angryseptagon/tDCSDisposable/photos and videos/IMG_20190513_121614.jpg

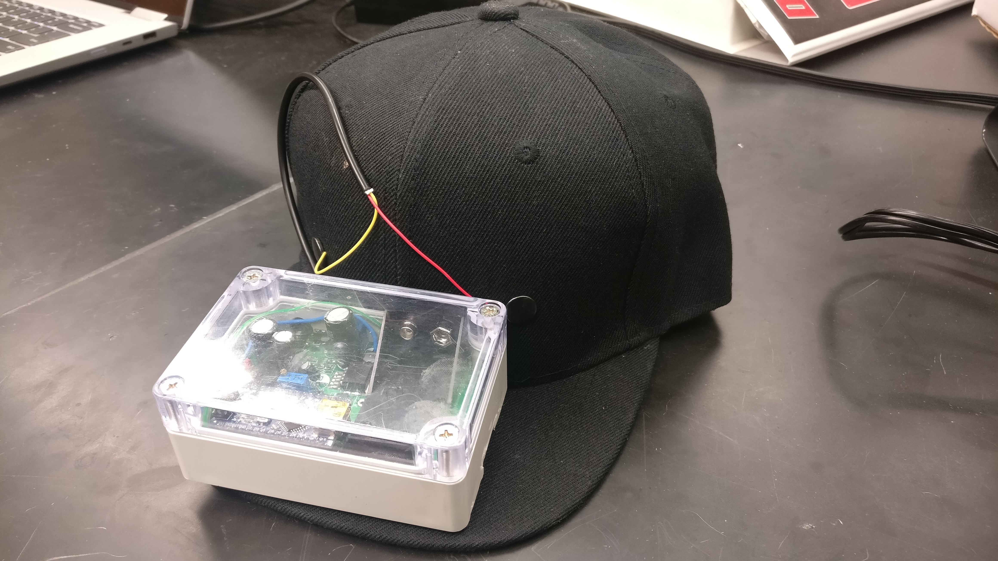
photos and videos/IMG_20190513_121614.jpg
