angryseptagon/tDCSDisposable/photos and videos/IMG_20190513_140911.jpg

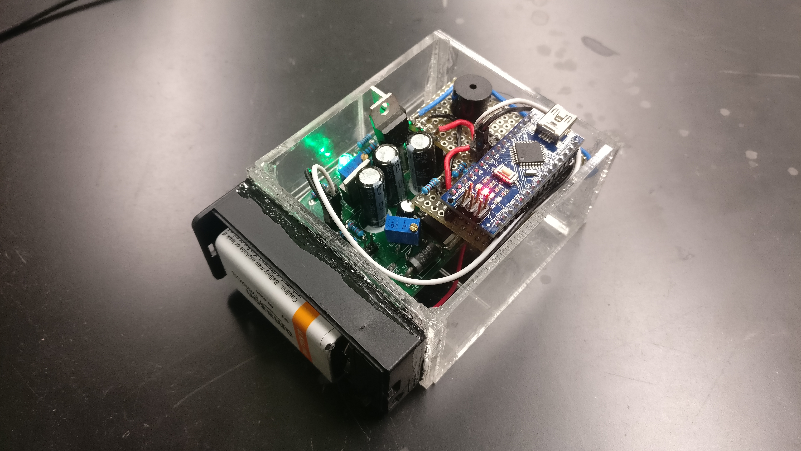
photos and videos/IMG_20190513_140911.jpg
