angryseptagon/tDCSDisposable/BrainStorming and concepts/Brainstorming web.pptx

Direct contact on the scalp

presoaked

sponge

works on the hair

expensive

cheapest but doesn't work for hairy skin

porous prong

adhesive

Electrode

carbon

expensive

disposable

Partially disposable

waveform

circuit box

not disposable

Low cost, Ready to use, Disposable tDCS

Current

~4mA

Most effective general current

Preassembled headgear

Friendly usability

Most effective general duration

Duration

10-40 mins

Least buttons to operate

Easy to use

## Brainstorming web

Low cost, ready to use, “disposable” tDCS

Power supply

disposability

Batteries in series for higher voltage

headgear

Wireless power supply (AC)

Strapped headgear

Cap headgear

10-20 3v coin cell batteries

Pulse current amplifier

2-6 9v battery

Charged capacitor buck converter

20-43v in market

Porous Prong

electrodes

carbon

Circuit design

Sponge

Premade straps

Collapsible headgear

adhesive

presoaked

Goal 14.5-18.5v
1.5 mA to 2.5 mA

too expensive

cheap

cheapest but doesn't work for hairy skin

Constant current amplifier

Use a transistor to regulate

User adjustable strap

Use an op amp to produce constant current

Use a voltage regulator to regulate

## Block diagram

Physical attachment

circuit

Power amplifier

Current redulate (zener diode )

headgear

Physical attachment

wire

Sponge
Ampoule

Electrode

## Selection Matrix

Criteria | weight | Concept 1 | Concept 2 | Concept 3 | Concept 4 | Brain stimulator v3.0
Ease of use | 3 | 1 | 1 | 1 | 1 | 0
Low Cost | 4 | 1 | 1 | 1 | 1 | 0
Environmental effect | 1 | 0 | 0 | 0 | 0 | 0
Disposability | 4 | 1 | 1 | 1 | 1 | 0
Ergonomics | 3 | -1 | 1 | -1 | -1 | 0
Waveform | 3 | 1 | 1 | 1 | 1 | 0
Weighted sum | | 11 | 14 | 11 | 11 | :0

## Concept 1: strap headgear + transistor cc + 9v battery power supply

2 mA

This strap headgear design requires some assembly but it is the most straightforward design

Circuit is one button operation

Duration is managed using a 555 timer as with other designs we will design it to turn on on button push

and then turn off in after
40 minutes

The circuit uses a transistor to manage constant current

amperage

Disposable headgear if strap material is cheap

Cost is cheap because circuit is built for just one current setting

Cost/disposability

usability

Should cost about 10$

Performed with additional circuit

30s/1mA

Low cost, Ready to use, Disposable tDCS

electrodes

duration

Ramp up/down

4cm by 4cm

Sponge electrode for comfort

Notes: http://www.scielo.br/scielo.php?script=sci_arttext&pid=S1516-44462009000500006&lng=en&nrm=iso&tlng=en

## Concept 2: Cap headgear + DC current + coin cell batteries

Headgear

Cap headgear

Cost/disposability

Low cost, ready to use, “disposable” tDCS

Sponge electrodes will be already attached to the cap. The electrodes will have small opening where saline can be poured.

disposable if material is cheap

Less than $20

DC current

2 mA

Circuit

Duration

30 minutes

Circuit is one button operation

usability

This cap headgear design requires no assembly

adhesive electrode already attached

## Concept 3: strap headgear + coin cell batteries + sponge electrode

Fixed to position

expensive

sponge

Pre salinated

Works on the hairline

electrode

Low cost, Ready to use, Disposable tDCS

User
friendly

disposable

Snap strap

duration

30 mins

2 mA

Ramp up/down

Depression/anxiety

montages

headgear

circuit

Constant current

Not disposable

3 V coin cell batteries

Power consumption

In series

Colorcode straps for easy preparation

One button stimulation

Limited settings

## Concept 4: Cap Headgear + Prong electrodes + 9V battery

Headgear with electrodes fully disposable

Partially Disposable

Disposability

Cost around $20

Prong electrode has to be customly manufactured

Increase cost

Cap is low cost

Cost

Circuit is low cost

Circuit reusable

Low cost, ready to use, “disposable” tDCS

Electrode

10 - 40 minutes

Attach circuit by snap to start stimulation

Duration

Ramp up/down

Circuit

Circuit separate from cap

Constant current

Pre-salted just add water to make saline solution

Usability

Electrode comes set up in the correct montage

Prong electrode

Electrodes require soaking with tap water

## Concept 5:

Low cost, Ready to use, Disposable tDCS
