angryseptagon/tDCSDisposable/BrainStorming and concepts/Copy of Brainstorming web - November 30, 11_58 PM.pptx

## Brainstorming web

Low cost, ready to use, “disposable” tDCS

disposability

How can we produce a safe current? (<4 mA)

headgear

Strapped headgear

Cap headgear

circuit

Porous Prong

electrodes

carbon

too expensive

Non disposable cc power supply

Pulse current amplifier

Charged capacitor buck converter

Sponge

presoaked

Batteries in series for higher voltage

2-6 9v battery

Premade straps

Collapsible headgear

adhesive

cheapest but doesn't work for hairy skin

10-20 3v coin cell batteries

20-43v in market

cheap

User adjustable strap

Goal 14.5-18.5v
1.5 mA to 2.5 mA

## Block diagram

Physical attachment

circuit

Power amplifier

Current redulate (zener diode )

headgear

Physical attachment

wire

Sponge
Ampoule

Electrode

## Slide 3

Disposability

Low cost, ready to use, “disposable” tDCS
