angryseptagon/tDCSDisposable/Senior Design - tDCS/Design Project Midterm (outline).docx

1. Background ( At least 2 pages, double spaced)
  a. What is tDCS?
    i. Biological principle
      1. How does direct current affect neuron function?
      2. Is it well understood?
        a. How is it viewed in the scientific community?
      3. What is it used to treat?
        a. How many people suffer from X condition?
          i. Percentage of population
          ii. Number of people in demanding occupations ie. surgery
          iii. Insurance coverage
    ii. Principles of device operation and function
      1. What are the general components
        a. Headgear
        b. Electrical circuit
      2. What are the devices currently used for?
        a. Clinical treatment
        b. Research purposes
        c. At home usage
  b. What are possible designs of tDCS
    i. Circuit design
      1. Constant current power supply design
      2. Simple battery circuit (no current control)
      3. Constant current supply with additional function generation
  c. What does bikson want us to do.
    i. Why does it need to be disposable?
      1. What does it mean to be disposable
    ii. What kind of product does he want?
      1. Is this a single product or multiple products
    iii. Why is simplicity to use important
2. Prior Art

---Design chart

  a. Different types of devices out in the market
    i. Properties of the devices
      1. General purpose of the device
      2. Pros and cons
    ii. What are these devices lacking with respect to the scope of our device?
  b. Headgear approaches
    i. “Full” swim cap style devices
    ii. “Free” independently placed electrodes
      1. No adjustment straps
    iii. Headgear that uses adjustable straps to place electrodes
  c. Electrode approaches
    i. Adhesive electrodes
      1. Easy to place good for disposability
      2. Bad for hairy places
    ii. Sponge electrodes
      1. Hard to place
      2. Can conduct current through hair
  d. Circuit designs
    i. Small devices (iontophoresis)
      1. Cheap and easy to use
    ii. Larger better controlled devices
      1. Better current control
      2. Safer
      3. Too bulky
      4. Features must be stripped to bare minimum
