angryseptagon/tDCSDisposable/Senior Design - tDCS/Patents_.docx

Donghyun (David) Seo

Carim-Sanni Sobur

Eric Luu

Radhanath Purakait

Shalih Miah

1. Patent Number: US20130204315A1
  a. This is a non-invasive device used to treat patients with Tinnitus.
  b. It is a self-administered device, thus can be used without a therapist present.
  c. The device has a primary and secondary electrode that ensure the stimulation is performed at the right position on the scalp.
2. Patent number: US8583238B1
  a. It is a wearable apparatus that aims to be worn during sleep it is not disposable but it is designed for comfort and long term wear as well as usability. It is optimal for patients without hair.
  b. The main selling point is that this device is user operable
3. Patent number: US20080208287A1
  a. Non-invasive device which uses two electrodes, one connected to the motor control region of the brain and one connected to a target body region to provide a treatment to neurological disorders.
  b. Treatments last between 20 to 40 minutes with a set electrical pulse at a frequency between 4 and 200 Hz.
4. Patent number: US20110288610A1
  a. Mobile device that provides an auto transcranial stimulation that can be regulated and controlled.
  b. The device comprises of a transportable stimulation generator and a current generator with an accessible user interface for selecting different programs.
5. Patent Number: US8239030B1
  a. This device utilizes a full headgear design, it is not cost effective however the design is flexible and could be used to design similarly disposable tdcs devices.
6. Patent number: US20140148872A1
  a. Wearable device, it can be self-contained in electrode pads.this is a very good device for hairless skin. It is not disposable and can be complex to use out of the box, has a wide feature set for what is needed. However pad placement is up to the user and makes usability worse
7. Patent number: US20130079659A1
  a. Circuit that’s designed to be reusable; electrodes are used to perform both tDCS and EEG, and automatically alternating EEG collection and tDCS application
  b. EEG and tDCS functionalities are integrated into a single headset
8. Patent number:WO2009137683A2
a. The device is portable tDCS which is suitable for home or clinical tDCS treatment.
b. It comprises of a chin strap and a mesh portion.
c. It is in form of a hat with a rigid outer shell and flexible outer portion.
d. The placement of the electrodes with respect to the inner surface of the cap is selectively variable.
9. Patent number: CN107155309A
a. This device is a head mounted brain therapeutic device with ultrasonic stimulation.
b. Sound field is generated by the 2-D array transducer which performs the stimulation to the focus position.
10. Patent number: US20140257448
a. Head wearable brain stimulating device (hat-like design).
b. It contains a pulse generator and two electrodes.
c. Place the patches on desired spots of the head scalp to send an electrical pulse to stimulate the desired part of the brain.

B
