angryseptagon/tDCSDisposable/Senior Design - tDCS/Product Design specification.docx

Donghyun (David) Seo, Sobur Carim Sanni, Radhanath Purakait, Eric Luu, Shalih Miah

Team TDCS assignment

Project Description Specification

1. Electrical Safety
  a. Current amplitude
    i. The current needs to below a certain limit to prevent skin and neural damage, up to 2 mA (milliamperes) DC.
    ii. Current would be specified on the headgear with a label.
  b. Electrode interactions
    i. Electrodes must use an electrolyte, and the cuttent must not pass through metal or rubber materials as this can cause undesirable chemical interactions. (https://www.sciencedirect.com/science/article/pii/S1388245715010883)
    ii. Electrode size matters, high current (1mA) requires larger electrodes (larger than 4 cm × 4 cm).
    iii. Long term exposure and excessive current can cause itching and redness and skin damage, electrical safety mechanism to automatically stop current should be implemented.
  c. Component selection/consistency
    i. Components selected should have correct tolerances to be safe within physiological current and voltage limits.
    ii. Devices should be reliable between each other to provide consistent current output.
  d. Dosage
    i. Dosage should not exceed 30 minutes (https://www.ncbi.nlm.nih.gov/pmc/articles/PMC2754807/)
  e. Safety precautions
    i. The device should come with simple and clear instructions on the device itself to prevent misuse. However, actual use of the device should be intuitive.
  f. Battery safety
    i. A shelf stable alkaline battery should be used to power the device, it doesn't need to be reusable or high capacity.
  g. Contact quality and material: electrodes connected to the sponge. Use fasteners to tight it if needed.
  h. Ramp up and down current
    i. gradually increasing current for safety. Increases by 0.05 mA before reaching actual current.
    ii. Few minutes before the session end the stimulation, it will slowly lower the current until it eventually powers down. (One use).
  i. Voltage protection: the device has a voltage limit and would not exit reasonable voltage (9 V suggested).
2. Low cost and environmental safety
  a. This is a very cheap and easy to make device, as it only should costs 15 dollars or less.
  b. The materials that should be used range from resistors, potentiometer, batteries, wires, pcb board, nfc chip. All are low cost.
  c. The circuit should be enclosed with fabric, plastic, or special paper to be safe to handle.
  d. Circuit should be protected from moisture of electrodes in individual package
3. Ergonomics:
  a. One person should be able to operate the device.
  b. Device has an option for powering on/off.
  c. The wires connecting to the electrodes are long enough so that the user can place the device in his/her pocket.
    i. Preferably the headgear is already attached to the circuit with no need to connect wires.
    ii. The PCB can be flexible to fit on the head.
  d. Device should be ready to go once opening.
  e. User should not have to think about pad placement and voltage. It should be hands free operation.
  f. Electrodes and cheap headgear needs to be designed for this device
    i. Headgear should accommodate different head sizes.
4. Size and Weight Restrictions:
  a. Weight should not exceed 1 lbs.
  b. Length should not exceed 6 in.
  c. Width should not exceed 6 in.
  d. Height should not exceed 6 in.
  e. Should be able to be packaged in a simple plastic bag with electrode safely.
5. User Interface Design
  a. Buttons/controls: Power/Start button, buttons for each duration/power (current).
    i. Sponsor has indicated that the duration and amperage for individual devices may not need to be changeable by user but by manufacturer.
  b. Packages should be clearly labeled with current rating.
  c. The user should be able to pull the device out of the bag without safety precautions and be able to use it immediately.
  d. Device should be for specific application.
  e. Montage specification
    i. Different montage headgear should be sold with devices rated for specific currents.
    ii. Device specifications should be easy to modify at factory.
    iii. Packages are designed for individual use cases.
6. “Stretch“ goals
  a. User changeable current
    i. Our device should at least be able to have settings that can let the user choose current within safe range.
    ii. Universal application depending on the complexity.
  b. Give user ability to change waveform.
  c. One important feature is sterilizability, if possible it should make the product stand out for uses in sterile environments like operation rooms (mentioned by sponsor).
