angryseptagon/tDCSDisposable/Senior Design - tDCS/Project description specification (Draft).docx

Donghyun (David) Seo, Sobur Carim Sanni, Radhanath Purakait, Eric Luu, Shalih Miah

Team TDCS assignment

Project Description Specification

1. Electrical Safety
  a. Current amplitude
    i. The current needs to below a certain limit to prevent skin and neural damage
    ii. A display for the current limits should be implemented for better user control and safety
  b. Electrode interactions
    i. Electrodes must use an electrolyte, and the current must not pass through metal or rubber materials as this can cause undesirable chemical interactions (https://www.sciencedirect.com/science/article/pii/S1388245715010883)
    ii. Electrode size matters, high current (1mA) requires larger electrodes (larger than 4 cm × 4 cm).
    iii. Long term exposure and excessive current can cause itching and redness
  c. Component selection
    i. Components selected should have correct tolerances to be safe within physiological current and voltage limits
    ii. Devices should be reliable between each other to be to provide consistent performance
  d. Dosage
    i. Dosage should not exceed 0-2 milliamps for a 20 minute dose (https://www.ncbi.nlm.nih.gov/pmc/articles/PMC2754807/)
    ii. Our device should at least be able to have settings that can let the user choose current within safe range
  e. Instructions for users
    i. The device should come with simple and clear instructions on the device itself to prevent misuse.
    ii. It should also include a helpful chart regarding electrode size and current settings to help patients prevent skin burns.
  f. Battery safety
    i. A shelf stable alkaline battery should be used to power the device, it doesn't need to be reusable or high capacity.
  g. Contact quality and material: electrodes connected to the sponge. Use fasteners to tight it if needed.
  h. Constant current: users are guaranteed constant current as battery life would not affect the current.
  i. Safety: gradually increasing current for safety. Increases by 0.05mA before reaching actual current.
  j. Voltage protection: the device has a voltage limit and would not exit reasonable voltage (9 V suggested)
2. Low cost and environmental safety
  a. This is a very cheap and easy to make device, as it only should costs around 20 dollars.
  b. The materials that could be used range from resistors, potentiometer, batteries, wires, pcb board, nfc chip. All are low cost.
  c. The circuit could be enclosed with fabric, plastic, or special paper.
    i. Circuit should be protected from moisture of electrodes in package
  d. One important feature is sterilizability, if possible it could make the product stand out
3. Ergonomics:
  a. One person should be able to operate
  b. Device has an option for powering on/off and adjusting voltage
  c. The wires connecting to the electrodes are long enough so that the user can place the device in his/her pocket.
  d. Signal to notify user when the treatment is in progress/finished
  e. Device should be ready to go once opening
  f. User shouldn't have to think so much about pad placement and voltage it should be a relatively hands free operation. And allow easy movement.
  g. Headgear should be unhindered and preferably attached to the device
4. Size and Weight Restrictions:
  a. Weight should not exceed 1 lbs.
  b. Length should not exceed 12 in
  c. Width should not exceed 12 in
  d. Height should not exceed 12 in
  e. Should be able to be packaged in a simple plastic bag with electrode safely
5. User Design
  a. Buttons/controls: Power button, start button, power (current) slide, low battery sign led.
  b. Power (current): 0 mA ~ 2mA.
  c. Duration (min): could be a fixed duration for example 20 min. Sponsor has indicated that the duration and amperage for individual devices may not need to be changeable by user but by manufacturer. Few minutes before the session end the stimulation it will slowly lower the current until it eventually powers down. (One use).
  d. The user should be able to pull the device out of the bag without instructions and be able to use it immediately
  e. The main idea as the sponsor puts it is to make the product cheap and not “fussy” give the user little room to mess up
  f. Electrodes and cheap headgear needs to be designed for this device
  g. It could accommodate different
  h. Device could be for specific application or universal application depending on the complexity.
