angryseptagon/tDCSDisposable/Senior Design - tDCS/PowerPoints/Senior Design 2 Midterm Presentation.pptx

## tDCS Hat Device

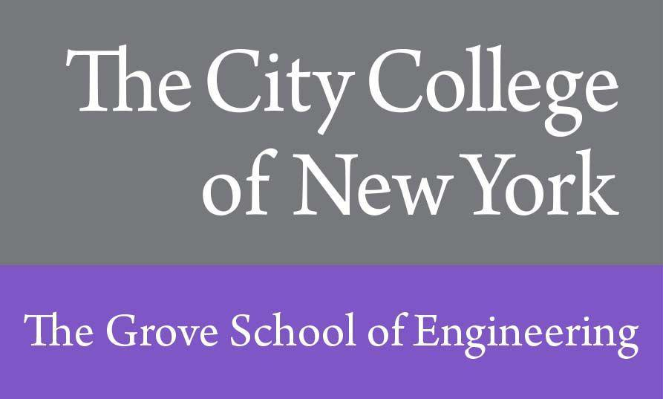
[picture p25: figure]

Team: Donghyun (David) Seo, Carim-Sanni Sobur, Eric Luu, Radhanath Purakait and Shalih Miah
BME 4500: Biomedical Engineering Senior Design
Sponsor: Dr. Marom Bikson
Faculty Mentor: Professor Alessandra Carriero
TA: Jack Twiddy, Evan Azoulay

## Need Statement

Need to find a way to make a low cost tDCS device that can be disposed after a single dose (20~40 minutes).

## Slide 3

System block diagram

`

Headgear

Sponge 100%

Snap on pin

Conductive rubber

Snap on pin + wires

Adjustable strap

Hat 80%

Contact Quality 70%

Impedance

Saline

Is attached to

Circuit

Constant current supply

Provides high voltage

100%

Ramp generator

To control

70%

User control/ safety mechanisms

40%

Dead man “switch”

Power source

Circuit (with BJT)

Control circuit

Arduino code

Timing (with MCU)
