angryseptagon/tDCSDisposable/Senior Design - tDCS/Timeline/timeline V1.0.docx

Week 1) 1/29/2019

Circuit:

- Work on testing ordered components

- Confirm design on pulsed current stimulators

- Confirm design of constant current stimulator

-start building constant current circuit

Headgear:

- Meet with professor who knows how to put snaps on

Week 2) 2/05/2019

Circuit: complete order to be processed by dr.qiu

Study different circuit designs as alternatives

Headgear:

- Order hats, pins, wires

-test how to put snap pins on hat

Week 3) 2/12/2019

Circuit:add additional components in case of design change

Headgear:

- Test mounting the circuit box on the hat

Week 4) 2/19/2019

Circuit:

-start testing constant current circuit with simulated load

-attach electrodes

Headgear:

Week 5) 2/26/2019

Circuit:

-build electrodes with breadboard design

-start designing PCB

Headgear:

Week 6) 3/05/2019

Circuit:

Headgear:

Week 7) 3/12/2019

Circuit:

Headgear:

Week 8) 3/19/2019

Circuit:

Headgear:

Week 9) 3/26/2019

Circuit:

Headgear:

Week 10) 4/02/2019

Circuit:

Headgear:

Week 11) 4/09/2019

Circuit:

Headgear:

Week 12) 4/16/2019

Circuit:

Headgear:

Week 13) 4/30/2019

Circuit:

Headgear:

Week 14) 5/07/2019

Circuit:

Headgear:

Week 15) 5/14/2019

Circuit:

Headgear:
