angryseptagon/tDCSDisposable/Senior Design - tDCS/Timeline/Copy of timeline V1.1 - February 8, 3_40 PM.xlsx

Senior Design tDCS group #4
 | Project Lead:
 | Project Start Date: |  |  | 2019-01-29 |  |  |  |  | 2019-01-28 | 2019-01-29 | 2019-01-30 | 2019-01-31 | 2019-02-01 | 2019-02-02 | 2019-02-03 | 2019-02-04 | 2019-02-05 | 2019-02-06 | 2019-02-07 | 2019-02-08 | 2019-02-09 | 2019-02-10 | 2019-02-11 | 2019-02-12 | 2019-02-13 | 2019-02-14 | 2019-02-15 | 2019-02-16 | 2019-02-17 | 2019-02-18 | 2019-02-19 | 2019-02-20 | 2019-02-21 | 2019-02-22 | 2019-02-23 | 2019-02-24 | 2019-02-25 | 2019-02-26 | 2019-02-27 | 2019-02-28 | 2019-03-01 | 2019-03-02 | 2019-03-03 | 2019-03-04 | 2019-03-05 | 2019-03-06 | 2019-03-07 | 2019-03-08 | 2019-03-09 | 2019-03-10 | 2019-03-11 | 2019-03-12 | 2019-03-13 | 2019-03-14 | 2019-03-15 | 2019-03-16 | 2019-03-17 | 2019-03-18 | 2019-03-19
 | Display Week: |  |  | 1 |  |  |  |  | Week 1 |  |  |  |  |  |  | Week 2 |  |  |  |  |  |  | Week 3 |  |  |  |  |  |  | Week 4 |  |  |  |  |  |  | Week 5 |  |  |  |  |  |  | Week 6 |  |  |  |  |  |  | Week 7 |  |  |  |  |  |  | Week 8
 |  |  |  |  |  |  |  |  | 2019-01-28 |  |  |  |  |  |  | 2019-02-04 |  |  |  |  |  |  | 2019-02-11 |  |  |  |  |  |  | 2019-02-18 |  |  |  |  |  |  | 2019-02-25 |  |  |  |  |  |  | 2019-03-04 |  |  |  |  |  |  | 2019-03-11 |  |  |  |  |  |  | 2019-03-18
WBS | Task | Lead | Prede cessor | Start | End | Cal. Days | % Done | Work Days | M | T | W | T | F | S | S | M | T | W | T | F | S | S | M | T | W | T | F | S | S | M | T | W | T | F | S | S | M | T | W | T | F | S | S | M | T | W | T | F | S | S | M | T | W | T | F | S | S | M | T
1 | Concept Selection and Ordering Materials
1.1 | Team Meeting #1 | All Members |  | 2019-01-29 | 2019-01-29 | 1 | 100% | 1
1.2 | test component order 1 | Carim Radhanath Shalih |  | 2019-01-30 | 2019-02-05 | 7 | 50% | 5
1.3 | test powersupplys | Carim Radhanath Shalih |  | 2019-02-06 | 2019-02-09 | 4 | 50% | 3
1.4 | meet with evan | all members |  | 2019-01-31 | 2019-01-31 | 1 | 100% | 1
2 | Designing and assembling prototype circuit |  |  |  |  |  |  | 0
2.1 | meet with Jack | Carim Radhanath Shalih |  | 2019-02-04 | 2019-02-04 | 1 | 100% | 1
2.2 | test design 1, the inthinkerator | Carim Radhanath Shalih |  | 2019-01-30 | 2019-02-05 | 7 | 50% | 5
2.3 | revise cc design to account for higher current | Carim Radhanath Shalih |  | 2019-02-06 | 2019-02-12 | 7 | 50% | 5
2.4 | design timing subsystem | Carim Radhanath Shalih |  | 2019-02-15 | 2019-02-28 | 14 | 100% | 10
2.5 | build timing subsystem | Carim Radhanath Shalih |  | 2019-02-28 | 2019-03-01 | 2 | 100% | 2
2.6 | Functional Prototype for circuit | All member |  | 2019-02-26 | 2019-03-04 | 7
2.7 | electrode grounding circuit | Carim Radhanath Shalih |  | 2019-03-06 | 2019-03-15 | 10
3 | prototype Headgear |  |  |  |  |  |  | 0
3.1 | test electrode placement | Eric and David |  | 2019-02-07 | 2019-02-08 | 2 | 0% | 2
3.2 | Snap on pin and Meeting with ME prof (attach pins on test hat) | Radhanath, Eric and David |  | 2019-02-06 | 2019-02-06 | 1 | 100% | 1
3.3 | electrode positioning and headgear adjustment | Eric and David |  | 2019-02-07 | 2019-02-12 | 5 | 0% | 4
3.4 | test different caps | Eric and David |  | 2019-02-14 | 2019-02-28 | 14 | 0% | 11
4 | manufacture circuit |  |  |  |  |  |  | 0
4.1 | design PCB | Carim Radhanath Shalih |  | 2019-03-11 | 2019-03-13 | 3 |  | 3
4.2 | order PCB (assuming JLC PCB) | manufacturer |  | 2019-03-14 | 2019-03-20 | 7 |  | 5
4.3 | build + design box |  |  | 2019-03-15 | 2019-03-18 | 4 |  | 2
4.4 | Team Report/ Presentation | All Member |  | 2019-03-19 | 2019-03-25 | 7 |  | 5
5 | integrate design of headear and circuit |  |  |  |  |  |  | 0
5.1 | Mechanical design of circuit possitioning | All Members |  | 2019-03-30 | 2019-04-02 | 4 | 0% | 2
5.2 | Wire positioning | All Members |  | 2019-04-02 | 2019-04-05 | 4 | 0% | 4
5.3 | Electrode ergonomics | All Members |  | 2019-04-06 | 2019-04-07 | 2 |  | 0
5.4 | User Experience Testing | All Members |  | 2019-04-08 | 2019-04-28 | 21 |  | 15
6 | Final Report and Presentation |  |  |  |  | 1 |  | 0
6.1 | Prepare for BME day (presentation) | All Members |  | 2019-04-30 | 2019-05-06 | 7 | 0% | 5
6.2 | Prepare for BME day | All Members |  | 2019-05-07 | 2019-05-10 | 4 | 0% | 4
6.3 | Prepare Presentation | All Members |  | 2019-05-07 | 2019-05-13 | 7 | 0% | 5
6.4 | Write Report | All Members |  | 2019-05-11 | 2019-05-13 | 3 | 0% | 1
6.5 |  |  |  |  |  |  |  | 0
6.6 |  |  |  |  |  |  |  | 0
6.7 |  |  |  |  |  |  |  | 0
6.8 |  |  |  |  |  |  |  | 0
6.9 |  |  |  |  |  |  |  | 0
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
