angryseptagon/tDCSDisposable/Senior Design - tDCS/Timeline/timeline V1.2.xlsx

Senior Design tDCS group #4
 | Project Lead:
 | Project Start Date: |  |  | 2019-01-29 |  |  |  |  | 2019-01-28 | 2019-01-29 | 2019-01-30 | 2019-01-31 | 2019-02-01 | 2019-02-02 | 2019-02-03 | 2019-02-04 | 2019-02-05 | 2019-02-06 | 2019-02-07 | 2019-02-08 | 2019-02-09 | 2019-02-10 | 2019-02-11 | 2019-02-12 | 2019-02-13 | 2019-02-14 | 2019-02-15 | 2019-02-16 | 2019-02-17 | 2019-02-18 | 2019-02-19 | 2019-02-20 | 2019-02-21 | 2019-02-22 | 2019-02-23 | 2019-02-24 | 2019-02-25 | 2019-02-26 | 2019-02-27 | 2019-02-28 | 2019-03-01 | 2019-03-02 | 2019-03-03 | 2019-03-04 | 2019-03-05 | 2019-03-06 | 2019-03-07 | 2019-03-08 | 2019-03-09 | 2019-03-10 | 2019-03-11 | 2019-03-12 | 2019-03-13 | 2019-03-14 | 2019-03-15 | 2019-03-16 | 2019-03-17 | 2019-03-18 | 2019-03-19
 | Display Week: |  |  | 1 |  |  |  |  | Week 1 |  |  |  |  |  |  | Week 2 |  |  |  |  |  |  | Week 3 |  |  |  |  |  |  | Week 4 |  |  |  |  |  |  | Week 5 |  |  |  |  |  |  | Week 6 |  |  |  |  |  |  | Week 7 |  |  |  |  |  |  | Week 8
 |  |  |  |  |  |  |  |  | 2019-01-28 |  |  |  |  |  |  | 2019-02-04 |  |  |  |  |  |  | 2019-02-11 |  |  |  |  |  |  | 2019-02-18 |  |  |  |  |  |  | 2019-02-25 |  |  |  |  |  |  | 2019-03-04 |  |  |  |  |  |  | 2019-03-11 |  |  |  |  |  |  | 2019-03-18
WBS | Task | Lead | Prede cessor | Start | End | Cal. Days | % Done | Work Days | M | T | W | T | F | S | S | M | T | W | T | F | S | S | M | T | W | T | F | S | S | M | T | W | T | F | S | S | M | T | W | T | F | S | S | M | T | W | T | F | S | S | M | T | W | T | F | S | S | M | T
1 | Concept Selection and Ordering Materials
1.1 | Team Meeting ( every Thursday) | All Members |  | 2019-01-29 |  |  | 100%
1.2 | test component order 1 | Carim Radhanath Shalih |  | 2019-01-30 | 2019-02-05 | 7 | 100% | 5
1.3 | test powersupplys | Carim Radhanath Shalih |  | 2019-02-06 | 2019-02-09 | 4 | 100% | 3
1.4 | meet with evan ( every Thursday at 11 am ) | All members |  | 2019-01-31 |  | 8 | 100% | 0
2 | Designing and assembling prototype circuit
2.1 | meet with Jack ( every Thursday and Friday) | Carim Radhanath Shalih |  | 2019-02-04 |  | 12 | 100% | 0
2.2 | test design 1, the inthinkerator | Carim Radhanath Shalih |  | 2019-01-30 | 2019-02-20 | 22 | 100% | 16
2.3 | revise cc design to account for higher resistance | Carim Radhanath Shalih |  | 2019-02-21 | 2019-02-27 | 7 | 100% | 5 |  |  |  |  |  |  |  |  |  |  |  |  |  |  |  |  |  |  |  |  |  |  |  |  |  |  |  |  |  |  |  |  |  |  |  |  |  |  |  |  |  |  | 0
2.4 | design timing subsystem | Carim Radhanath Shalih |  | 2019-02-25 | 2019-03-10 | 14 | 100% | 10
2.5 | build timing subsystem | Carim Radhanath Shalih |  | 2019-03-10 | 2019-03-20 | 10 | 100% | 8
2.6 | Functional Prototype for circuit | All member |  | 2019-01-30 | 2019-03-20 | 7 | 100% | 36
2.7 | design testing methods | All member |  | 2019-03-06 | 2019-03-15 | 10 | 100% | 8
2.8 | Applying testing methods | All member |  | 2019-02-19 | 2019-05-01 | 7 | 100% | 52
2.9 | develop head detection safety mechanism | Carim Radhanath Shalih |  | 2019-02-20 | 2019-03-15 | 24 | 100% | 18
3 | prototype Headgear |  |  |  |  |  | 100%
3.1 | test electrode placement | Eric and David |  | 2019-02-07 | 2019-02-08 | 2 | 100% | 2
3.2 | Snap on pin and Meeting with ME prof (attach pins on test hat) | Radhanath, Eric and David |  | 2019-02-06 | 2019-02-06 | 1 | 100% | 1
3.3 | electrode positioning and headgear adjustment | Eric and David |  | 2019-02-07 | 2019-02-11 | 5 | 100% | 3
3.4 | test different caps | Eric and David |  | 2019-02-14 | 2019-02-27 | 14 | 100% | 10
3.5 | prototype 1 | Eric and David |  | 2019-02-10 | 2019-02-16 | 7 | 100% | 5
3.6 | prototype 2 | Eric and David |  | 2019-02-17 | 2019-02-23 | 7 | 100% | 5
3.7 | testing cap impedance | Eric and David |  | 2019-02-26 | 2019-02-28 | 3 | 100% | 3
3.8 | methods to lower cap impedance | Eric and David |  | 2019-03-01 | 2019-03-07 | 7 | 100% | 5
3.9 | improve electrode contact | Eric and David |  | 2019-03-08 | 2019-03-14 | 7 | 100% | 5
3.10 | ease of use testing | Eric and David |  | 2019-03-15 | 2019-03-21 | 7 | 100% | 5
3.11 | strap testing | Eric, David and Carim |  | Tues 3/12/19 | 2019-03-22 | 11 | 100% | 6
3.12 | impedance test with hydrophobic spray | Eric, David and Carim |  | Tues 3/26/19 | Tues 3/26/19 | 1 | 100% | 1
3.13 | testing higher concentration of saline | Eric, David and Carim |  | 2019-03-28 | Tues 4/2/19 | 6 | 100% | 3
3.14 | test concentration montage | Eric, David and Carim |  | 2019-04-04 | Tues 4/9/19 | 6 | 100% | 3
3.14a | strap and headgear design of concentration montage | Eric, David and Carim |  | 2019-04-11 | Tues 4/16/19 | 6 | 100% | 3
1 | manufacture circuit |  |  |  |  |  | 100%
1.1 | design PCB | Carim Radhanath Shalih |  | 2019-03-11 | 2019-03-20 | 3 | 100% | 8
1.2 | order PCB (assuming JLC PCB) | manufacturer |  | 2019-03-14 | 2019-03-20 | 7 | 100% | 5
1.3 | build + design box | Eric and David |  | 2019-03-15 | 2019-03-18 | 4 | 100% | 2
1.4 | Team Report/ Presentation | All Member |  | 2019-03-19 | 2019-05-05 |  | 100% | 34
2 | integrate design of headear and circuit |  |  |  |  |  | 100%
2.1 | Mechanical design of circuit possitioning | All Members |  | 2019-03-30 | 2019-04-02 | 4 | 100% | 2
2.2 | Wire positioning | All Members |  | 2019-04-02 | 2019-04-05 | 4 | 100% | 4
2.3 | Electrode ergonomics | All Members |  | 2019-04-06 | 2019-04-07 | 2 | 100% | 0
2.4 | User Experience Testing | All Members |  | 2019-04-08 | 2019-04-28 | 21 | 100% | 15
3 | Final Report and Presentation |  |  |  |  | 1 | 100%
3.1 | Prepare for BME day (presentation) | All Members |  | 2019-04-30 | 2019-05-06 | 7 | 100% | 5
3.2 | Prepare for BME day | All Members |  | 2019-05-07 | 2019-05-10 | 4 | 100% | 4
3.3 | Prepare Presentation | All Members |  | 2019-05-07 | 2019-05-13 | 7 | 100% | 5
3.4 | Write Report | All Members |  | 2019-05-11 | 2019-05-13 | 3 | 100% | 1
3.5 |  |  |  |  | #REF! |  |  | #REF!
3.6 |  |  |  |  |  |  |  | 0
3.7 |  |  |  |  |  |  |  | 0
3.8 |  |  |  |  |  |  |  | 0
3.9 |  |  |  |  |  |  |  | 0
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
