angryseptagon/tDCSDisposable/Minutes/Minutes #18.docx

Minutes #18

11/15/18

11:30 PM - 12:30 PM

Attendance

Donghyun (David) Seo, Sobur Carim Sanni, Radhanath Purakait, Eric Luu, Shalih Miah

Meeting among the group members.

Brainstorming

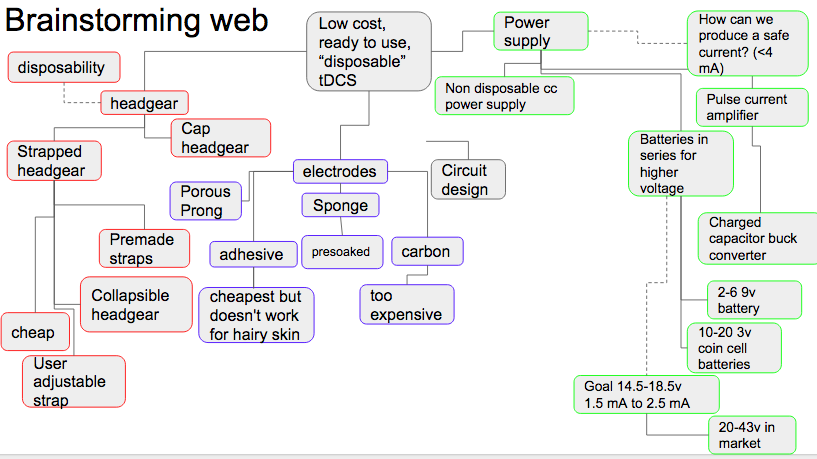
[picture p49: figure]
