angryseptagon/tDCSDisposable/Minutes/Minutes #6.docx

Minutes #6

9/25/18

After senior design class 12:10 PM - 12:50 PM

Attendance

Donghyun (David) Seo, Sobur Carim Sanni, Radhanath Purakait, Eric Luu, Shalih Miah

We tried on the ‘iontopatch’ (patches we received during meeting #4 with Dr. Bikson) to see how it works and have better ideas in terms of wearing, design, and contents.

Next meeting time: Saturday 5 pm

Due next meeting: research about TDCS patents
