angryseptagon/tDCSDisposable/Minutes/Minutes #7.docx

Minutes #7

9/29/18

5:00 PM - 6:00 PM

Attendance

Donghyun (David) Seo, Sobur Carim Sanni, Radhanath Purakait, Eric Luu, Shalih Miah

- Shared and combined the patents of TDCS on a google document and made a chart from our researches.
- Discussed how to make our device unique so that we can attain our own patent.
- Came up with an idea that our unique part among the ones in the market is the disposability.
