angryseptagon/tDCSDisposable/reciepts/content.pdf

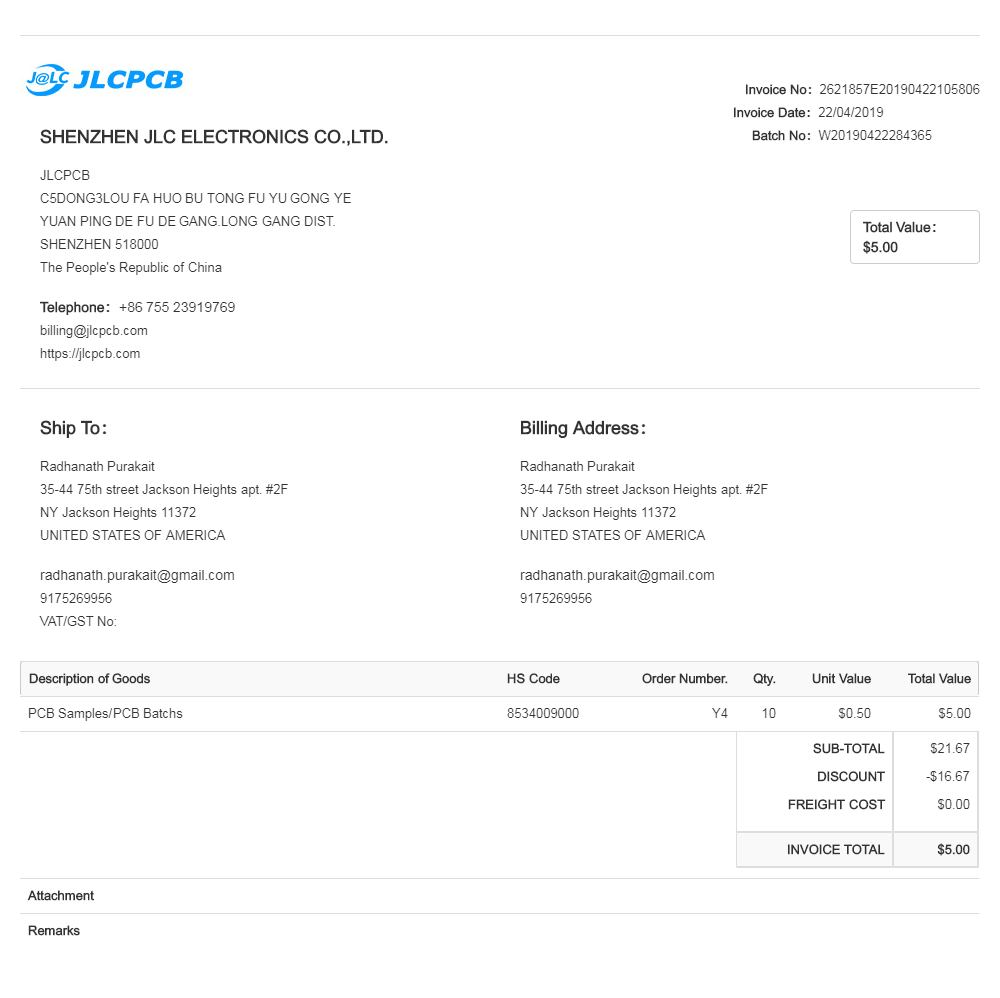
[picture p50: page 1]
