angryseptagon/tDCSDisposable/circuit/20190307_183605.jpg

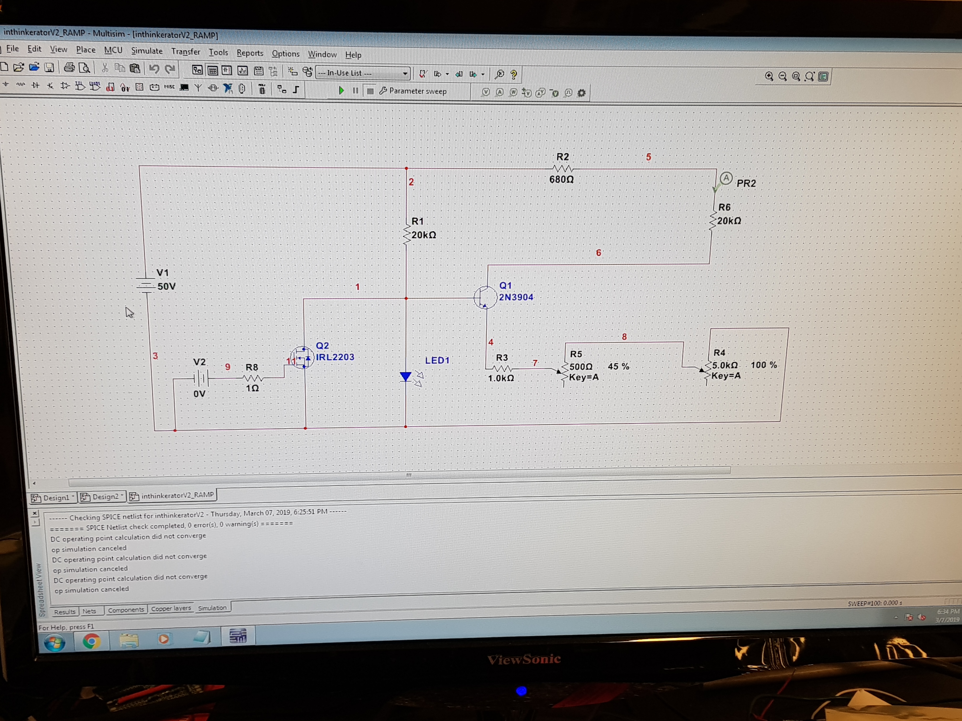
circuit/20190307_183605.jpg
