angryseptagon/tDCSDisposable/circuit/20190307_183616.jpg

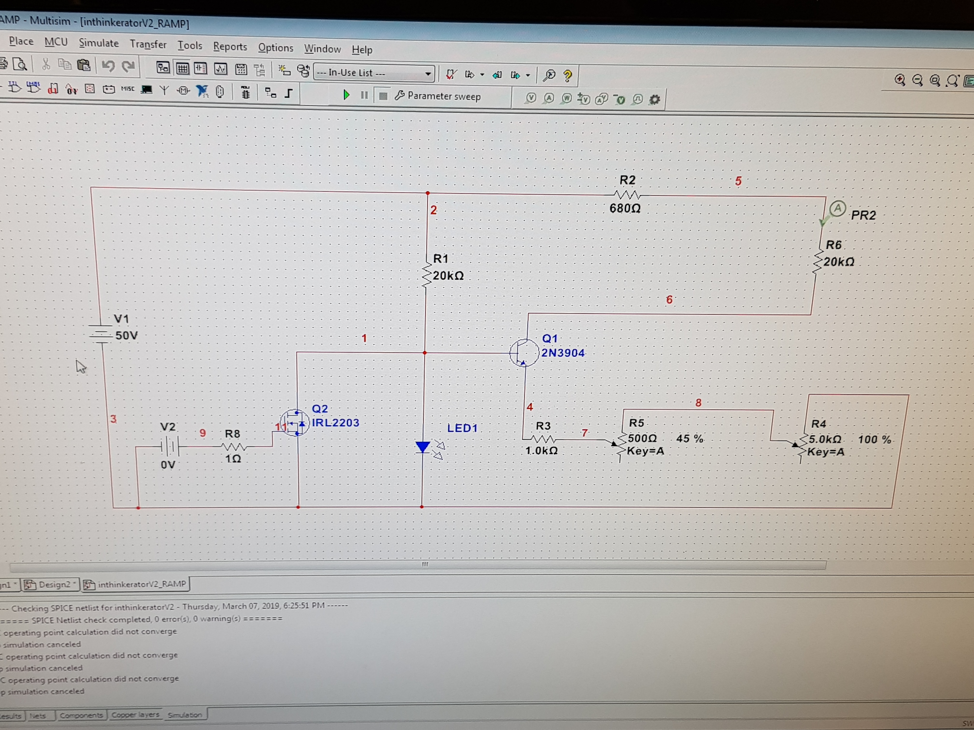
circuit/20190307_183616.jpg
