angryseptagon/tDCSDisposable/circuit/circuit output data/Capture.PNG

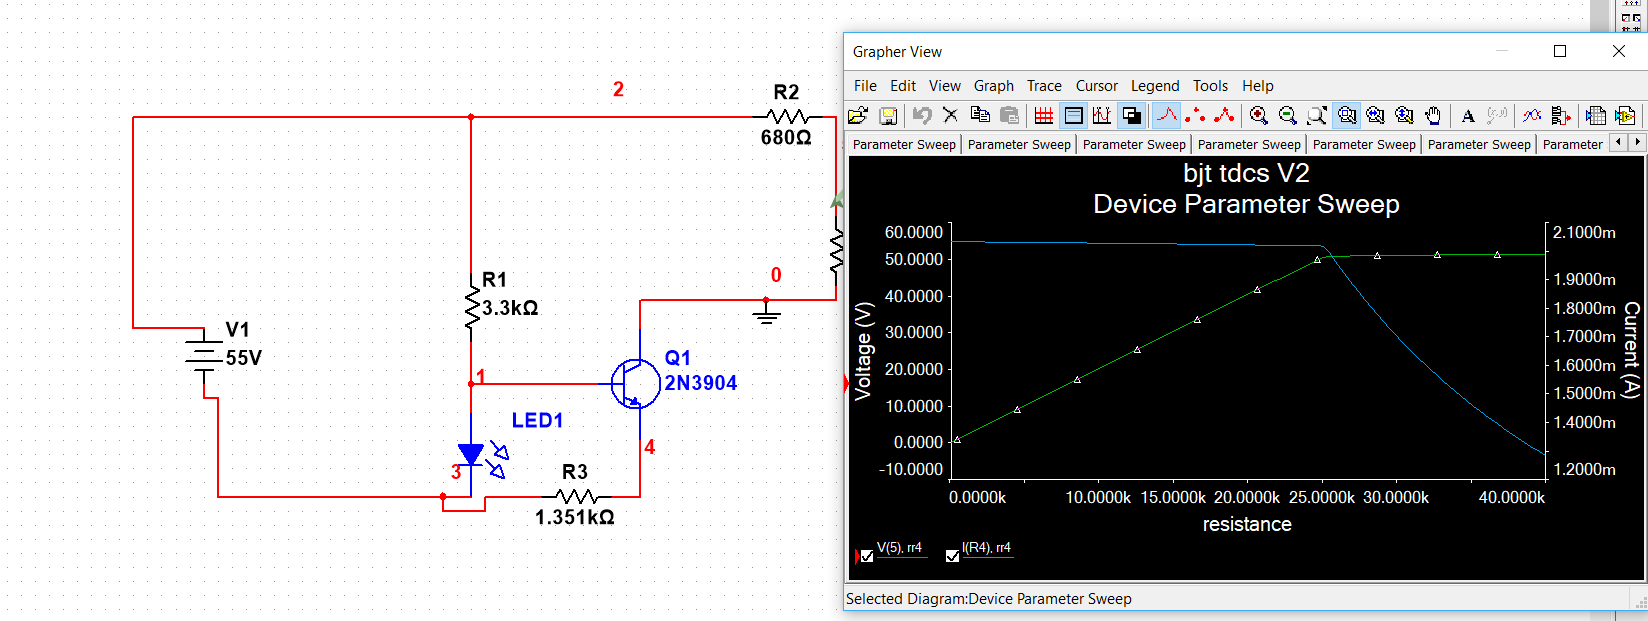
circuit/circuit output data/Capture.PNG
