angryseptagon/tDCSDisposable/circuit/InthinkeratorSimulation.PNG

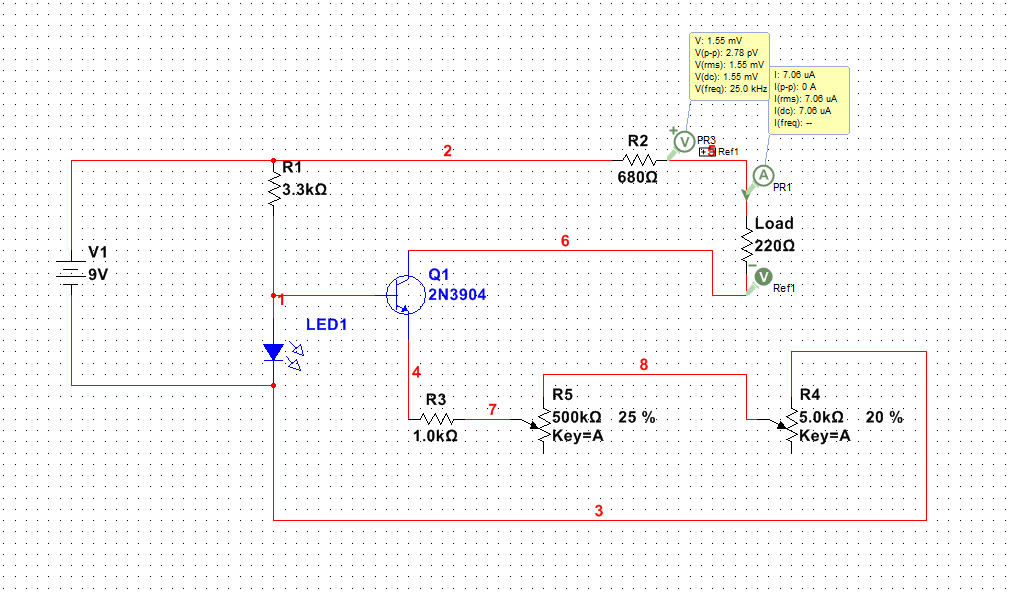
circuit/InthinkeratorSimulation.PNG
