angryseptagon/tDCSDisposable/circuit/mosfet control sweep.PNG

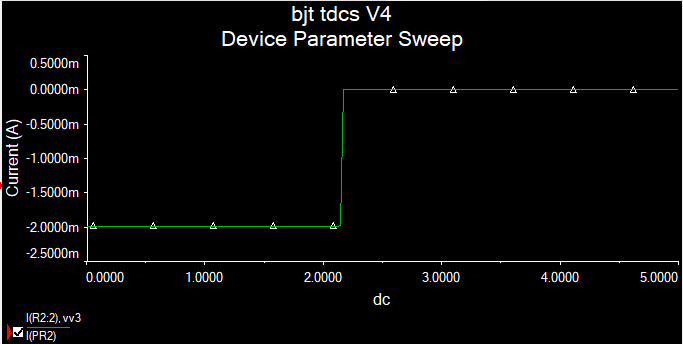
circuit/mosfet control sweep.PNG
