angryseptagon/tDCSDisposable/circuit/R6@180ohm.PNG

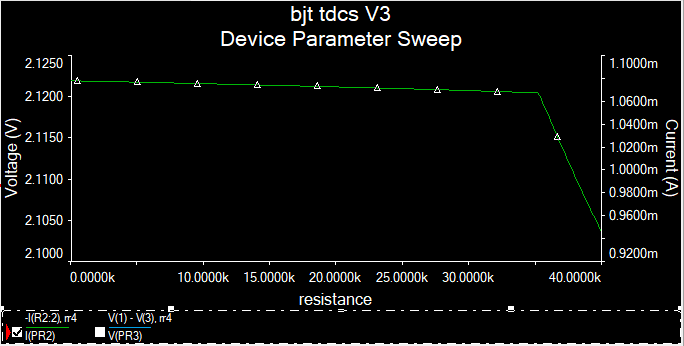
circuit/R6@180ohm.PNG
