angryseptagon/tDCSDisposable/circuit/R6@240.PNG

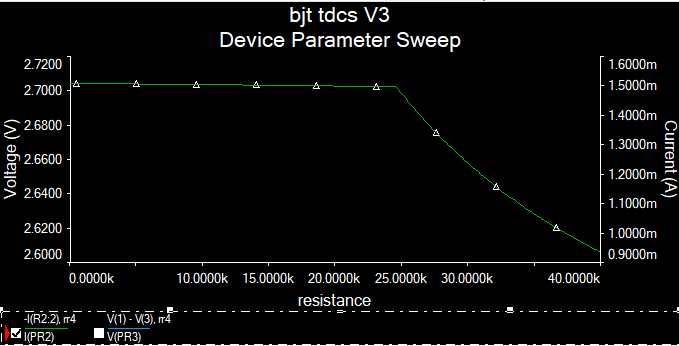
circuit/R6@240.PNG
