angryseptagon/tDCSDisposable/circuit/ramp sweep.PNG

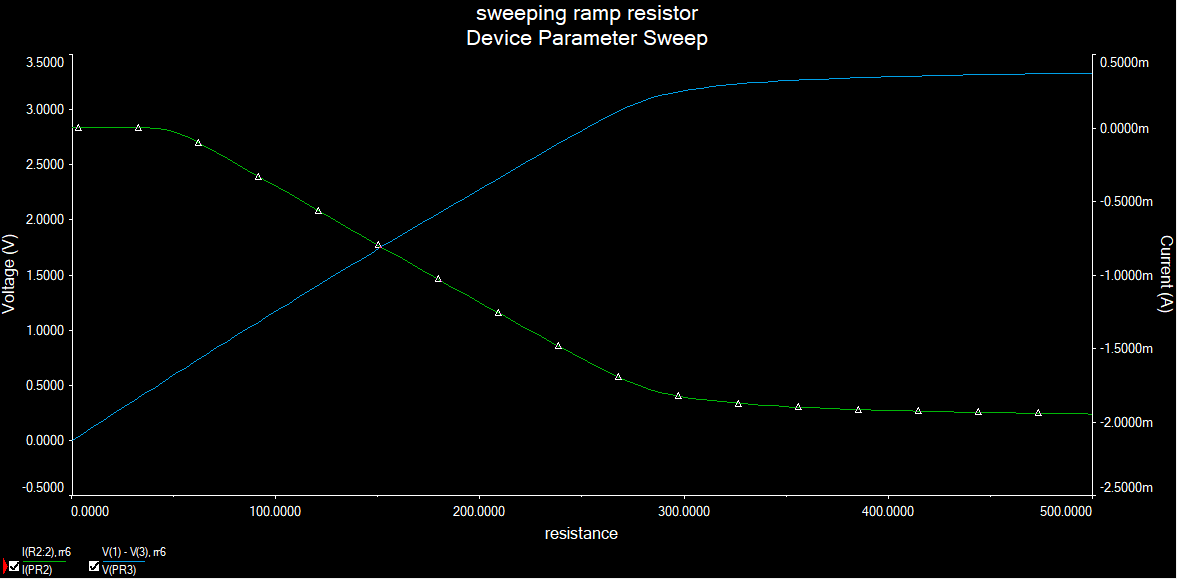
circuit/ramp sweep.PNG
