angryseptagon/tDCSDisposable/circuit/tDCS/3dview pcb.png

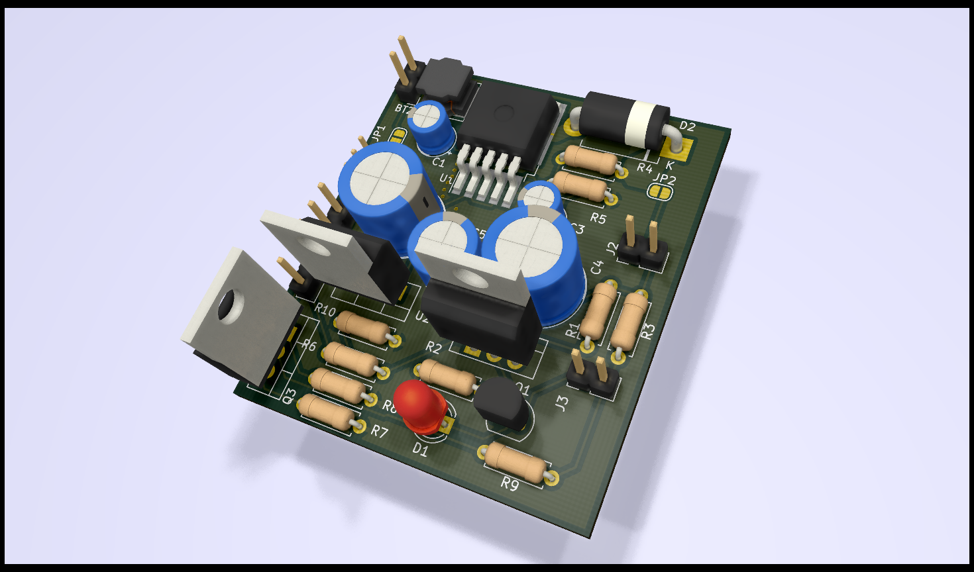
circuit/tDCS/3dview pcb.png
