angryseptagon/tDCSDisposable/circuit/tDCS/psb 3d view.png

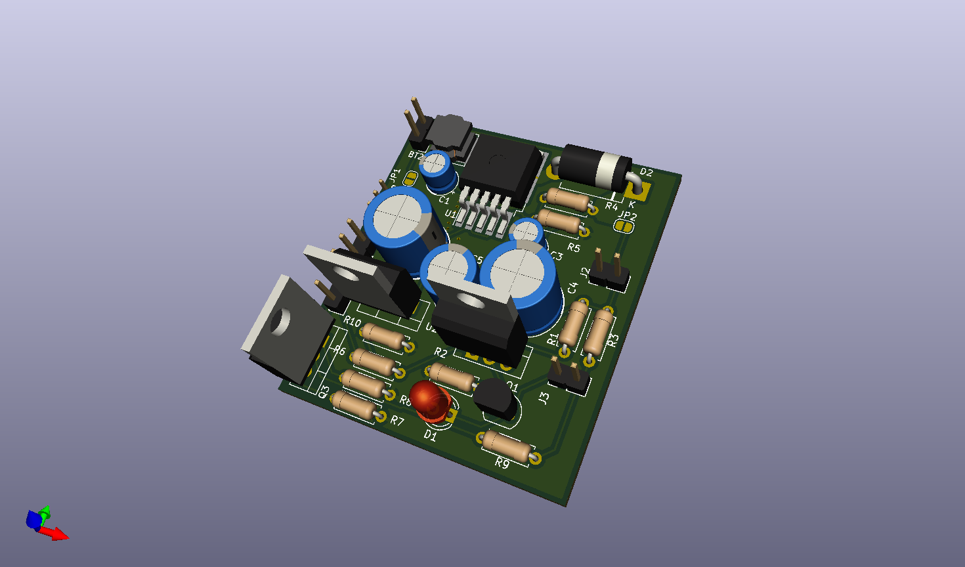
circuit/tDCS/psb 3d view.png
