angryseptagon/tDCSDisposable/photos and videos/Capturegtrg.PNG

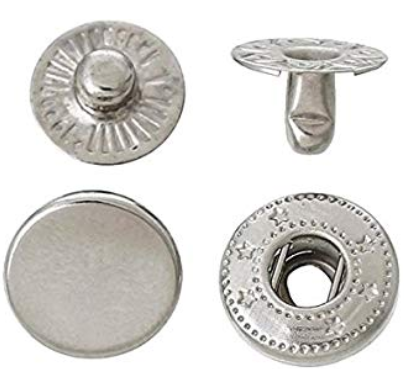
photos and videos/Capturegtrg.PNG
