angryseptagon/tDCSDisposable/photos and videos/filter.PNG

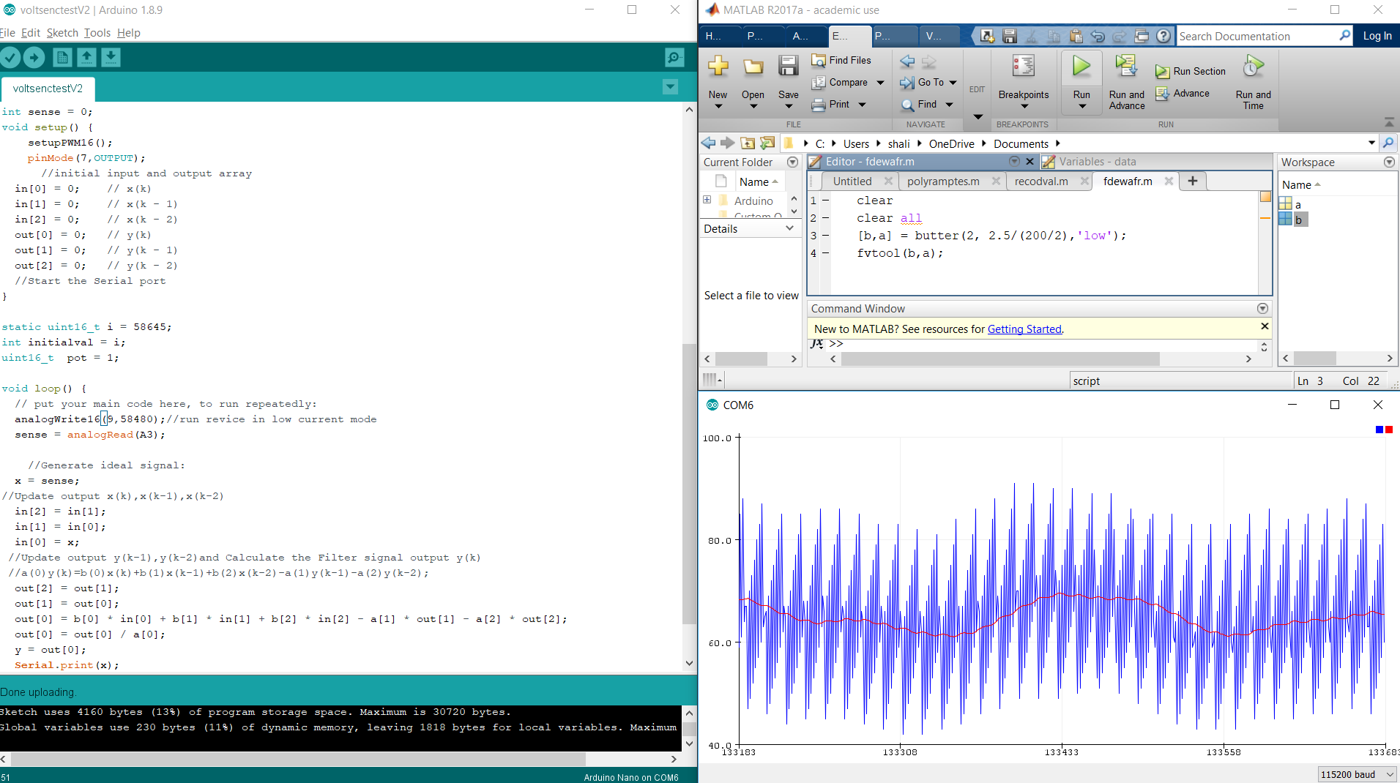
photos and videos/filter.PNG
