angryseptagon/tDCSDisposable/photos and videos/IMG_1399.PNG

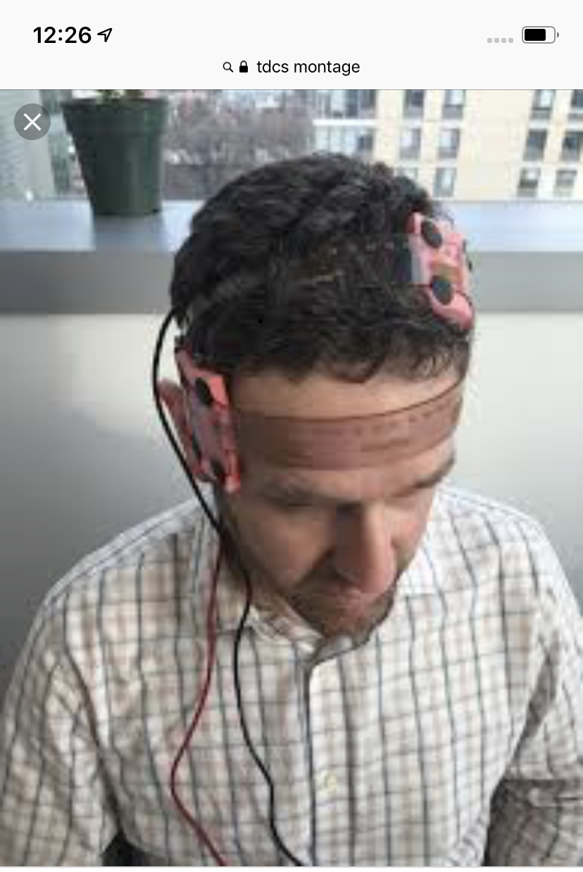
photos and videos/IMG_1399.PNG
