angryseptagon/tDCSDisposable/photos and videos/IMG_1401.PNG

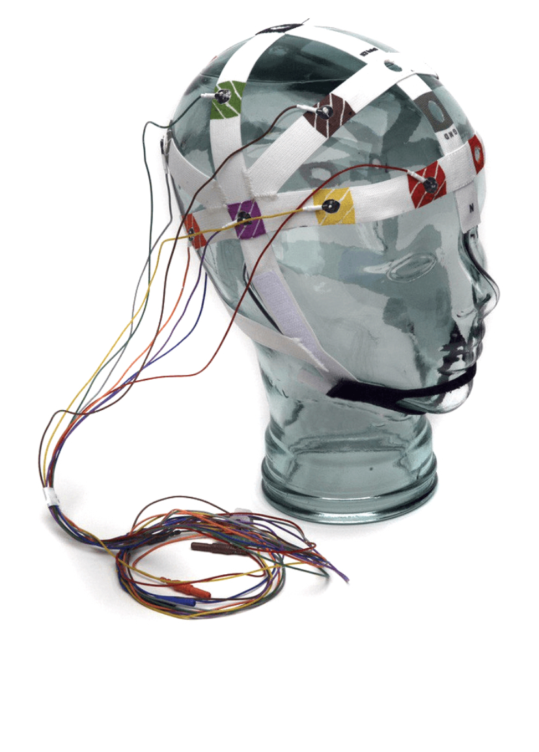
photos and videos/IMG_1401.PNG
