angryseptagon/tDCSDisposable/photos and videos/IMG_20190226_152819.jpg

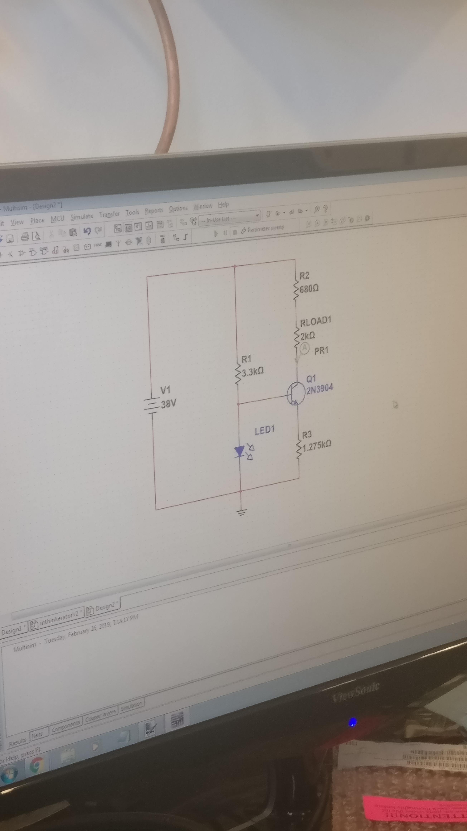
photos and videos/IMG_20190226_152819.jpg
