angryseptagon/tDCSDisposable/photos and videos/IMG_20190227_121801.jpg

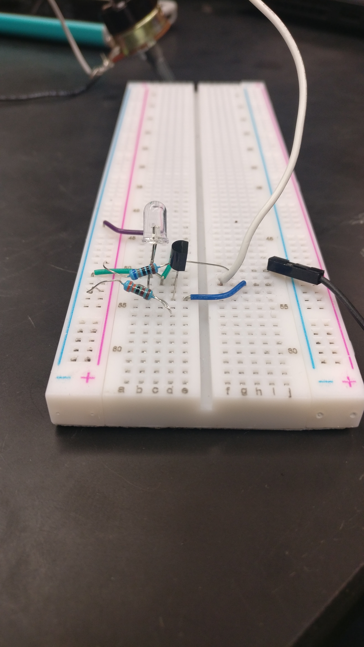
photos and videos/IMG_20190227_121801.jpg
