angryseptagon/tDCSDisposable/photos and videos/IMG_20190227_125121.jpg

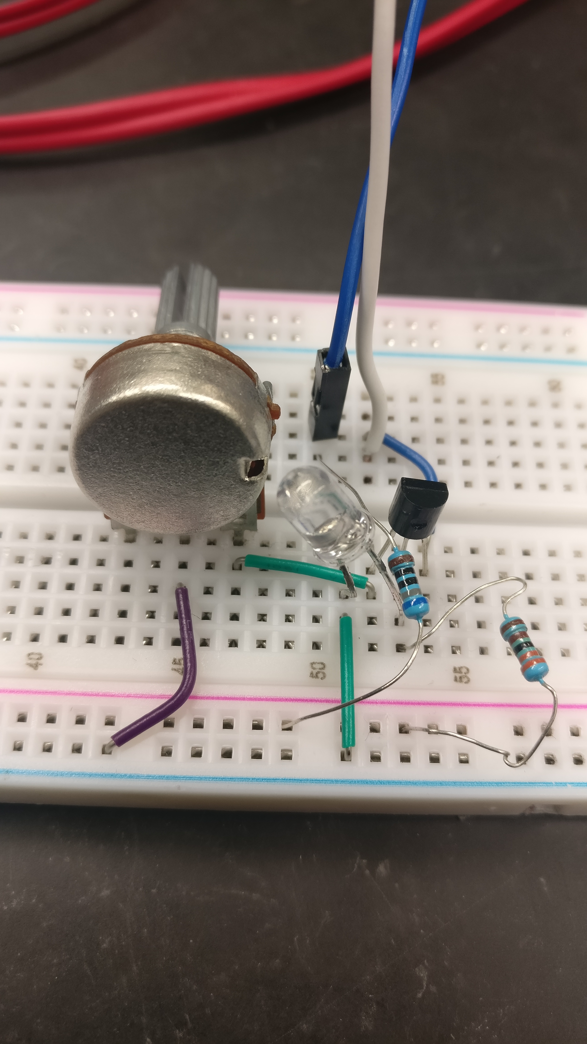
photos and videos/IMG_20190227_125121.jpg
