angryseptagon/tDCSDisposable/photos and videos/IMG_20190312_185120.jpg

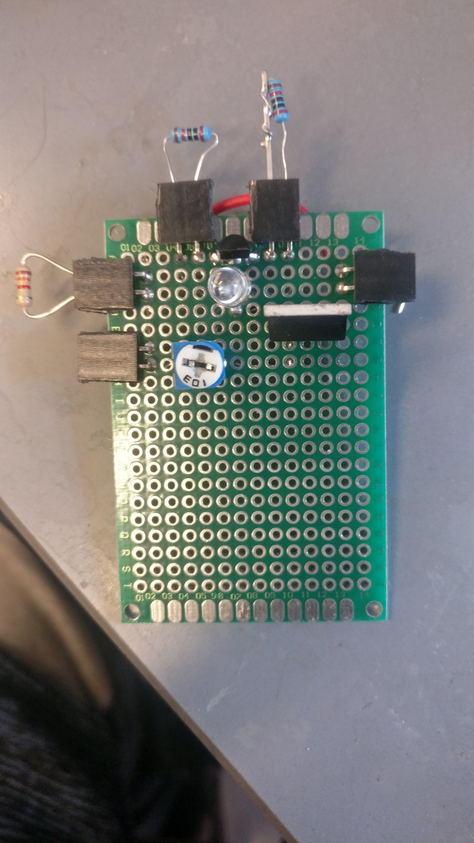
photos and videos/IMG_20190312_185120.jpg
