angryseptagon/tDCSDisposable/photos and videos/IMG_20190312_185205.jpg

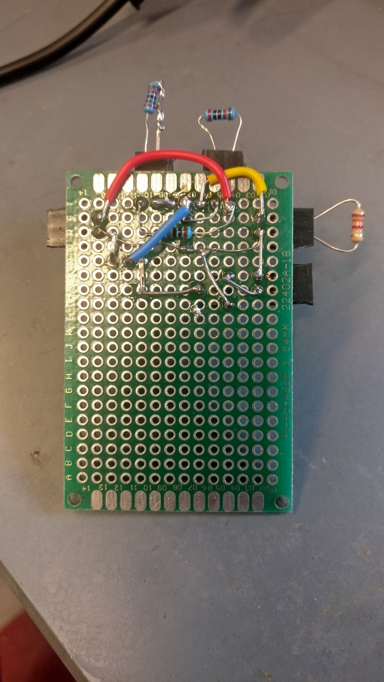
photos and videos/IMG_20190312_185205.jpg
