angryseptagon/tDCSDisposable/photos and videos/IMG_20190314_144105.jpg

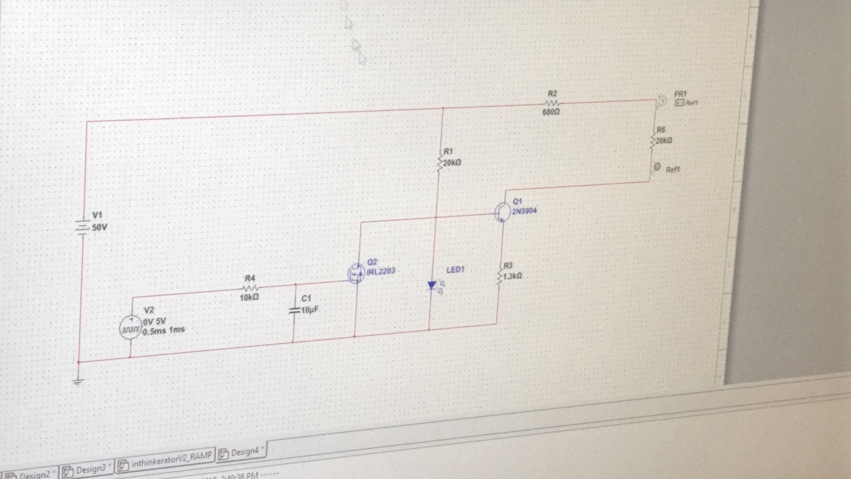
photos and videos/IMG_20190314_144105.jpg
