angryseptagon/tDCSDisposable/photos and videos/IMG_20190319_150241.jpg

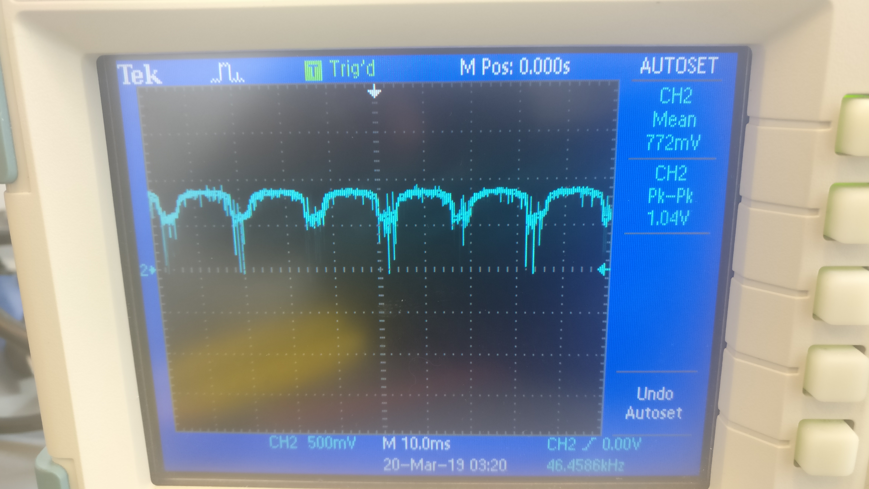
photos and videos/IMG_20190319_150241.jpg
