angryseptagon/tDCSDisposable/photos and videos/IMG_20190322_145458.jpg

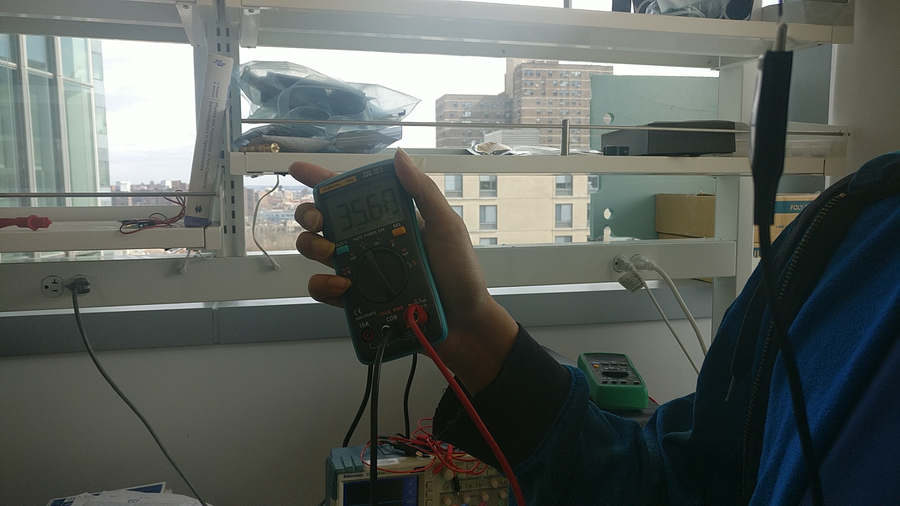
photos and videos/IMG_20190322_145458.jpg
