angryseptagon/tDCSDisposable/photos and videos/IMG_20190322_145521.jpg

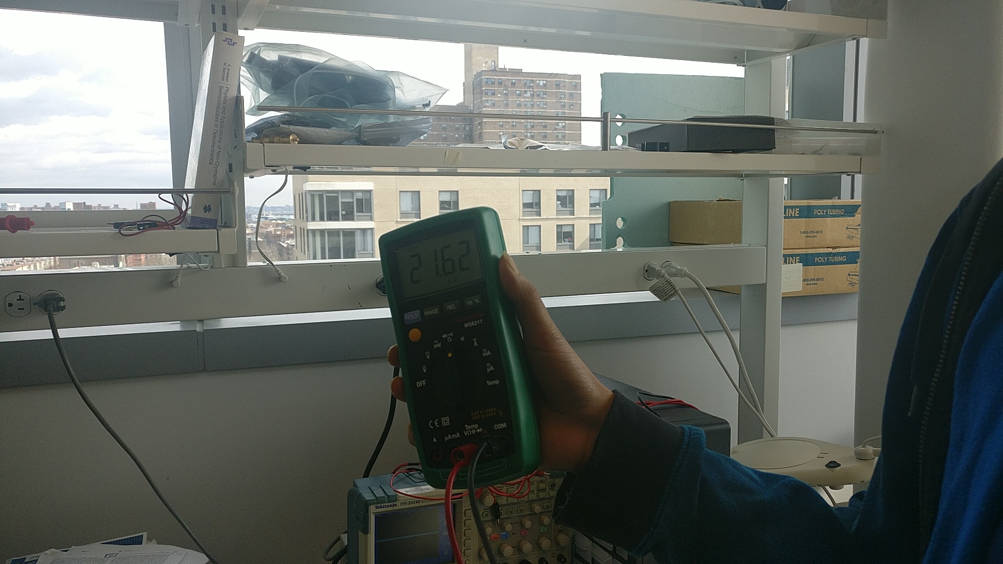
photos and videos/IMG_20190322_145521.jpg
