angryseptagon/tDCSDisposable/photos and videos/IMG_20190322_145543.jpg

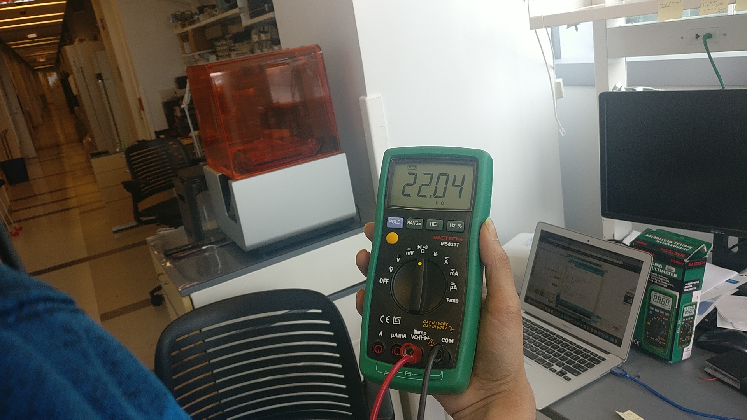
photos and videos/IMG_20190322_145543.jpg
