angryseptagon/tDCSDisposable/photos and videos/IMG_20190322_145549.jpg

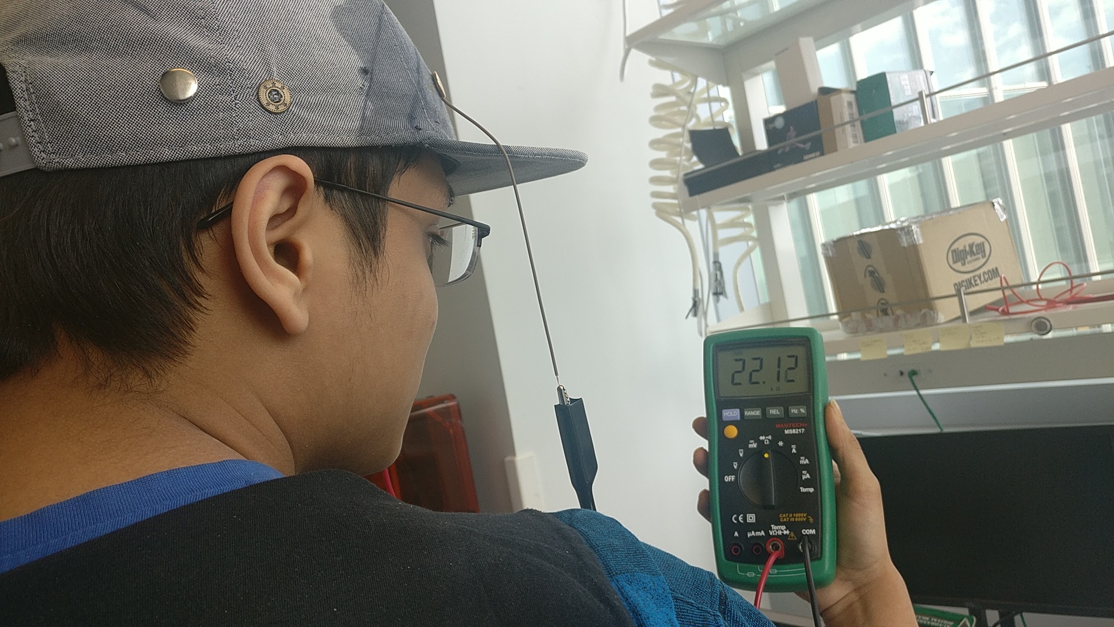
photos and videos/IMG_20190322_145549.jpg
