angryseptagon/tDCSDisposable/photos and videos/IMG_20190322_172600.jpg

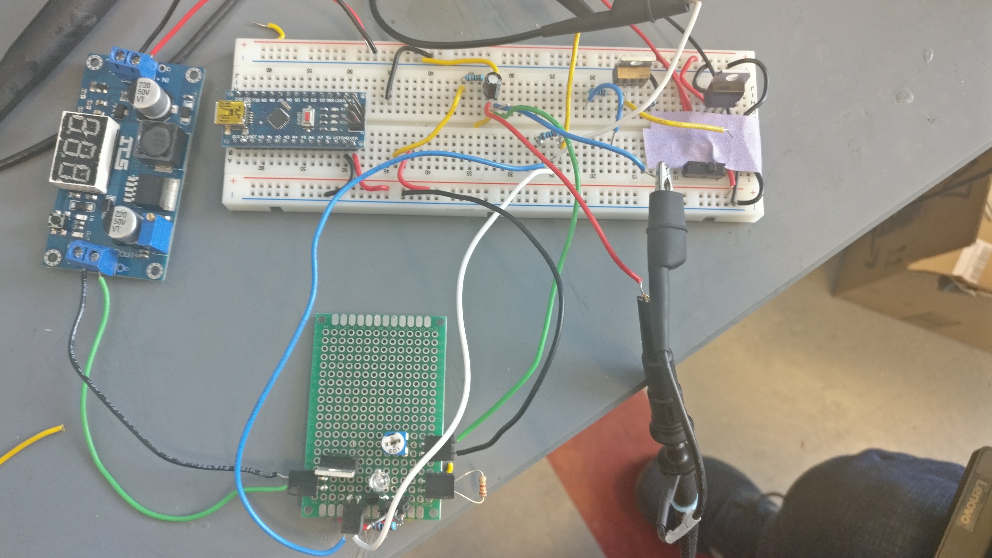
photos and videos/IMG_20190322_172600.jpg
