angryseptagon/tDCSDisposable/photos and videos/IMG_20190322_172616.jpg

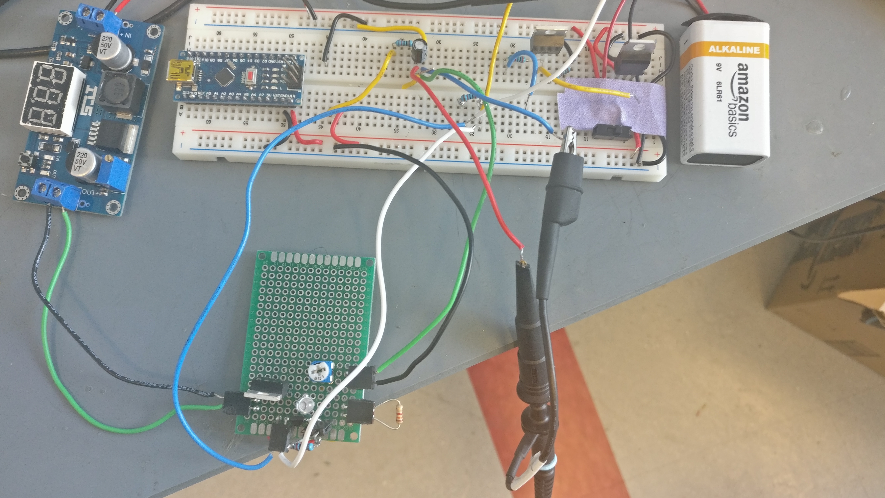
photos and videos/IMG_20190322_172616.jpg
