angryseptagon/tDCSDisposable/photos and videos/IMG_20190322_172703.jpg

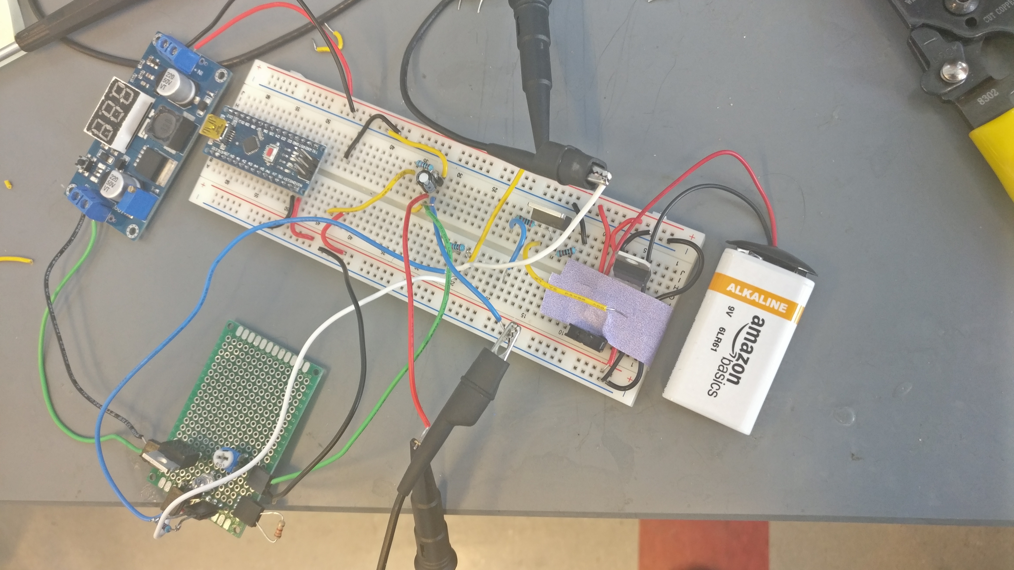
photos and videos/IMG_20190322_172703.jpg
