angryseptagon/tDCSDisposable/photos and videos/IMG_20190328_151122.jpg

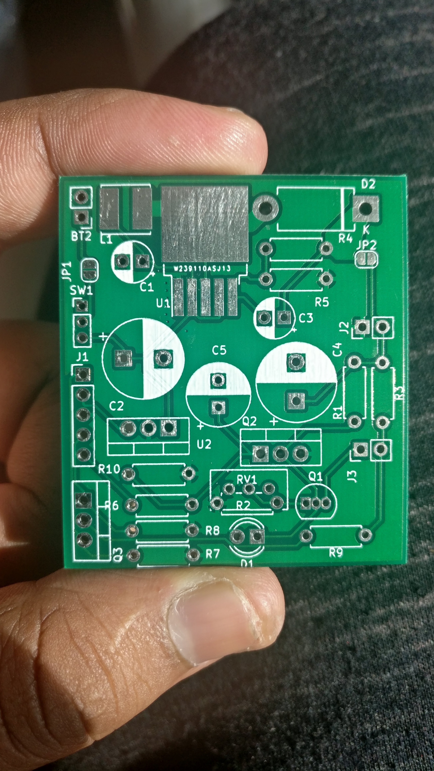
photos and videos/IMG_20190328_151122.jpg
