angryseptagon/tDCSDisposable/photos and videos/IMG_20190409_123413.jpg

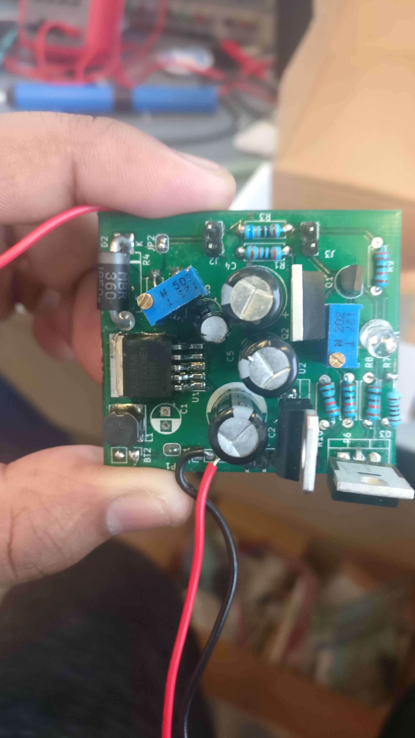
photos and videos/IMG_20190409_123413.jpg
