angryseptagon/tDCSDisposable/photos and videos/IMG_20190411_150810.jpg

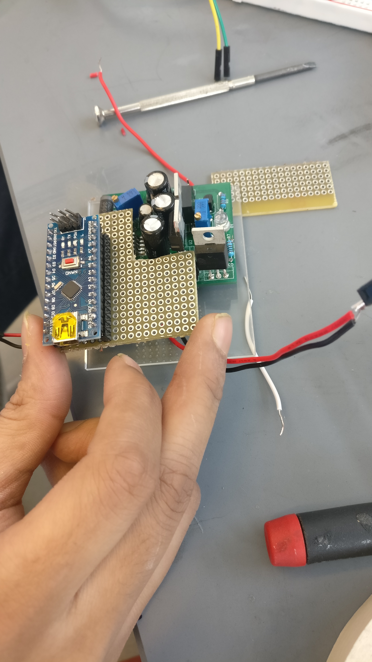
photos and videos/IMG_20190411_150810.jpg
