angryseptagon/tDCSDisposable/photos and videos/IMG_20190415_130028.jpg

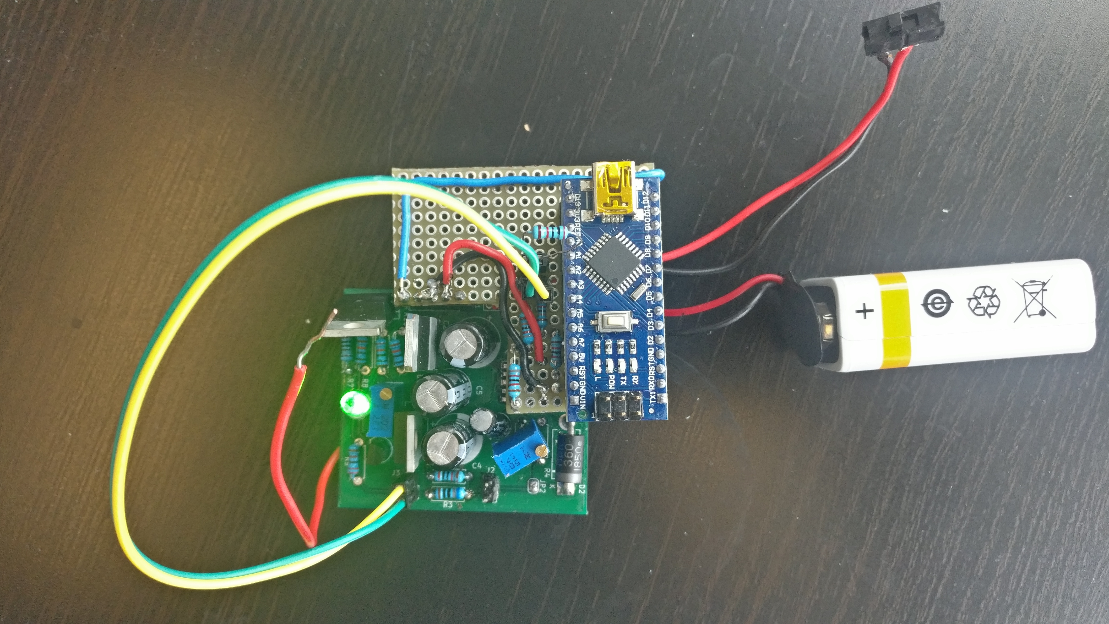
photos and videos/IMG_20190415_130028.jpg
