angryseptagon/tDCSDisposable/photos and videos/IMG_20190426_130251.jpg

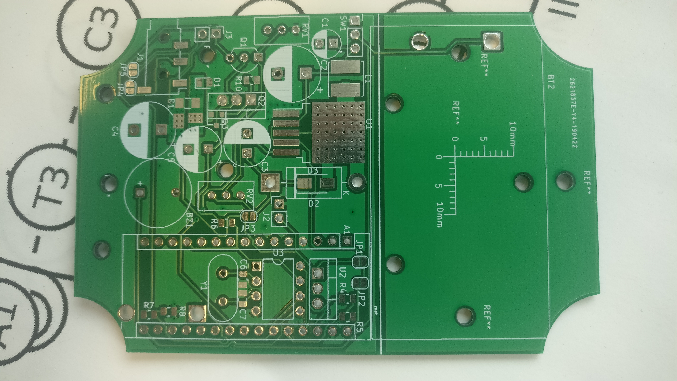
photos and videos/IMG_20190426_130251.jpg
