angryseptagon/tDCSDisposable/photos and videos/IMG_20190513_121520.jpg

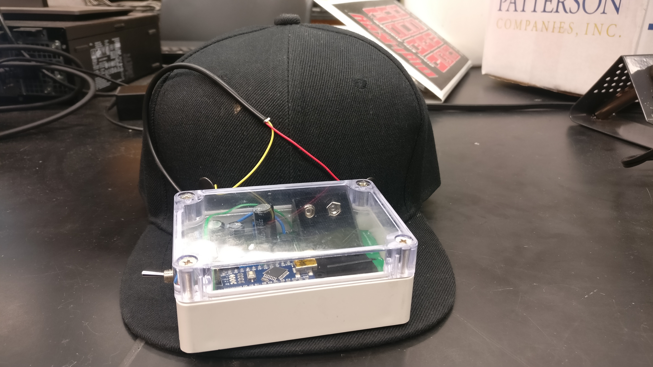
photos and videos/IMG_20190513_121520.jpg
