angryseptagon/tDCSDisposable/photos and videos/IMG_20190513_121543.jpg

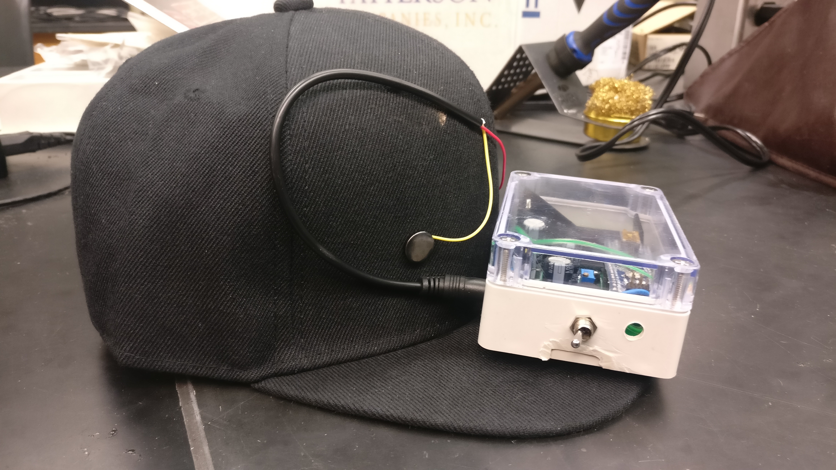
photos and videos/IMG_20190513_121543.jpg
