angryseptagon/tDCSDisposable/photos and videos/IMG_20190513_123138.jpg

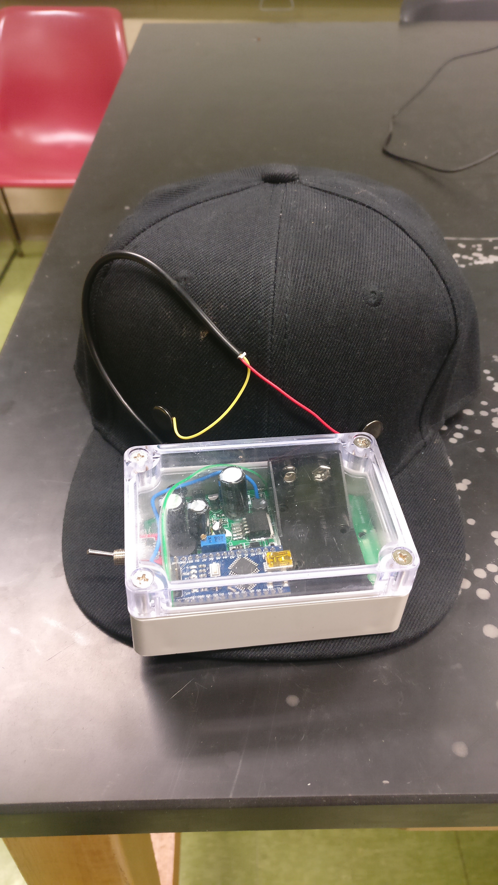
photos and videos/IMG_20190513_123138.jpg
