angryseptagon/tDCSDisposable/photos and videos/IMG_20190513_123155.jpg

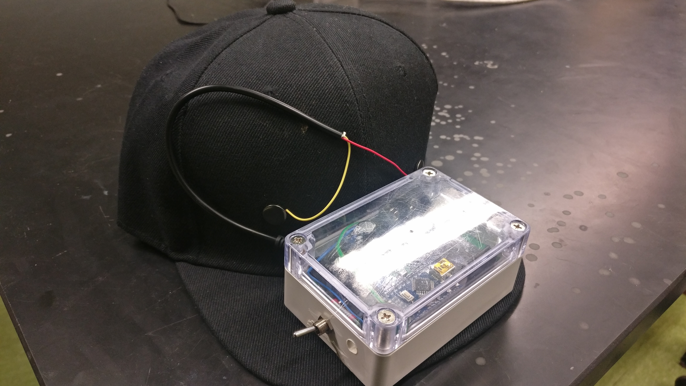
photos and videos/IMG_20190513_123155.jpg
