angryseptagon/tDCSDisposable/photos and videos/IMG_20190513_123206.jpg

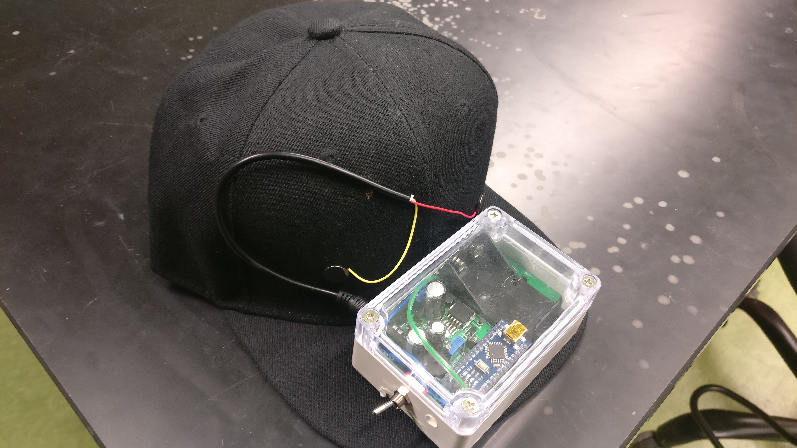
photos and videos/IMG_20190513_123206.jpg
