angryseptagon/tDCSDisposable/photos and videos/IMG_20190513_140823.jpg

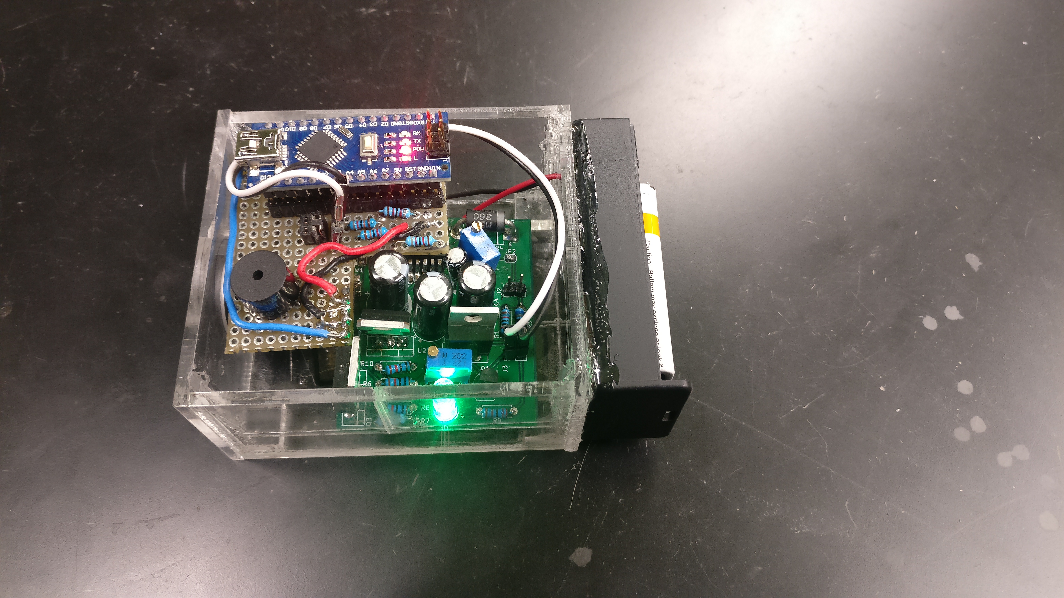
photos and videos/IMG_20190513_140823.jpg
