angryseptagon/tDCSDisposable/photos and videos/IMG_20190513_140845.jpg

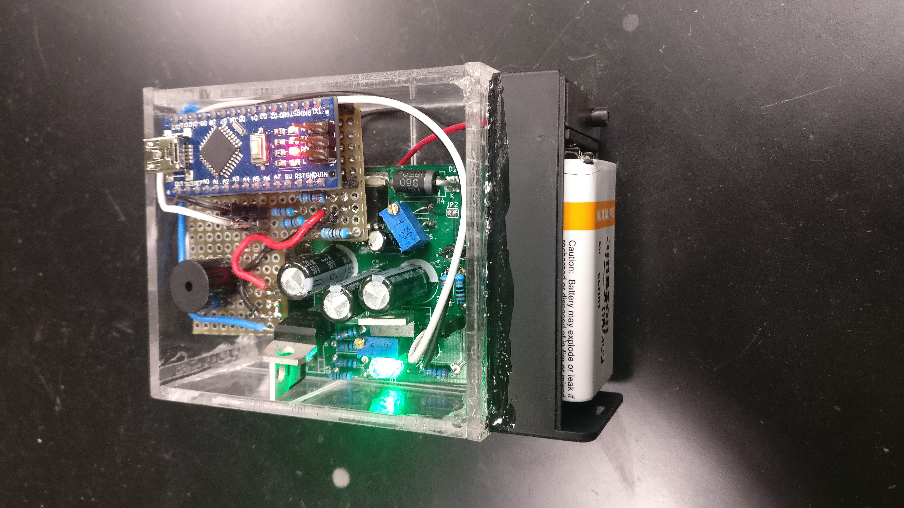
photos and videos/IMG_20190513_140845.jpg
