angryseptagon/tDCSDisposable/photos and videos/IMG_20190513_143550.jpg

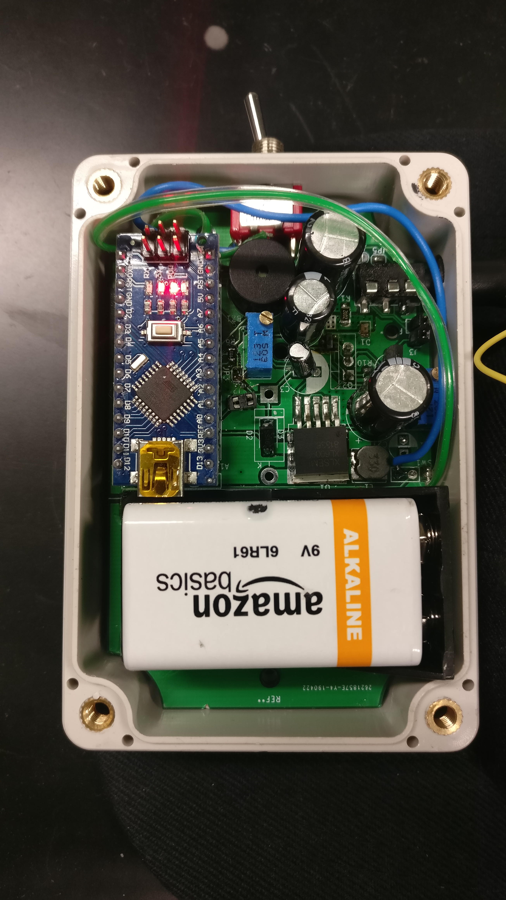
photos and videos/IMG_20190513_143550.jpg
