angryseptagon/tDCSDisposable/photos and videos/IMG_20190514_140738.jpg

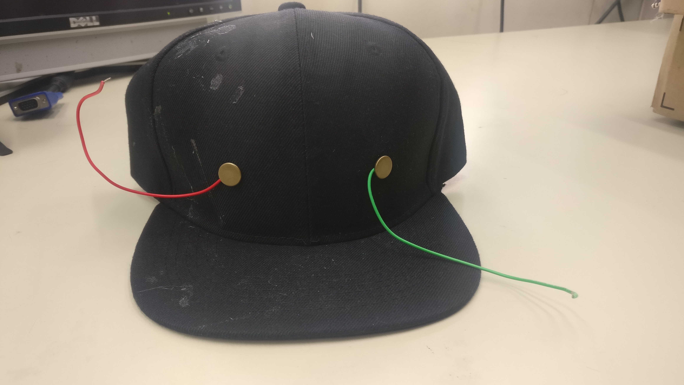
photos and videos/IMG_20190514_140738.jpg
