angryseptagon/tDCSDisposable/photos and videos/sponge.jpg

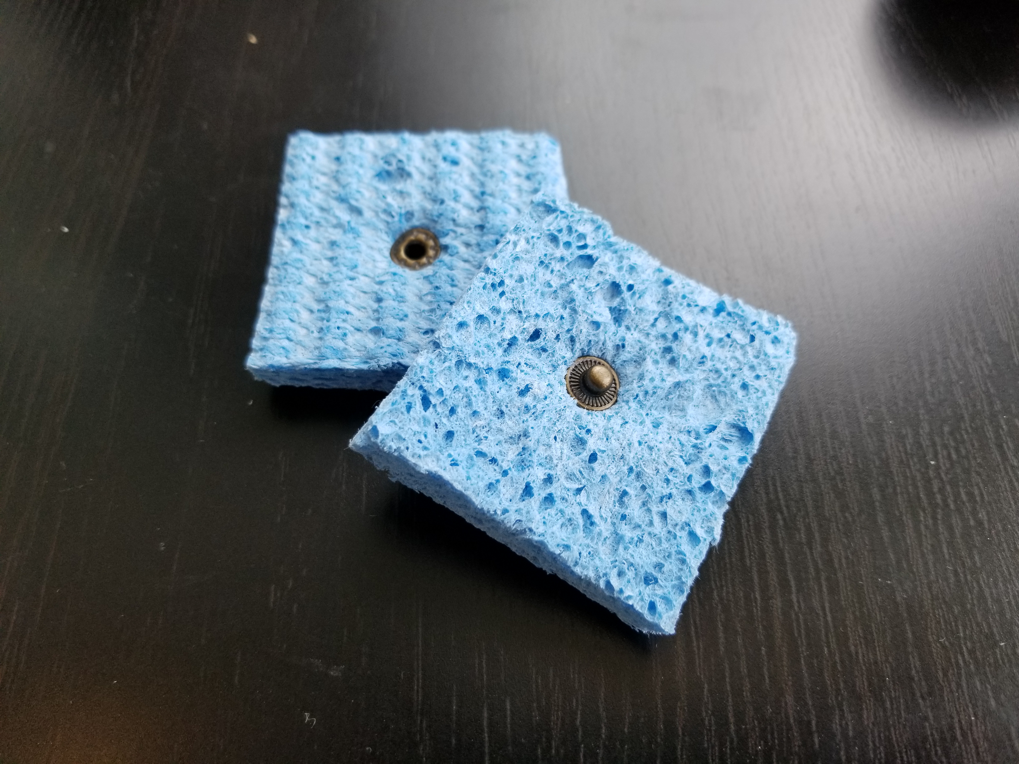
photos and videos/sponge.jpg
