angryseptagon/tDCSDisposable/circuit/unit final BOM.xlsx

Item | model # | low quantity unit price | bulk pricing per unit (10,000 units) | quantity | total
hat
battery
straps
resistors
220 uF caps
47uF caps
microcontroller
Mosfet
box
