angryseptagon/tDCSDisposable/Patent search.xlsx

Patent | name | why is it important | frequency | electrodes | circuit technology | current | voltage | Duration | disposability | treatment of | aditional notes | who found it
US4895169A | Disposable non-invasive stimulating electrode set | Has aspects of disposability | 60 Hz. and higher |  |  | DC |  |  | disposable |  |  | Shalih
US20150335877A1 | Cantilever electrodes for transdermal and transcranial stimulation | has an interesting headgear design | electrodes can handle above 640 hz, no circuit | electrodes are disposable | no circuit | can be anything |  | no circuit specified | pads are disposable |  |  | Radhanath
US20130204315A1 | Systems for and methods of transcranial direct current electrical stimulation | has useful designs for the electrode | run on DC current | there are pronged electrodes, and adhesive electrodes that attach to the shoulder | waist mounted constant current power supply | 2-3 mA over a 35cm2 electrode DC used to treat tinnitus |  | 5-30 minutes or more | one type of electrode is disposable (adhesive type on shoulder and a sponge pocket type that holds the conductor) |  |  | Radhanath
US20070060980A1 | Implantable pulse generator systems and methods for providing functional and/or therapeutic stimulation of muscles and/or nerves and/or central nervous system tissue | it is a pulsed stimulator that uses techniques to charge and produce stimulation useful for our device | pulsed stimulation is variable | implanted | RF charging technology | pulsed DC |  | variable | not disposable |  |  | Radhanath | name | count
US20160136424A1 | Transcranial pulsed current stimulation | it provides an example of a computer controlled pulsed current stimulator | 1000 Hz | none mentioned | computer controlled AC to DC converter |  | 0.1 volt to 1.5volt | unlimited | none pads and wiring could be disposable |  |  | Radhanath | Shalih | 12
US20110282129A1 | Neurostimulation Method to Induce Relaxation or Sleep | it is a headgear design that aims to treat problems in sleep | 1 and 150 Hz rectangular biphasic stimulation | one piece on forehead | not specified | 1 and 25 mA | not specified | indefinite | non disposable | used to improve sleep quality |  | Radhanath | Radhanath | 19
US20140336728A1 | Systems and methods that provide an electrical waveform for neural stimulation or nerve block | claims to be a self oscilating anolog circuit although it is biphasic, it looks to be a simple circuit that may be implemented | kilohertx order of magnitude | none mentioned | analog for the most part, it uses a transformer to step up voltage | biphasic | amplification level is set | set by source of control signal | none |  |  | Radhanath | Carim | 10
US20150105837A1 | Brain therapy system and method using noninvasive brain stimulation | it is a tACS system that can be used to modulated membrane potentials non-invasively | 0.1 to 640 Hz | none mentioned | uses a computer controlled stimuli generator unit | AC and DC | not specified | unlimited | none specified | mental and psychological disorders |  | Radhanath | Eric | 12
US20160074657A1 | Head-mounted wireless control transcranial electrical stimulation instrument | it is a head mounted circuit tDCS | it has multiple unspecified frequency settings | not specified | it uses a microcontroller board with a bluetooth module | unspecified in patent | can vary voltage depending on resistance | not specified | is not disposable | variable | chinapatent: CN204411500U | Radhanath | David | 9
US20110093033A1 | Eliciting analgesia by transcranial electrical stimulation | it provides another possible waveform for tDCS it combines an alternating current with an overall DC current flow | 1-100 Hz square wave | not specified | uses a controllable waveform generator | AC/DC 0.2 to 20 mA | not specified | about 35 minutes | not specified | pain relief by nerve stimulation |  | Radhanath |  | 0
US7783348B2 | Stimulation device for treating osteoarthritis | Therapeutic device for treating osteoarthritis | 1 Hz to about 100 Hz | not specified | pulsed electromagnetic field and electromagnetic stimulator | not specified | not specified | not specified | Not disposible | osteoarthritis | not specified | Carim | total | 62
US20130079659A1 | tDCS and eeg device | tDCS and EEG are in | unspecified | eeg electrode |  | DC | not specified | standard time | reusable electrode and material | variable | Reads both eeg and does tDCS stimulation. Montages are pre-set | Carim
CN105664357A | Multi Pramameter tDCS | allows three stimulatiobs types | 1k-2k Hz | not specified | AC, DC and Random Noise | 1-10mA | not specified | sandard time | not disposible | variable | does tDCS,tACS and tRNS | Carim
US9002458B2 | Transdermal electrical stimulation devices | light weight Transdermal electrical Stimulator | 400 Hz or greater | not specified | DC | 3mA | not specified | 10s and gretaer | NO | Cognitive effect | Thync device | Carim
US20130317580A1 | Vagal nerve stimulation to avert or treat stroke or transient ischemic attack | uses electrical impulses for stimulation | pulsed stimulation | not specified | Electrical impulse comprise of bursts 1-100 bursts/sec. Each burst 1-20 pulses | unspecified | 10-600 V/m (0.5-2cm below skin) | pulses are 100-1000 microseconds in duration but duration of treatment unspecified | not specified | stroke or transient ischemic attack |  | Eric
US8583238B1 | Wearable, unsupervised transcranial direct current stimulation (tDCS) device for movement disorder therapy, and method of using | tdcs while the user sleeps wearable cap | unspecified | low-cost and disposable | not specified | 2 mA | not specified | current active for 30 min a duty cycle. duty cycle predetermined | disposable cap and electrodes | movement disorder therapy | unsupervised tdcs | Eric
US5421817A | Non-intrusive analgesic neuroaugmentive and iontophoretic delivery apparatus and management system | converts output voltage into an adjustable constant current waveform | 10-100 kHz | not specified | creates complex waveforms | not specified | 27-40V | set by therapist | not disposable | iontophoretic delivery apparatus |  | Eric
US20140148872A1 | Wearable transdermal electrical stimulation devices and methods of using them | self contained device that has wireless capabilities | 650 Hz-10 kHz | transdermal | can create pulse or burst waveform | 2 mA | 9-12V | unspecified | semi disposable |  |  | Eric
US20080065182A1 | Portable assemblies, systems, and methods for providing functional or therapeutic neurostimulation | the way the stimulation is applied seems interesting |  | patch electrodes ( hydrogel compositions, adhesives) | pod houses microprocessor-based, programmable circuitry that generates stimulus currents | stimulation pulse |  |  | long term use | body/muscles |  | Shalih
US20150238762A1 | Methods for user control of neurostimulation to modify a cognitive state | prior art |  |  |  | up to 10mA (pulsed current) | not specified | 2-30 min | long term use | modify a cognitive state | Thync Global Inc | Shalih
US20090292328A1 | Medical Device | disposable medical device incorporating an electrode pad |  | flexible adhesive sheet electrode |  |  |  |  | disposable | transdermal neurostimulator |  | Shalih
US5578065A | Low-frequency therapeutic device having a flexible adhesive sheet electrode | user friendly |  |  | booster circuit having an inductor and a condenser | pulse output within 20 mA | not specified | 5 to 30 mins | not specified |  |  | Shalih
US20120029591A1 | Nerve Stimulator | Stimulates Targeted Nerves | 1000 Hz | unspecified | Pulse Stimulation | 0 to 40 mA, | 0 to 30 volts | 15-50 bursts per second | Not disposible | agus nerve stimulation | transcutaneous electrical nerve stimulationdevices | Carim
US20150088224A1 | Wearable transdermal electrical stimulation devices | wearable TES device | unspecified | unspecified | Alternating current | unspecified | unspecified | unspecified | Not disposible | Mental or cerebral conditions | Thync Global inc | Carim
US20150135840A1 | transcranial ultrasound neuromodulation | Requres no saline | less than 10 MHz | None | Ultrasound | unspecified | 300mV | unspecified | Not disposible | unspecified | No mantages | Carim
US20150151142A1 | Doppler ultrasound | Requres no saline | less than 10 MHz | None | Ultrasound | unspecified | 300mV | unspecified | Not disposible | unspecified | neuromodulation are targeted by using brain blood vessel landmarks identified by aTCD components. | Carim
US5273033A | Electrical stimulation for treatment of osteoarthritis | Patch electrode | 90 to 110 Hz | Conductive electrode | subsensory unidirectional voltage pulses | unspecified | unspecified | 20 minutes | Not disposible | osteoarthritis |  | Carim
US7376467B2 | Portable assemblies, systems and methods for providing functional or therapeutic neuromuscular stimulation | systems and method seems interesting | 0-200 μsec pulses at 20 Hz |  |  | stimulation pulse |  |  |  |  |  | Shalih
 |  |  |  |  |  |  |  |  |  |  |  | Carim
US20030191508A1 | Cosmetic use alternating current wave forms and cosmetic device | Alternating waveform | unspecified | electrical conductors | Alternating current square waves | 500 μA | 0.3-3.9V | 10-20 minutes | conductor disposable | cosmetic |  | Eric
US20130281759A1 | Transcranial stimulation device and method based on electrophysiological testing | Magnetic tDCS | 0.1Hz-100KHz | conductor with an electrode boot and a hole for conductive gel |  | unspecified | voltage isolator | unspecified | electrode boot dispoable | correct neural activity |  | Eric
US20090117513A1 | Concurrent treatment of oral maladies using direct current electricity | Direct constant current | not specified | ionic or colloidal liquid or gel | dual unit | 50-250 μA | 9V power source | unspecified | not disposable | oral maladies |  | Eric
US20150343196A1 | Dual-Purpose Sleep-Wearable Headgear for Monitoring and Stimulating the Brain of a Sleeping Person | it is a slim and simpe headgear design | paper mentions 40Hz is best for improving sleep | has skin contacting electrodes built into slim headband | no circuit | no current | no voltag | none specified | no, but design could potentially be modified | insomnia and poor sleep |  | Radhanath
US5514165A | Combined high voltage pulsed current and neuromuscular stimulation electrotherapy device | The circuit design could be useful for developing a pulsed current stimulator for the brain | 1-100 pulses | no electrodes mentioned | it uses an analog circuit, the current is controlled using transistors, the controller interfaces thgouhg op amps perhaps as isolation? | between 1 and 100 milliamps | 0-350V | none specified | not disposable | electrotherapy/ post operative pain |  | Radhanath
US7054686B2 | Pulsewidth electrical stimulation | it is important because it outlines a way to conduct pulsed brain stimulation | 1-1000 hertz | no electrodes mentioned | no circuit mentioned, onle general schematic | n/a | 3v | none specified | not disposable | heart arrythmia brain stimulation |  | Radhanath
US20150065838A1 | Electrode system for electrical stimulation | it provides a design for an electrodes that can directly contact the scalp instead of soaking though hair | n/a | spiked electrode | n/a | n/a | n/a | n/a | not disposable | elecrical contact on head |  | Radhanath
JP2005034268A | Method and apparatus for transcranial electrical stimulation | it provides a design to provide pulsed current to the brain | 1000-12000 | n/a | frequency is to be generated by crystal oscilator | none described in detail | not described | nonr specified in general design | not disposable | migraines and electrical anesthetic | there are problems in translation | Radhanath
US20100042180A1 | Electrical stimulation device and method for therapeutic treatment and pain management | It is a disposable stimulation device, although it is for pain management on muscles | 1-200 Hz | very unique snap on electrode design, but they are adhesive | only thing sepecified is that the circuitboard is printed on a flexible substrate | milliamp order of magnitude | unspecified | not specified | fully disposable | Transcutaneus muscle stimulation for therapy and pain management | check if this has ever been produced | Radhanath
US20180296836A1 | Topical Neurological Stimulation | The platform for this device could potentially be made cheaper since it uses and RF power sourse | 15-50 Hz | adhesive bandage type electrode | uses an RF coil as a powersource with circuitry built into the pad | 20-100mA (pulsed) | n/a | n/a | feasable according to manufacturer | it is topical (TNSS), it is used for muscle stimulation and the patent gives penile stimulation as a potential use |  | Radhanath
US7801605B2 | Disposable defibrillator electrode assembly | the design of assembling the device and electrodes. electrodes and batteries are disposable | n/a | defibrillator electrode (adhesive) | schematic of the circuit on fig 4A. no special tech. | n/a | n/a | n/a | disposable | cardiac dysrhythmias |  | David
US7894907B2 | Systems and methods for implantable leadless nerve stimulation | it provides pulse stimulation. generates electrical current from vibrational energy | 20 kHz - 10 MHz | not specified | transducer comprises ultrasound to reveive acoustic energy and transform it to electrical energy | not described | not described | not described | not disposable | pain, and other conditions, such as, CHF, obesity, incontinence, etc |  | David
US20120302821A1 | Method and apparatus for electromagnetic stimulation of nerve, muscle, and body tissues | it uses microneedle electrode for the current stimulation. works on the hairline as well. https://www.semanticscholar.org/paper/Electroencephalogram-measurement-from-the-hairy-of-Arai-Kudo/97dcc896a4119722315a8b4f99b5564d8f8e70da | 10-30 Hz. square wave via fourier transform or ramped current | electroneedle electrodes | not described | not described | microneedles may arrange abt 1 - 400 microvolts or 10 to 300. | depends on treatment | not disposable | nerve, muscle and body tissues |  | David
US8588884B2 | Microneedle electrode | enhancing conductivity of an electrical signal thru microneedle electrode | not described | electroneedle electrodes | not described | not described | not described | not described | not disposable | electric stimulation |  | David
US20090264792A1 | Method and Apparatus to Measure Bioelectric Impedance of Patient Tissue | it measures the bioelectric impedance of the patient | 1 kHz | not specified | circuit calibrates the signal correspond to the current delivered thru the tissue | 10-1000 μA | not specified | not specified | not disposable | measuring impedance |  | David
US20080167697A1 | Portable Unit for Treating Chronic Pain | uses interferential treatment and transcutaneous electrical nerve stimulator | first pulse generator (3.900 and 5,250 Hz per channel) & first pulse generator (0.5 and 300 Hz) | patch electrodes | picture of it is showen | pulse generators | 9 V | 20 to 40 minutes | not disposable | Chronic Pain |  | Shalih
US6023642A | Compact transcutaneous electrical nerve stimulator | Compact stimulator | 52 gigahertz to 78 gigahertz |  |  |  | 150 V for load of 1,000 ohms |  |  |  |  | Shalih
US4524087A | Conductive adhesive and biomedical electrode | a type of adhesive eletrode | not described | biomedical electrode | not described |  | not described | not described |  |  |  | Shalih
US20180264263A1 | Devices and methods for controlling tremor | partially disposable stimulators are a possible approach for our device, so this can be useful | 10-5000Hz (50-150) | adhesive electrodes, they are placed on skin | not specified | 0.1 to 10 mA | not specified | 40 minutes | partially disposable | muscle pain and to treat muscle treamors |  | Radhanath
US20180272118A1 | Transdermal electrical stimulation at the neck | it is partially disposable and it addresses electrode placement in a location not previously considered | 10-1 kHz | neck adhesive electrodes that are built in with the circuitry |  | 1-40 mA | 20 volts | up to 40 minutes | partially disposable | can be used for psoriasis and to induce a relaxed cognitive state |  | Radhanath
US8086318B2 | Portable assemblies, systems, and methods for providing functional or therapeutic neurostimulation | it is a portable easy to use device, it is not transcutaneus, or cheap but the formfacotr is novel | 10-150 Hz | needle | uses microcontroller to modulate voltage from HV supply (mosfet + op amp) | 0.5-20 mA | not specified (uses amplifier) | not specified | partially disposable | neurostimulation ie. pain relief |  | Radhanath
US20050085751A1 | Disposable electric bandage | fully disposable circuitry | 1-1000Hz | adhesive electrodes | electrode coupled to the two terminals of the battery | 0.002-10 mA/cm2 | 0.5-20V | unspecified | fully disposable | wound healing |  | Eric
US20100076533A1 | System for transmitting electrical current to a bodily tissue | fully disposable | 1 kHz | adhesive | electrode coupled to the two terminals of the battery | 0.3-9 mA | not specified | 20 minutes | fully disposable | basic electrical stimulation |  | Eric
US20130085551A1 | Devices, systems and methods for treating pain with electrical stimulation | partially disposable self application | 3500-4500 Hz | rollerball electrode | controller with a signal generator | not specified | 3.7-4.2 V | adjustable | partially disposable | pain treatment |  | Eric
US20160121118A1 | Stimulation devices and methods for treating dry eye | small portable device that is handheld and ready to use | 30-80 Hz | nasal insertion prong | not specified | 0.1-10 mA | 10 mV-100 V | 15 minutes | could be fully disposable | dry eyes |  | Eric
US8239030B1 | Transcranial stimulation device and method based on electrophysiological testing | has a unique montage and combination electroencephalography and non-invasive stimulation devices | not described | patch electrodes | not specified | 0.25 - 6 mA |  |  | electrode and foam conductive patch |  |  | Shalih
US20130079659A1 | NTEGRATION OF ELECTROENCEPHALOGRAPHY (EEG) AND TRANSCRANIAL DIRECT CURRENT STIMULATION (tDCS) WITH HIGH-SPEED OPERATION | has a unique montage and EEG and tDCS functionalities are integrated into a single headset |  | hd electrode |  | 1-2.5 mA |  | 15 minutes | disposable electrodes | unspecified |  | Shalih
US20160367804A1 | Transcranial burst electrostimulation apparatus and its applications | combins transcranial direct current stimulation (tDCS) and theta burst stimulation (TBS) | greater than 640 Hz |  |  | ~5 mA |  | 30 minutes | disposable electrodes | brain or neural diseases |  | Shalih
EP0327304A1 | Disposable stimulation electrode with long shelf life and improved current density profile |  | N/A | A flexible disposable stimulation electrode with low current density and long shelf life | indent in the electrode to contain the gel | N/A | N/A | N/A | fully disposable | N/A |  | Eric
WO2014195516A1 | Transcranial pulsed current stimulation | provides info abt noninvasive electrical pulsed brain stimulation | 0.1-1000 Hz | patch electrodes | computer implemented method of providing cranial stimulation | less than 1mA to 5mA | N/A | 10-30 minutes | not disposable | depression, anxiety |  | David
US20120109251A1 | Transcranial electrostimulation device | provides freq, current and duration example | 72-85 Hz | patch electrodes | general electric stimulation | exceeds 0.2 mA | N/A | at least 15 min | not disposable | physiological condition treatment |  | David
US20100198282A1 | Devices for vestibular or cranial nerve stimulation | thermoelectric device. thermally stimulating nerve tissue | N/A | N/A | vestibular stimulation and thermally stimulating device | N/A | N/A | 1-10 min | ear insert is disposable | dizziness, elusive sleep, headaches, parkinson's, etc |  | David
US20110230701A1 | Electrical and magnetic stimulators used to treat migraine/sinus headache and comorbid disorders |  | 20-30 Hz | flexible flat disposable | electrical and magnetic stimulator | 1 - 2 mA. gradually inc from 0.25mA to max 3 mA. typical therapetic setting: 1-1.5 mA | N/A | on/off every 5 min (30 secs for sig ON time) | electrodes | headache and comorbid |  | David
