angryseptagon/tDCSDisposable/CAD/tdcsbox.SLDPRT

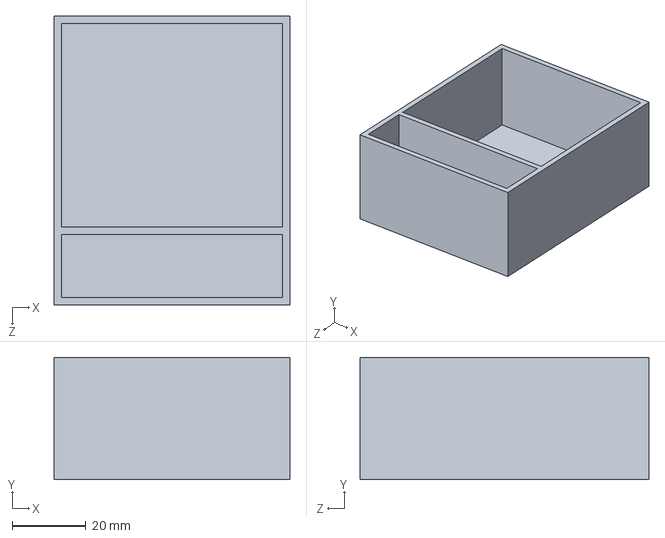
[picture p95: CAD file, 2021-02-18]
CAD/tdcsbox.SLDPRT
63.8 x 33.0 x 78.0 mm
