angryseptagon/tDCSDisposable/PCB files/tDCS_newcircuit/gerberV4/_saved__saved_tDCS-F.Cu.dxf

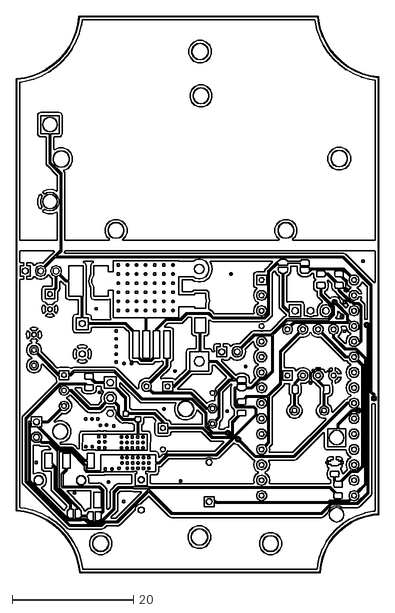
[picture p98: CAD file, 2021-02-18]
PCB files/tDCS_newcircuit/gerberV4/_saved__saved_tDCS-F.Cu.dxf
59.8 x 91.8
