angryseptagon/tDCSDisposable/CAD/Hat-GrabCad.SLDPRT

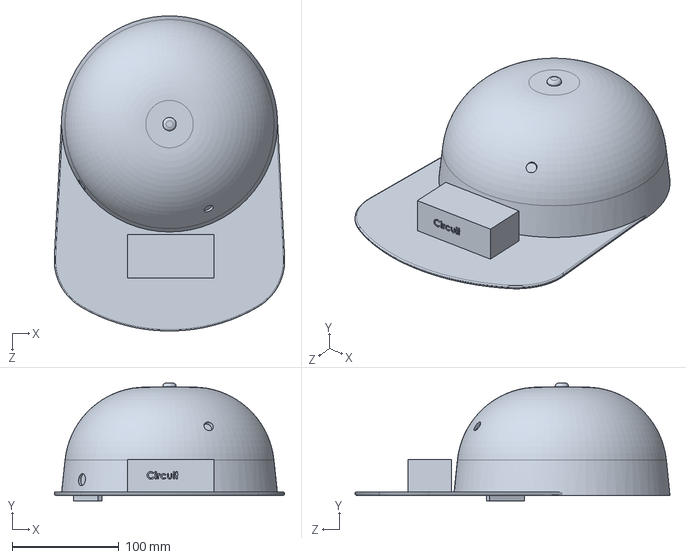
[picture p99: CAD file, 2021-02-18]
CAD/Hat-GrabCad.SLDPRT
216.4 x 110.7 x 295.7 mm
