angryseptagon/tDCSDisposable/(list of files, cad)

Other CAD files:
PCB files/tDCS_newcircuit/_saved__saved_tDCS-Edge.Cuts.dxf
PCB files/tDCS_newcircuit/gerberV4/_saved__saved_tDCS-NPTH.dxf
PCB files/tDCS_newcircuit/gerberV2/_saved__saved_tDCS-F.SilkS.dxf
PCB files/tDCS_newcircuit/gerberV4/_saved__saved_tDCS-B.SilkS.dxf
PCB files/tDCS_newcircuit/gerberV4/_saved__saved_tDCS-F.SilkS.dxf
