angryseptagon/tDCSDisposable/Senior Design - tDCS/testing protocol/Print Now.docx

Instruction

HAT DESIGN

1. Snap the electrodes onto the hat
2. Place them in such a way that it aligns with the electrode outline
3. Use the adjustment snap to adjust the hat to your head size
4. Place the hat on the head
5. Make sure the brim is facing forward
6. Make sure sponge is touching your forehead and you can feel moisture

I thought the system was easy to use.

Strongly Disagree Neutral Strongly Agree

1 2 3 4 5

I think that I would need the support of a technical person to be able to use this system.

Strongly Disagree Neutral Strongly Agree

1 2 3 4 5

I would imagine that most people would learn to use this system very quickly.

Strongly Disagree Neutral Strongly Agree

1 2 3 4 5

I needed to learn a lot of things before I could get going with this system.

Strongly Disagree Neutral Strongly Agree

1 2 3 4 5
