angryseptagon/tDCSDisposable/Senior Design - tDCS/testing protocol/System Usability Scale (SUS).docx

System Usability Scale Test (SUS)

Instruction on how to wear the headgear

1. Unpack two sponge electrode which is pre-soaked with the saline.

2. Snap both of the sponge electrode to the inner side of the headgear.

3. Adjust the sponges to fit on the outline on the inner side of the headgear.

4. Put on the headgear on your head and tightly adjust the rear snaps and the straps on the sides.

1. I thought the system was easy to use.

Strongly Disagree Neutral Strongly Agree

1 2 3 4 5

2. I think that I would need the support of a technical person to be able to use this system.

Strongly Disagree Neutral Strongly Agree

1 2 3 4 5

3. I would imagine that most people would learn to use this system very quickly.

Strongly Disagree Neutral Strongly Agree

1 2 3 4 5

4. I needed to learn a lot of things before I could get going with this system.

Strongly Disagree Neutral Strongly Agree

1 2 3 4 5
