angryseptagon/tDCSDisposable/Senior Design - tDCS/testing protocol/Testing procedure for benchtop testing.docx

Testing procedure for benchtop testing

1. Set up circuit powered by battery
2. Turn potentiometer to marked position
3. Record resistances of potentiometers
4. Attach resistor to one terminal
5. Put multimeter in series with resistive load.
6. Measure current
7. Put multimeter in parallel with resistive load
8. Measure voltage
