angryseptagon/tDCSDisposable/Coding related /python script and txt file/tDCS_calibration_data.txt

M\xff44.80,7.36,6.46
44.64,33.81,6.08
44.47,78.02,5.42
45.41,129.36,4.27
44.73,180.51,5.09
45.94,228.05,4.32
45.15,270.12,4.65
45.05,305.43,5.25
45.31,333.84,4.71
44.79,355.87,5.47
44.84,372.08,5.15
44.94,382.25,4.82
44.32,386.84,5.58
44.06,388.17,5.86
45.21,387.39,4.82
45.42,384.76,4.93
45.16,381.79,5.58
45.63,378.95,4.32
45.37,376.01,5.09
45.37,373.78,4.65
45.10,372.47,4.49
45.10,371.59,4.60
44.68,370.98,5.15
44.58,370.35,5.36
45.47,369.78,4.82
45.10,369.20,4.71
44.58,368.30,5.58
44.63,367.69,5.25
44.84,367.17,4.65
43.83,365.61,4.93
45.04,363.66,4.38
45.41,362.20,4.05
44.42,361.06,5.25
44.52,360.39,5.15
45.31,360.55,4.38
45.16,361.59,4.93
44.79,362.59,5.09
45.73,362.85,4.54
44.90,363.32,5.25
44.99,363.89,4.49
44.58,363.71,5.36
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
