angryseptagon/tDCSDisposable/Coding related /python script and txt file/tDCS_calibration_data_tabsep.txt

-0.01	8.00	53001
0.05	36.51	53002
-0.00	83.92	53003
0.05	139.66	53004
0.05	196.24	53005
0.05	248.77	53006
0.05	294.49	53007
0.05	332.19	53008
-0.01	361.74	53009
0.05	383.70	53010
0.05	398.99	53011
-0.00	408.75	53012
0.05	414.22	53013
-0.01	416.49	53014
0.05	416.55	53015
0.05	415.15	53016
0.05	412.92	53017
0.05	410.35	53018
0.05	407.79	53019
0.05	405.44	53020
0.05	403.39	53021
0.05	401.69	53022
-0.00	400.36	53023
0.05	399.40	53024
0.05	398.75	53025
0.05	398.35	53026
0.05	398.15	53027
0.05	398.09	53028
-0.01	398.12	53029
0.05	398.22	53030
0.05	398.34	53031
-0.00	398.47	53032
0.05	398.60	53033
-0.01	398.69	53034
0.05	398.74	53035
0.05	398.77	53036
0.05	398.80	53037
0.05	398.84	53038
-0.01	398.86	53039
0.05	398.84	53040
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
