angryseptagon/tDCSDisposable/Coding related /python script and txt file/tDCS_calibration_data_tabsep_1.txt

voltage_output,sense,step#, vbatt = 8.36
16	7.66	53001
45.17	35.55	53002
45.12	83.09	53003
45.16	139.38	53004
45.17	196.13	53005
45.06	249.27	53006
45.12	296.39	53007
45.01	335.84	53008
45.11	366.53	53009
45.17	388.53	53010
45.11	403.84	53011
45.22	414.26	53012
45.17	420.68	53013
45.22	424.02	53014
45.27	425.11	53015
44.96	424.68	53016
45.06	422.66	53017
45.22	419.14	53018
45.22	415.59	53019
45.12	412.94	53020
45.12	411.08	53021
45.17	409.24	53022
45.22	406.90	53023
45.17	405.02	53024
45.11	403.59	53025
45.17	401.97	53026
45.17	400.99	53027
45.17	401.10	53028
45.17	401.89	53029
45.11	402.41	53030
45.17	402.04	53031
45.17	401.74	53032
45.22	402.14	53033
45.28	402.94	53034
45.12	403.96	53035
45.17	405.06	53036
45.01	406.11	53037
45.12	406.38	53038
45.01	405.53	53039
45.38	404.63	53040
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
