angryseptagon/tDCSDisposable/Coding related /python script and txt file/tDCS_calibration_data_tabsep_10.txt

voltage_output,sense,step#,r = 47k
50.74	7.32	53001
50.68	33.45	53002
50.95	77.03	53003
50.79	128.28	53004
50.79	180.20	53005
50.89	228.46	53006
50.74	270.59	53007
50.79	305.41	53008
50.84	332.65	53009
50.74	352.77	53010
50.74	366.77	53011
50.74	375.81	53012
50.74	380.94	53013
50.79	383.13	53014
50.74	383.26	53015
50.74	382.10	53016
50.84	380.12	53017
50.74	377.67	53018
50.79	375.20	53019
50.84	372.98	53020
50.79	371.08	53021
50.89	369.44	53022
50.68	368.06	53023
50.79	367.05	53024
50.79	366.36	53025
50.73	365.84	53026
50.74	365.55	53027
50.73	365.47	53028
50.79	365.55	53029
50.74	365.63	53030
50.74	365.66	53031
50.79	365.76	53032
50.79	365.91	53033
50.74	365.97	53034
50.68	366.07	53035
50.74	366.27	53036
50.95	366.48	53037
50.74	366.57	53038
50.79	366.53	53039
50.74	366.51	53040
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
