angryseptagon/tDCSDisposable/Coding related /python script and txt file/tDCS_calibration_data_tabsep_11.txt

voltage_output,sense,step#,r = 47
50.74	7.22	53001
51.00	33.39	53002
50.89	77.73	53003
50.84	130.09	53004
50.84	182.92	53005
50.89	232.19	53006
50.74	275.61	53007
51.05	311.80	53008
50.79	340.01	53009
50.95	360.45	53010
50.89	374.64	53011
51.05	383.98	53012
50.95	389.46	53013
50.89	392.01	53014
50.74	392.50	53015
50.89	391.64	53016
50.79	389.64	53017
51.00	386.69	53018
50.95	383.74	53019
50.79	381.35	53020
50.89	379.44	53021
50.89	377.64	53022
50.79	375.69	53023
50.89	374.13	53024
50.84	372.93	53025
50.95	371.74	53026
51.00	371.03	53027
50.84	370.98	53028
50.95	371.36	53029
50.84	371.49	53030
50.89	371.02	53031
50.68	370.73	53032
50.79	371.07	53033
50.95	371.78	53034
50.89	372.70	53035
50.79	373.68	53036
50.79	374.61	53037
50.74	375.06	53038
50.79	374.78	53039
50.95	374.42	53040
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
