angryseptagon/tDCSDisposable/Coding related /python script and txt file/tDCS_calibration_data_tabsep_2.txt

voltage_output,sense,step#,vbatt = 7.64
45.45	7.84	53001
45.45	35.79	53002
45.45	82.32	53003
45.50	137.02	53004
45.56	192.53	53005
45.45	244.11	53006
45.45	289.04	53007
45.40	326.10	53008
45.50	355.08	53009
45.40	376.56	53010
45.40	391.58	53011
45.40	401.27	53012
45.50	406.72	53013
45.45	408.97	53014
45.40	408.97	53015
45.56	407.54	53016
45.56	405.32	53017
45.40	402.72	53018
45.35	400.09	53019
45.40	397.69	53020
45.40	395.66	53021
45.45	393.96	53022
45.40	392.57	53023
45.50	391.55	53024
45.50	390.84	53025
45.40	390.31	53026
45.40	390.01	53027
45.50	389.95	53028
45.40	390.06	53029
45.56	390.19	53030
45.45	390.25	53031
45.61	390.34	53032
45.40	390.48	53033
45.40	390.64	53034
45.40	390.77	53035
45.50	390.89	53036
45.50	391.02	53037
45.29	391.06	53038
45.35	390.96	53039
45.40	390.86	53040
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
