angryseptagon/tDCSDisposable/Coding related /python script and txt file/tDCS_calibration_data_tabsep_3.txt

voltage_output,sense,step#,vbatt = 9.56
45.23	7.74	53001
45.28	35.58	53002
45.28	82.35	53003
45.28	137.49	53004
45.39	193.27	53005
45.34	245.28	53006
45.23	290.95	53007
45.28	328.89	53008
45.34	358.58	53009
45.28	380.33	53010
45.28	395.46	53011
45.34	405.37	53012
45.28	411.11	53013
45.28	413.68	53014
45.23	414.01	53015
45.34	412.91	53016
45.23	410.75	53017
45.28	407.79	53018
45.23	404.79	53019
45.34	402.25	53020
45.28	400.27	53021
45.23	398.55	53022
45.28	396.88	53023
45.34	395.64	53024
45.23	394.77	53025
45.34	393.95	53026
45.23	393.47	53027
45.39	393.48	53028
45.28	393.82	53029
45.13	394.05	53030
45.28	393.93	53031
45.23	393.88	53032
45.23	393.85	53033
45.28	393.57	53034
45.23	393.42	53035
45.23	393.66	53036
45.39	394.11	53037
45.28	394.42	53038
45.28	394.34	53039
45.23	394.28	53040
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
