angryseptagon/tDCSDisposable/Coding related /python script and txt file/tDCS_calibration_data_tabsep_4.txt

voltage_output,sense,step#,vbatt = 9.39
\x9f\xfe45.44	7.60	53001
45.55	35.72	53002
45.55	84.43	53003
45.55	142.39	53004
45.34	200.56	53005
45.45	255.21	53006
45.50	304.24	53007
45.34	345.72	53008
45.29	377.97	53009
45.40	400.65	53010
45.61	416.41	53011
45.82	427.53	53012
45.50	434.74	53013
45.40	438.83	53014
45.29	440.57	53015
45.34	440.66	53016
45.34	438.62	53017
45.55	434.32	53018
45.45	429.95	53019
45.34	426.93	53020
45.34	425.04	53021
45.18	422.94	53022
45.45	419.79	53023
45.40	417.28	53024
45.34	415.37	53025
45.34	412.91	53026
45.45	411.36	53027
45.34	411.54	53028
45.50	412.78	53029
45.39	413.55	53030
45.40	412.90	53031
45.45	412.42	53032
45.66	413.17	53033
45.40	414.66	53034
45.34	416.53	53035
45.55	418.47	53036
45.45	420.28	53037
45.34	420.78	53038
45.34	419.28	53039
45.50	417.68	53040
45.55	417.20	53041
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
