angryseptagon/tDCSDisposable/Coding related /python script and txt file/tDCS_calibration_data_tabsep_5.txt

voltage_output,sense,step#, batt = 7.99
45.35	7.84	53001
45.56	35.77	53002
45.56	82.23	53003
45.56	136.81	53004
45.50	192.18	53005
45.50	243.66	53006
45.50	288.56	53007
45.50	325.62	53008
45.40	354.60	53009
45.50	376.04	53010
45.50	390.95	53011
45.50	400.54	53012
45.50	405.96	53013
45.50	408.26	53014
45.50	408.36	53015
45.56	407.08	53016
45.35	404.94	53017
45.50	402.36	53018
45.50	399.76	53019
45.29	397.39	53020
45.50	395.35	53021
45.50	393.65	53022
45.50	392.29	53023
45.29	391.31	53024
45.56	390.66	53025
45.50	390.23	53026
45.56	390.02	53027
45.45	390.02	53028
45.56	390.18	53029
45.50	390.37	53030
45.50	390.48	53031
45.29	390.55	53032
45.50	390.66	53033
45.56	390.79	53034
45.50	390.93	53035
45.50	391.09	53036
45.50	391.24	53037
45.40	391.30	53038
45.50	391.24	53039
45.56	391.13	53040
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
