angryseptagon/tDCSDisposable/Coding related /python script and txt file/tDCS_calibration_data_tabsep_6.txt

voltage_output,sense,step#, batt =7.76
\x9c\x89\xfe45.23	6.81	53001
45.24	34.84	53002
45.29	88.54	53003
45.23	154.40	53004
45.34	218.88	53005
45.29	280.83	53006
45.19	339.86	53007
45.29	392.26	53008
45.28	432.80	53009
45.39	457.90	53010
45.24	472.01	53011
45.76	480.08	53012
45.34	483.56	53013
45.18	483.74	53014
45.18	481.74	53015
45.29	478.53	53016
45.28	472.91	53017
45.18	464.25	53018
45.24	456.18	53019
45.13	451.01	53020
45.18	448.10	53021
44.81	444.95	53022
45.24	440.03	53023
45.18	436.30	53024
45.39	433.61	53025
45.29	429.80	53026
45.24	427.49	53027
45.13	428.29	53028
45.24	431.02	53029
45.34	432.82	53030
45.13	431.91	53031
45.13	431.34	53032
45.60	432.99	53033
45.13	436.01	53034
45.13	439.77	53035
45.13	443.76	53036
45.19	447.65	53037
45.28	449.03	53038
45.13	446.46	53039
45.24	443.72	53040
45.29	443.32	53041
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
