angryseptagon/tDCSDisposable/Coding related /python script and txt file/tDCS_calibration_data_tabsep_7.txt

voltage_output,sense,step#,v=9.5,r=10k
20.86	7.82	53001
20.86	36.06	53002
20.86	83.74	53003
20.91	140.01	53004
20.91	196.89	53005
20.91	250.04	53006
20.86	296.93	53007
20.81	336.01	53008
20.70	366.53	53009
20.86	388.67	53010
20.81	404.09	53011
20.81	414.35	53012
20.81	420.46	53013
20.86	423.42	53014
20.81	424.10	53015
20.86	423.24	53016
20.75	421.06	53017
20.81	417.81	53018
20.81	414.53	53019
20.91	411.91	53020
20.86	409.89	53021
20.76	408.00	53022
20.81	405.96	53023
20.81	404.40	53024
20.86	403.24	53025
20.81	402.04	53026
20.76	401.31	53027
20.81	401.33	53028
20.81	401.83	53029
20.86	402.16	53030
20.81	401.95	53031
20.81	401.83	53032
20.91	402.18	53033
20.86	402.86	53034
20.91	403.70	53035
20.81	404.57	53036
20.81	405.36	53037
20.75	405.62	53038
20.81	405.07	53039
20.91	404.44	53040
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
