angryseptagon/tDCSDisposable/Coding related /python script and txt file/tDCS_calibration_data_tabsep_8.txt

voltage_output,sense,step#,r =5.1k
\xf910.66	7.84	53001
10.66	36.22	53002
10.77	84.25	53003
10.76	141.03	53004
10.66	198.36	53005
10.66	251.88	53006
10.82	299.09	53007
10.71	338.49	53008
10.66	369.23	53009
10.66	391.47	53010
10.71	406.91	53011
10.71	417.23	53012
10.61	423.43	53013
10.71	426.46	53014
10.77	427.21	53015
10.77	426.42	53016
10.66	424.28	53017
10.77	421.01	53018
10.82	417.75	53019
10.76	415.19	53020
10.82	413.28	53021
10.71	411.42	53022
10.77	409.30	53023
10.77	407.65	53024
10.76	406.44	53025
10.71	405.14	53026
10.66	404.34	53027
10.77	404.36	53028
10.66	404.89	53029
10.66	405.24	53030
10.71	405.02	53031
10.77	404.90	53032
10.76	405.27	53033
10.66	405.93	53034
10.71	406.70	53035
10.66	407.46	53036
10.71	408.15	53037
10.71	408.30	53038
10.61	407.63	53039
10.66	406.91	53040
10.87	406.67	53041
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
