angryseptagon/tDCSDisposable/Coding related /python script and txt file/tDCS_calibration_data_tabsep_9.txt

voltage_output,sense,step#,r = 33k
\x93\x13\xf350.57	7.50	53001
50.57	34.30	53002
50.52	79.00	53003
50.57	131.57	53004
50.42	184.88	53005
50.47	234.48	53006
50.42	277.77	53007
50.42	313.50	53008
50.42	341.40	53009
50.52	361.95	53010
50.47	376.21	53011
50.57	385.35	53012
50.42	390.53	53013
50.52	392.74	53014
50.57	392.85	53015
50.42	391.63	53016
50.42	389.63	53017
50.47	387.25	53018
50.42	384.84	53019
50.52	382.62	53020
50.42	380.73	53021
50.52	379.15	53022
50.47	377.83	53023
50.47	376.81	53024
50.52	376.10	53025
50.42	375.59	53026
50.47	375.30	53027
50.42	375.18	53028
50.42	375.20	53029
50.57	375.27	53030
50.42	375.32	53031
50.42	375.38	53032
50.47	375.45	53033
50.52	375.44	53034
50.42	375.42	53035
50.47	375.47	53036
50.47	375.61	53037
50.47	375.73	53038
50.68	375.72	53039
50.47	375.68	53040
50.42	375.70	53041
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
