angryseptagon/tDCSDisposable/calibration data/ramp calibration v2.xlsx

Sheet: Sheet1
mA | voltage (estimation) | output | voltage (estimation) |  | mA | output
2 | 40 | 13312 | 266240 |  | 2 | 46080
1.99 | 39.8 | 12416 | 248320 |  | 1.99 | 45184
1.9 | 38 | 7552 | 151040 |  | 1.9 | 40320
1.8 | 36 | 6656 | 133120 |  | 1.8 | 39424
1.7 | 34 | 6400 | 128000 |  | 1.7 | 39168
1.61 | 32.2 | 6272 | 125440 |  | 1.61 | 39040
1.5 | 30 | 6336 | 126720 |  | 1.5 | 39104
1.2 | 24 | 6208 | 124160 |  | 1.2 | 38976
1.13 | 22.6 | 6208 | 124160 |  | 1.13 | 38976
0.69 | 13.8 | 6114 | 122280 |  | 0.69 | 38882
0.44 | 8.8 | 6016 | 120320 |  | 0.44 | 38784
0 | 0 | 5888 | 117760 | 0 | 0 | 38656
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
