angryseptagon/tDCSDisposable/photos and videos/2ndcalibration.PNG

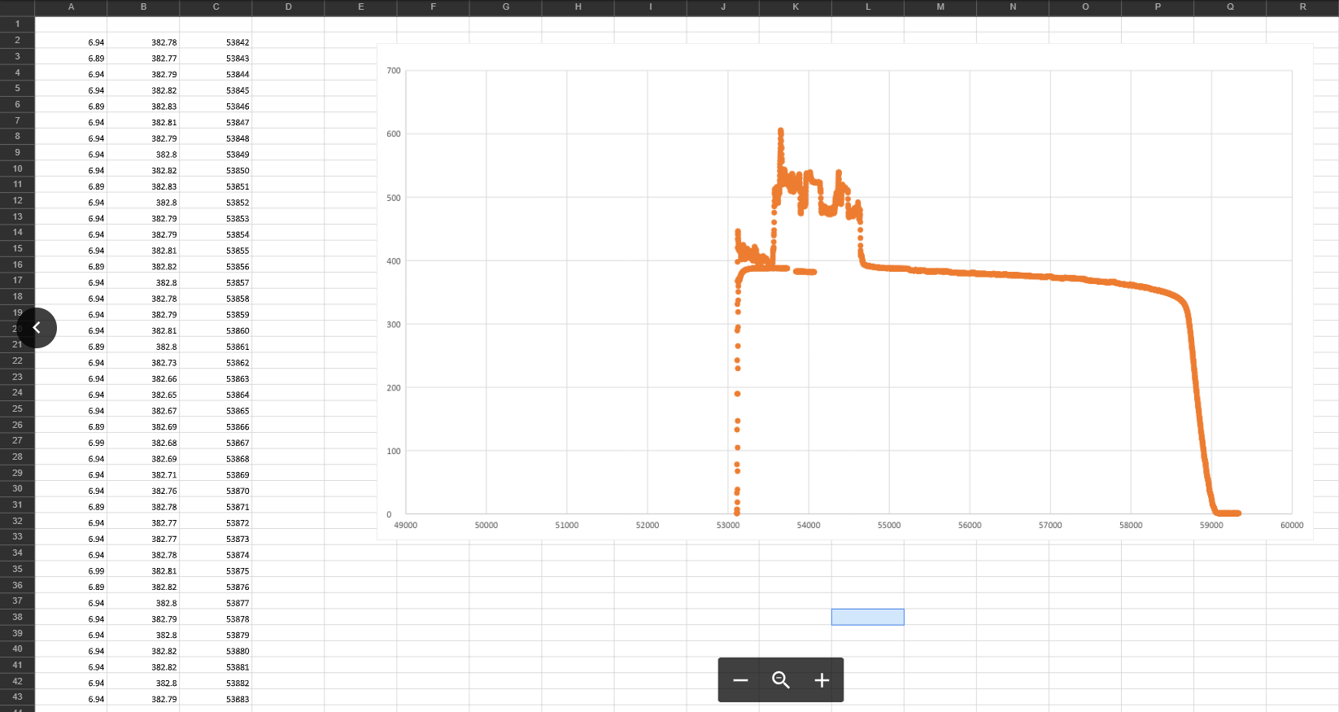
photos and videos/2ndcalibration.PNG
