angryseptagon/tDCSDisposable/photos and videos/calibration graph.tif

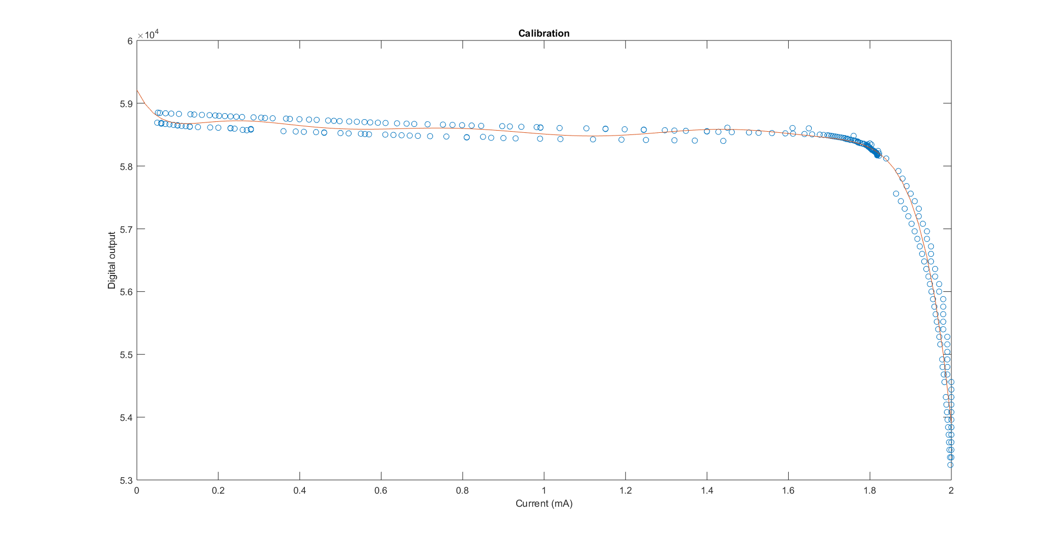
photos and videos/calibration graph.tif
