angryseptagon/tDCSDisposable/PCB files/tDCS_newcircuit/_saved__saved_tDCS-B.Cu.pdf

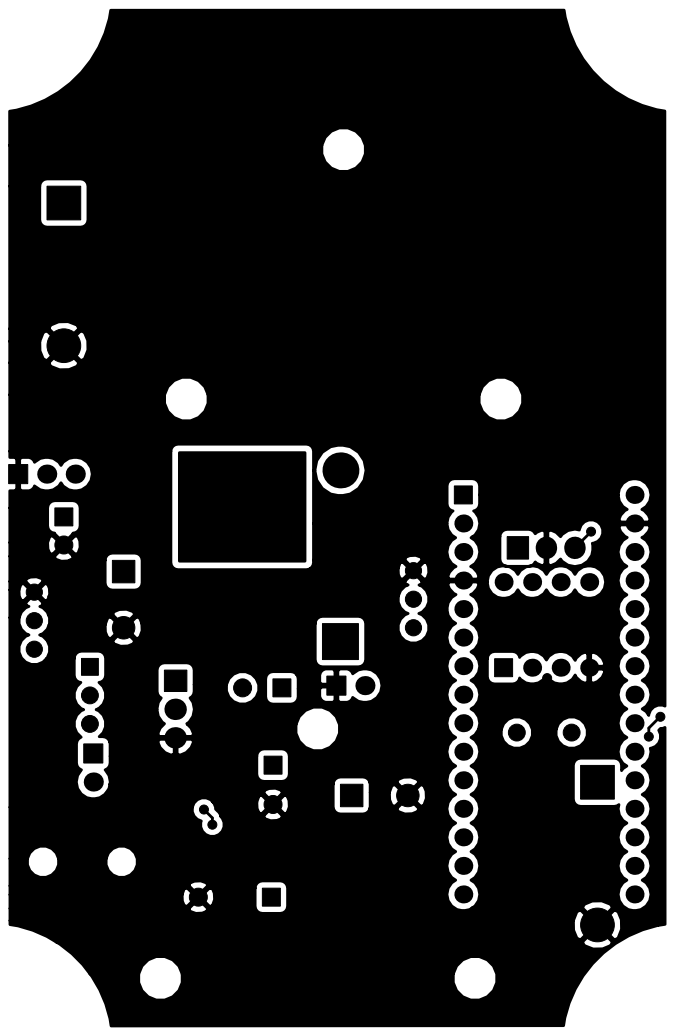
[picture p102: page 1]
