angryseptagon/tDCSDisposable/PCB files/tDCS_newcircuit/_saved__saved_tDCS-B.Mask.pdf

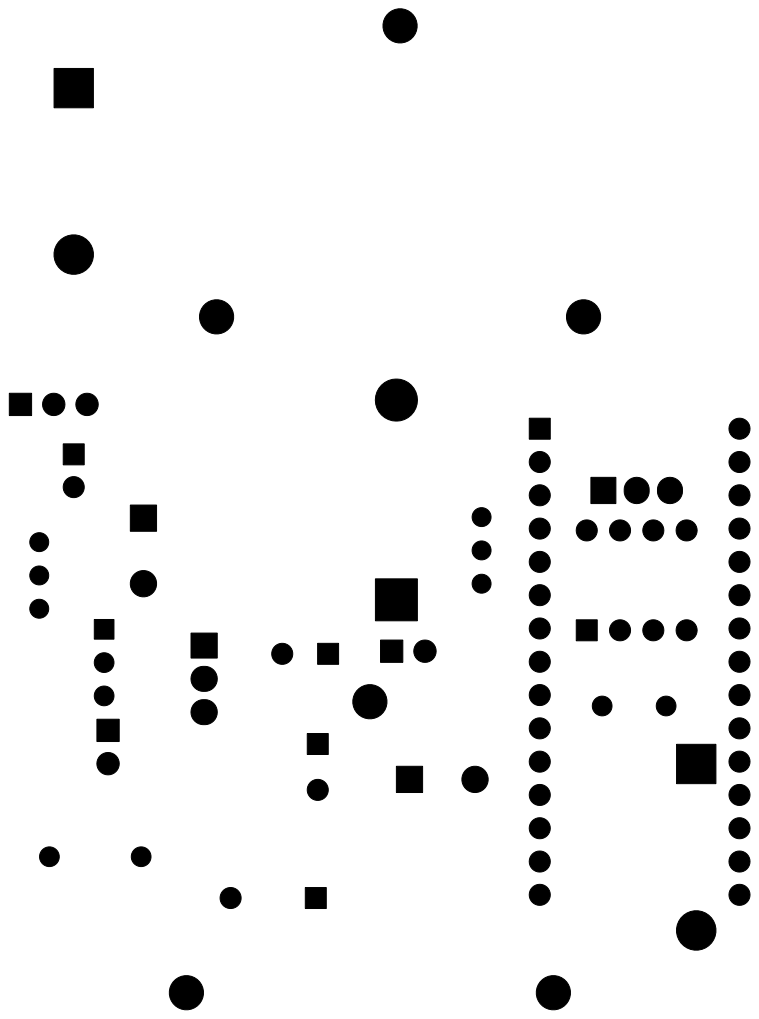
[picture p103: page 1]
