angryseptagon/tDCSDisposable/PCB files/tDCS_newcircuit/_saved__saved_tDCS-Edge.Cuts.pdf

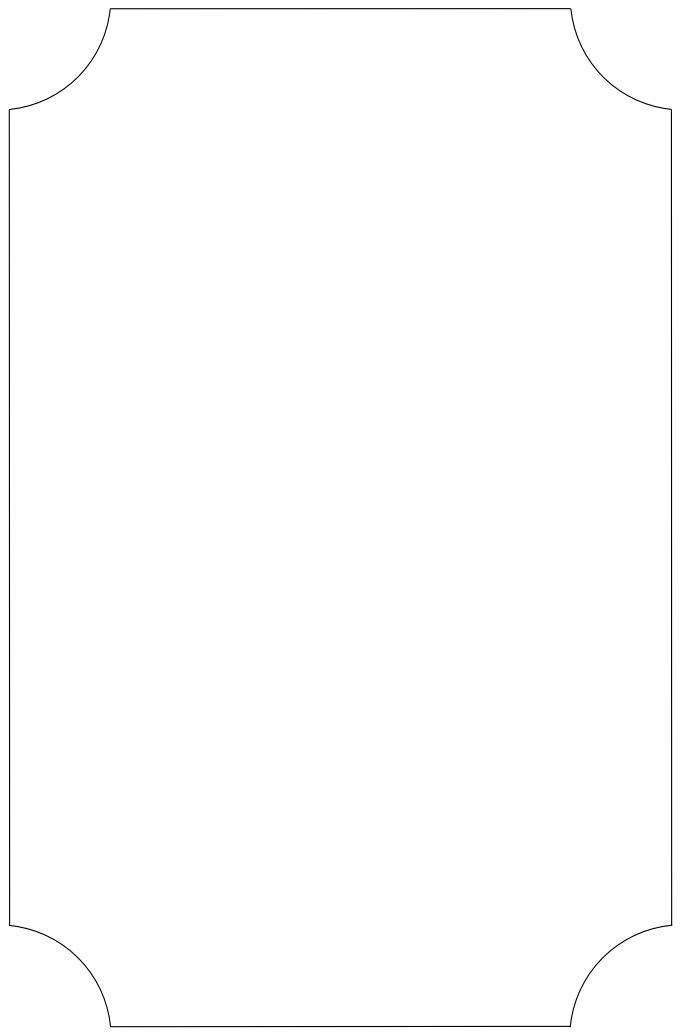
[picture p104: page 1]
