angryseptagon/tDCSDisposable/PCB files/tDCS_newcircuit/_saved__saved_tDCS-F.Cu.pdf

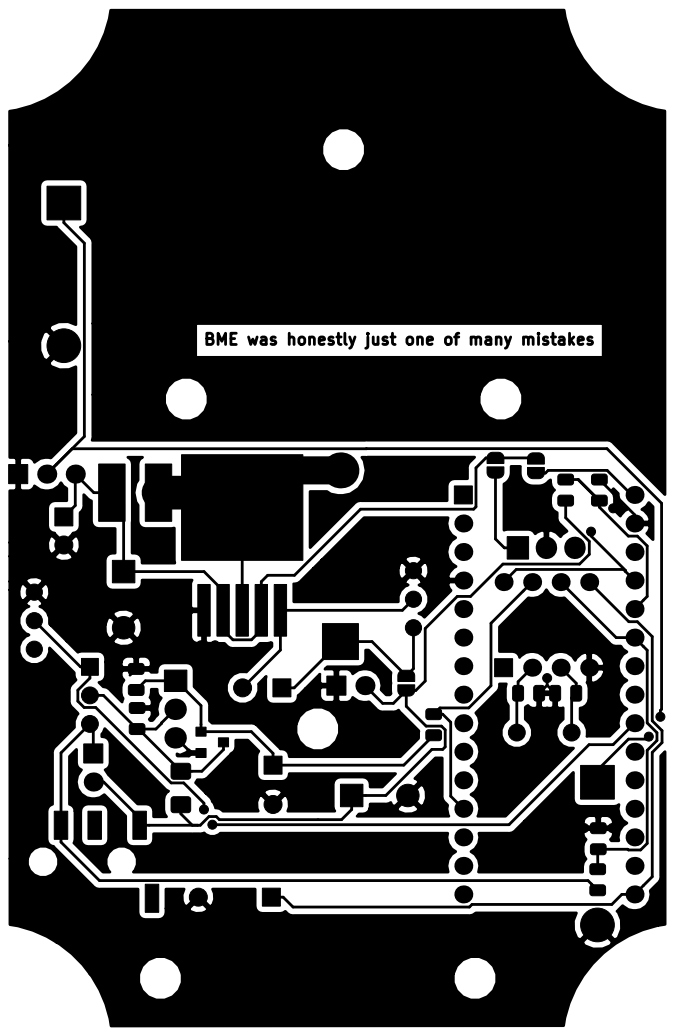
[picture p105: page 1]

BME was honestly just one of many mistakes
