angryseptagon/tDCSDisposable/PCB files/tDCS_newcircuit/_saved__saved_tDCS-F.Mask.pdf

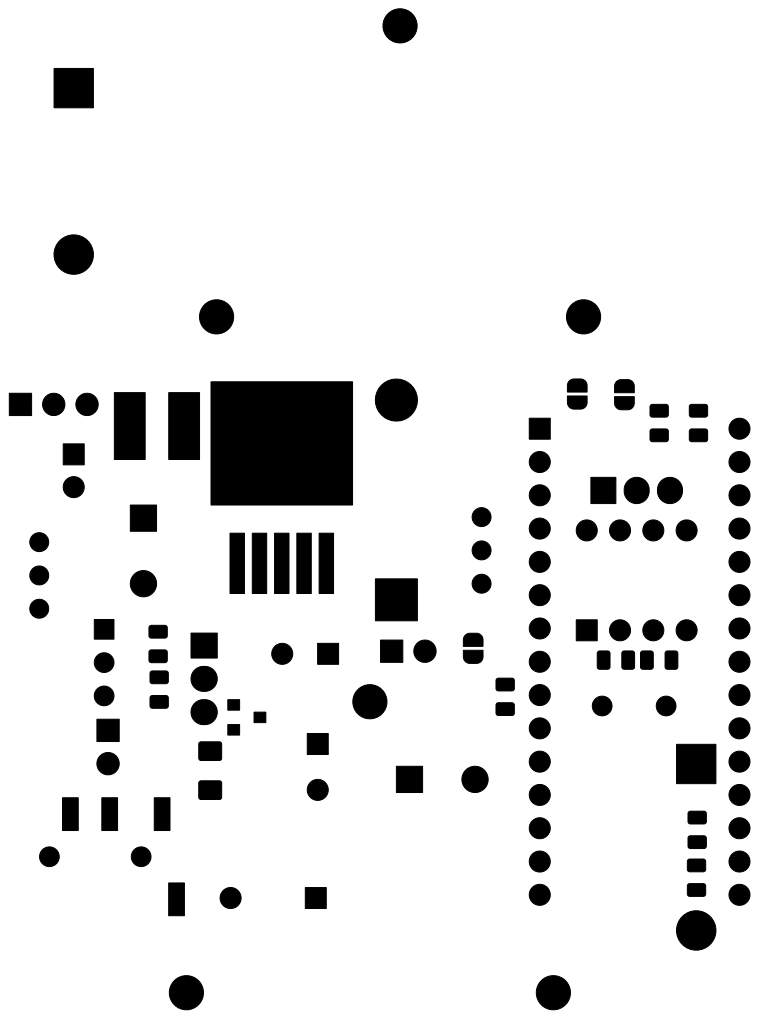
[picture p106: page 1]
