angryseptagon/tDCSDisposable/PCB files/tDCS_newcircuit/_saved__saved_tDCS-F.Paste.pdf

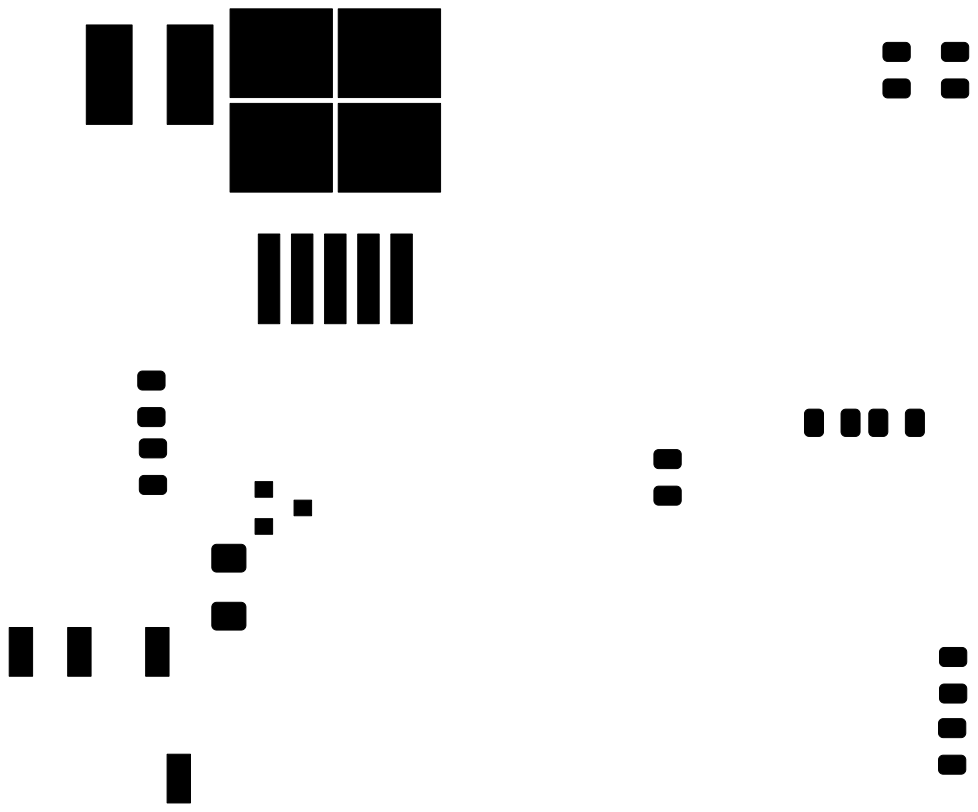
[picture p107: page 1]
