angryseptagon/tDCSDisposable/PCB files/tDCS_newcircuit/_saved__saved_tDCS-F.SilkS.pdf

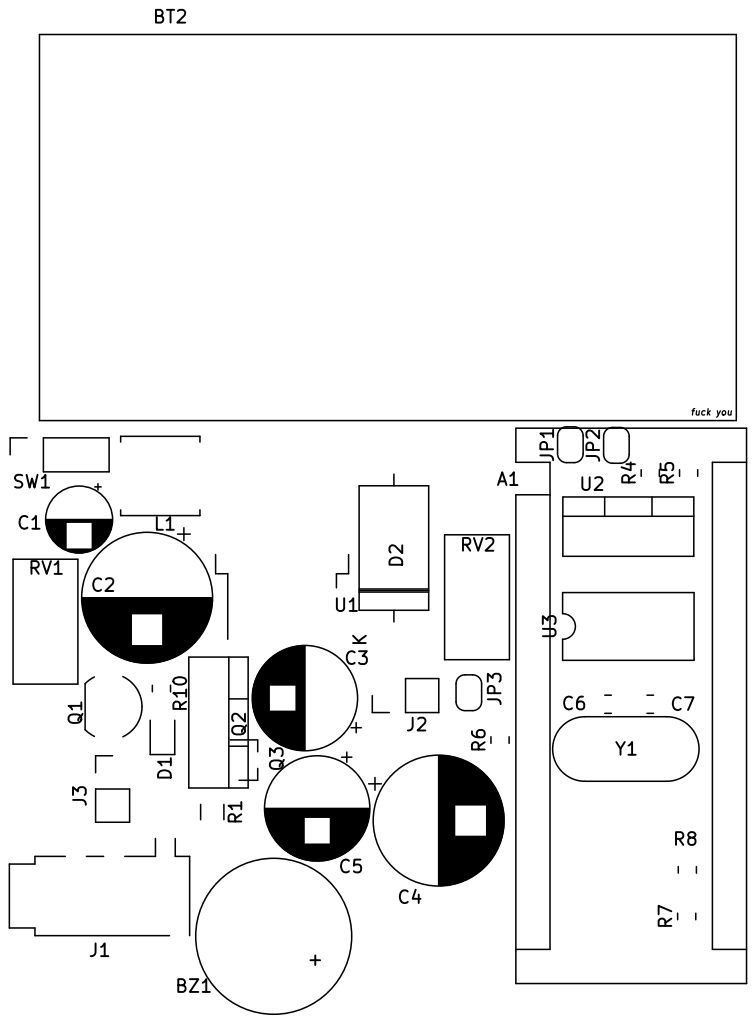
[picture p108: page 1]
