angryseptagon/tDCSDisposable/PCB files/tDCS_newcircuit/New folder/_saved__saved_tDCS-B.Cu.pdf

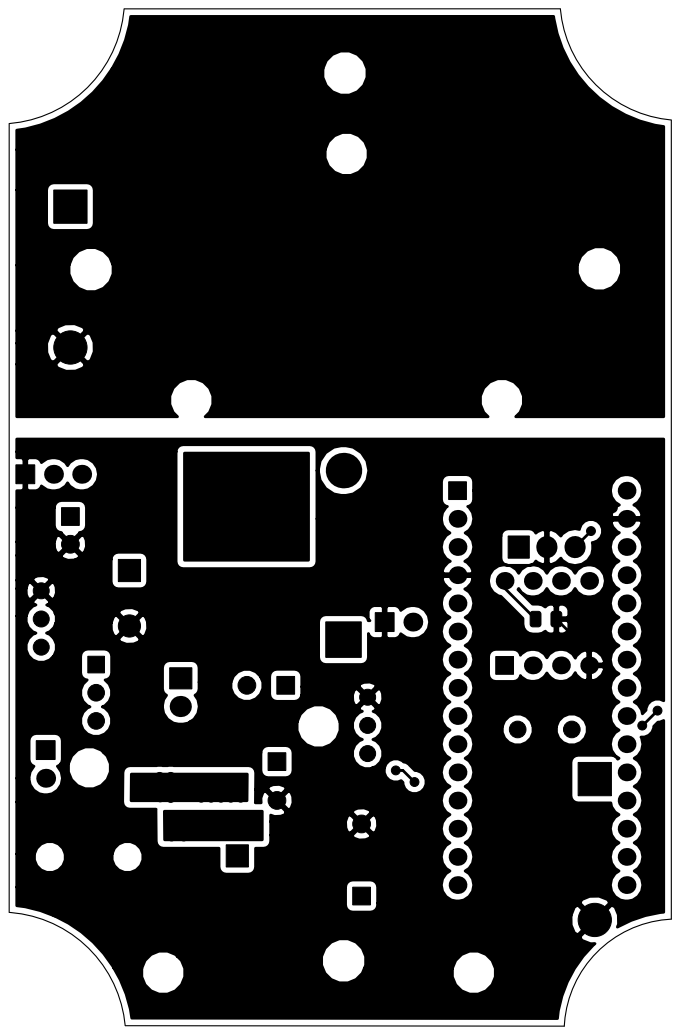
[picture p109: page 1]
