angryseptagon/tDCSDisposable/PCB files/tDCS_newcircuit/New folder/_saved__saved_tDCS-B.Mask.pdf

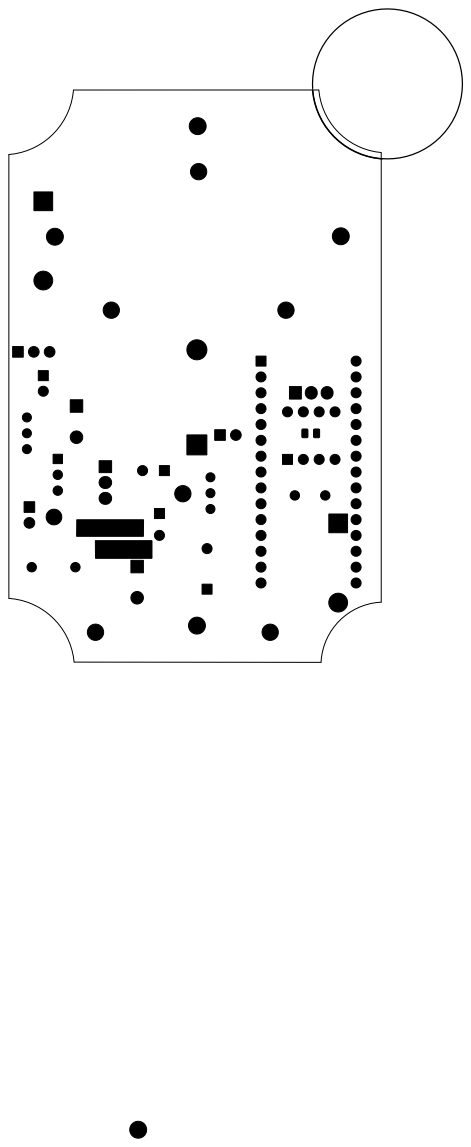
[picture p110: page 1]
