angryseptagon/tDCSDisposable/PCB files/tDCS_newcircuit/New folder/_saved__saved_tDCS-B.Paste.pdf

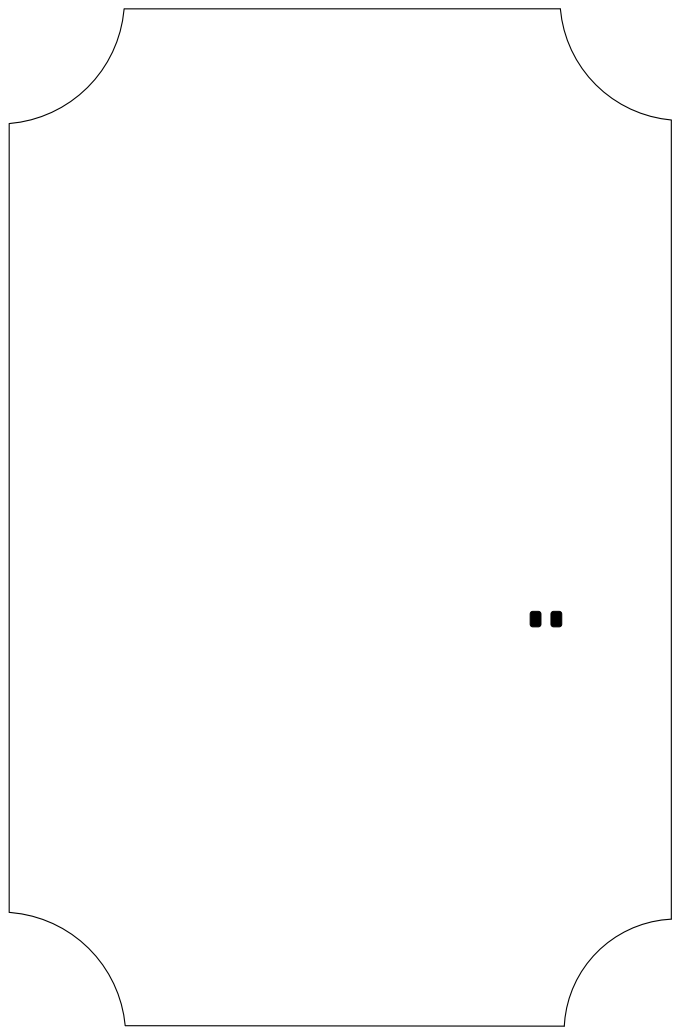
[picture p111: page 1]
