angryseptagon/tDCSDisposable/PCB files/tDCS_newcircuit/New folder/_saved__saved_tDCS-B.SilkS.pdf

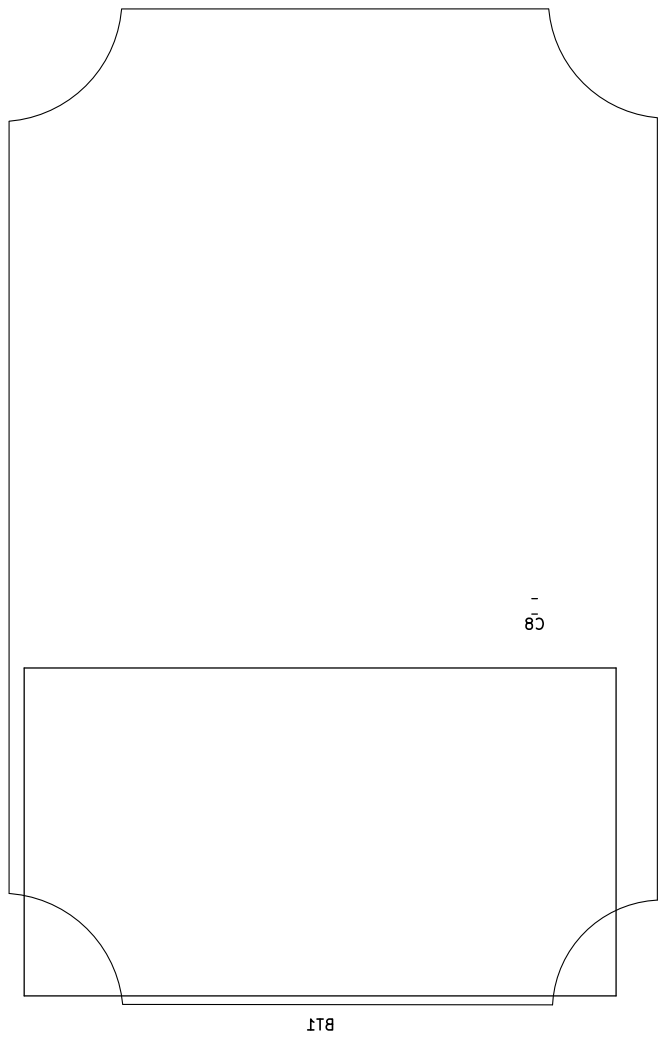
[picture p112: page 1]
