angryseptagon/tDCSDisposable/PCB files/tDCS_newcircuit/New folder/_saved__saved_tDCS-Edge.Cuts.pdf

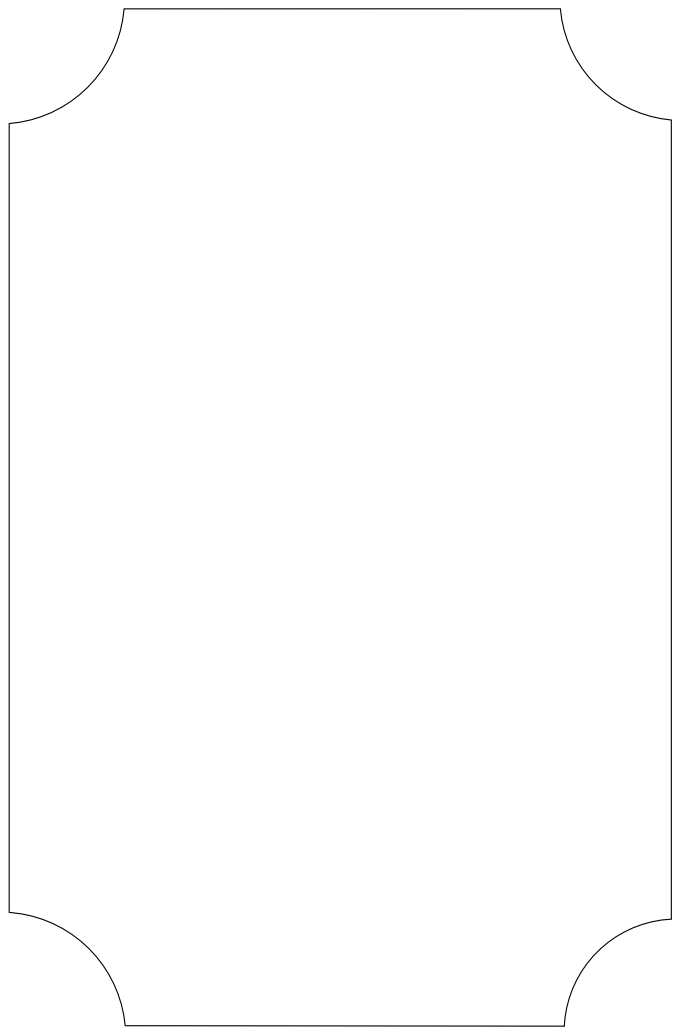
[picture p113: page 1]
