angryseptagon/tDCSDisposable/PCB files/tDCS_newcircuit/New folder/_saved__saved_tDCS-F.Cu.pdf

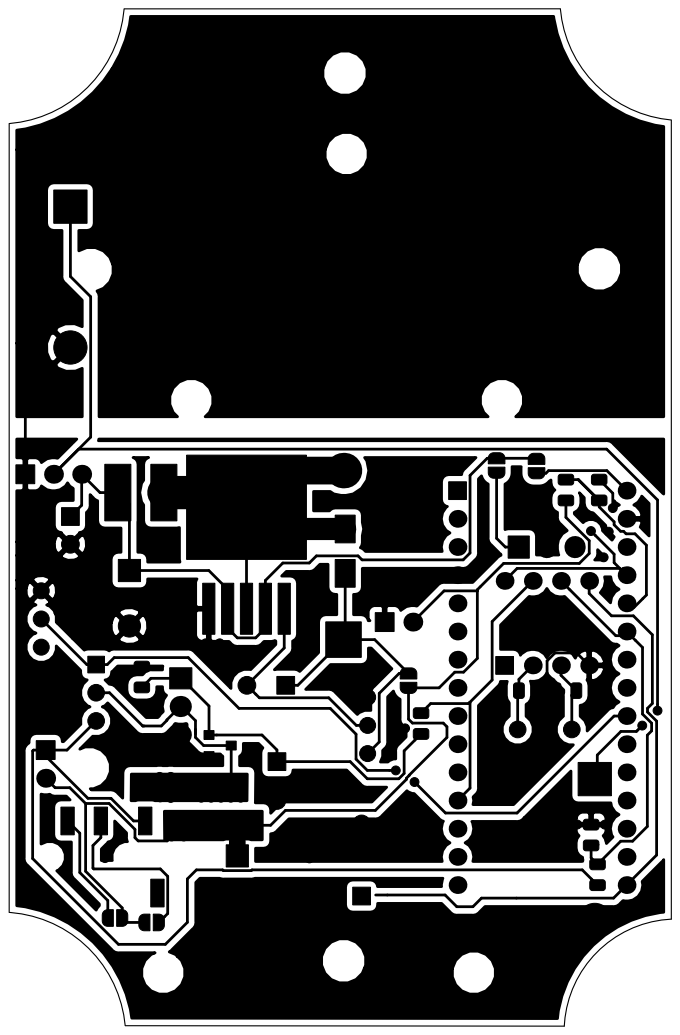
[picture p114: page 1]
