angryseptagon/tDCSDisposable/PCB files/tDCS_newcircuit/New folder/_saved__saved_tDCS-F.Mask.pdf

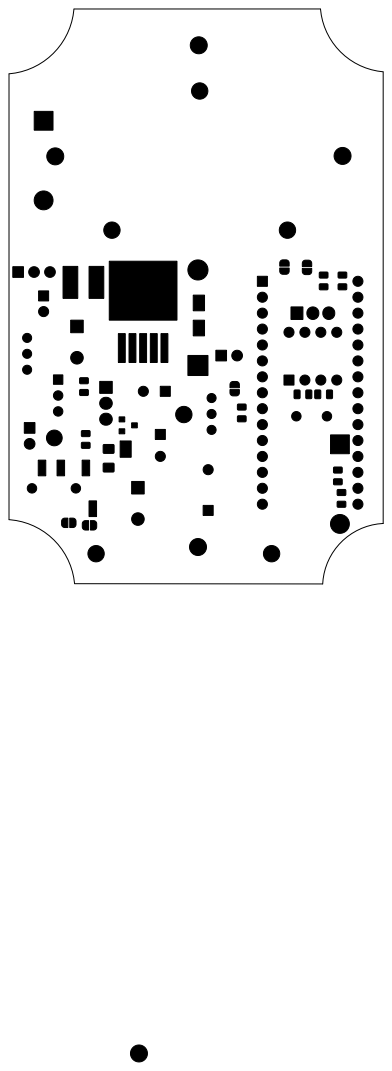
[picture p115: page 1]
