angryseptagon/tDCSDisposable/PCB files/tDCS_newcircuit/New folder/_saved__saved_tDCS-F.Paste.pdf

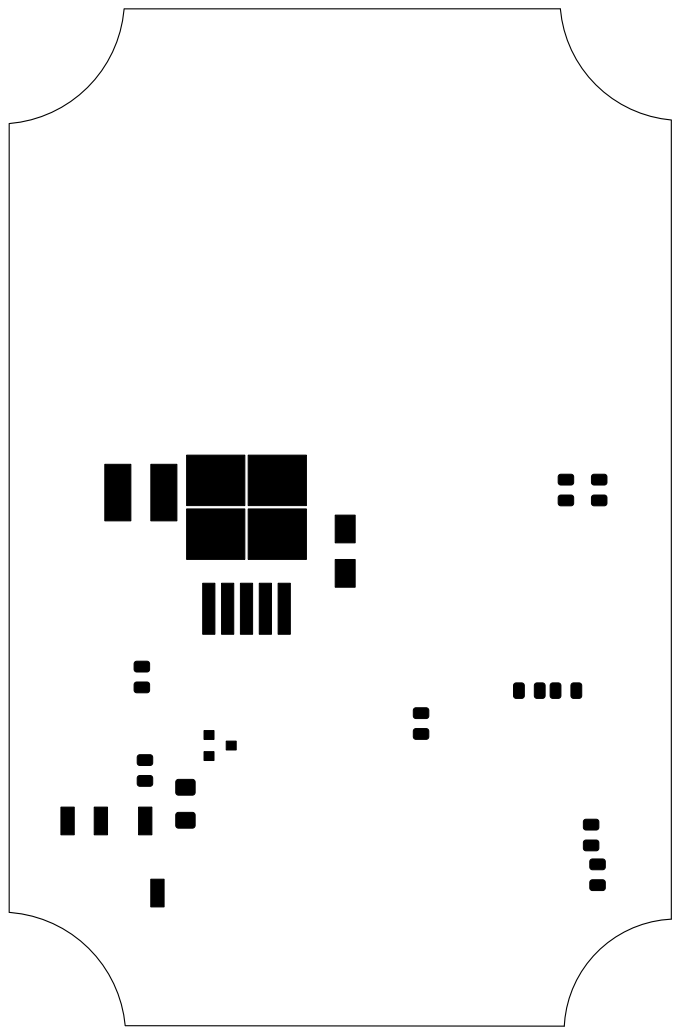
[picture p116: page 1]
