angryseptagon/tDCSDisposable/PCB files/tDCS_newcircuit/New folder/_saved__saved_tDCS-F.SilkS.pdf

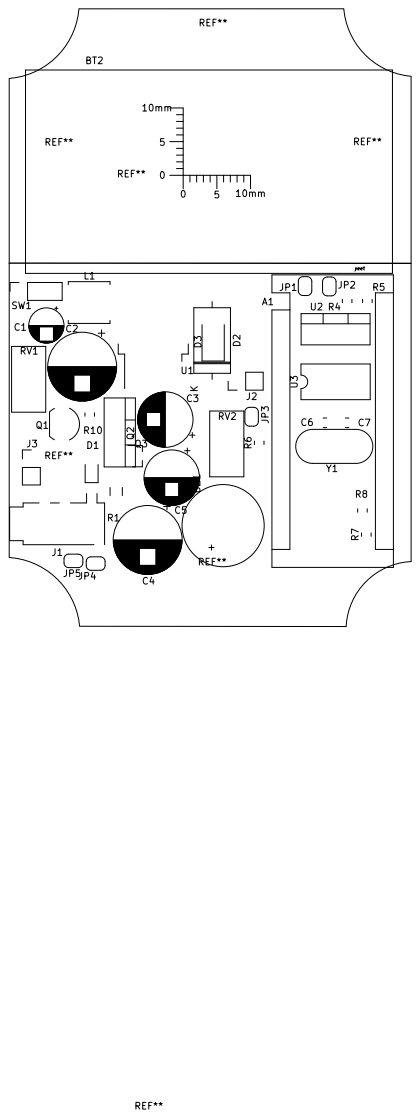
[picture p117: page 1]
