angryseptagon/tDCSDisposable/(list of files, drawings)

Other design files:
circuit/1mAtdcs(1).ms14
circuit/1mAtdcs.ms14
circuit/bjt tdcs V2.ms14
circuit/bjt tdcs V3.ms14
circuit/bjt tdcs V4.ms14
circuit/bjt tdcs V5 (for voltage measurement).ms14
circuit/bjt tdcs V6.ms14
circuit/bjt tdcs V7.ms14
circuit/circuit output data/Design1.ms14
circuit/Design1.ms14
circuit/inthinkeratorV2.ms14
circuit/opampDesign1.ms14
circuit/timer.ms14
