angryseptagon/tDCSDisposable/PCB files/tDCS_newcircuit/_saved__saved_tDCS.kicad_pcb

## KiCad design PCB files/tDCS_newcircuit/_saved__saved_tDCS.kicad_pcb (2021-02-18)

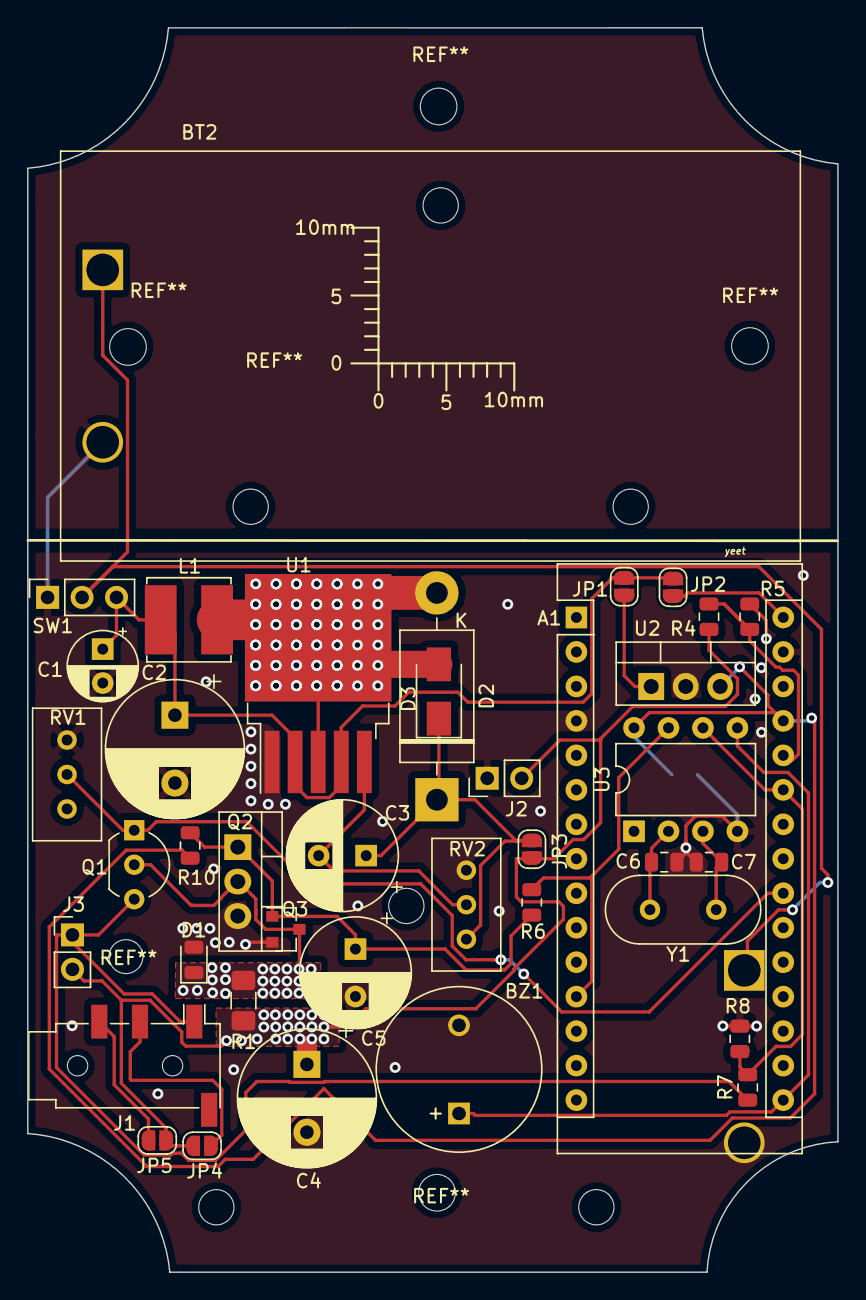
[picture p118: board _saved__saved_tDCS.kicad_pcb from above]

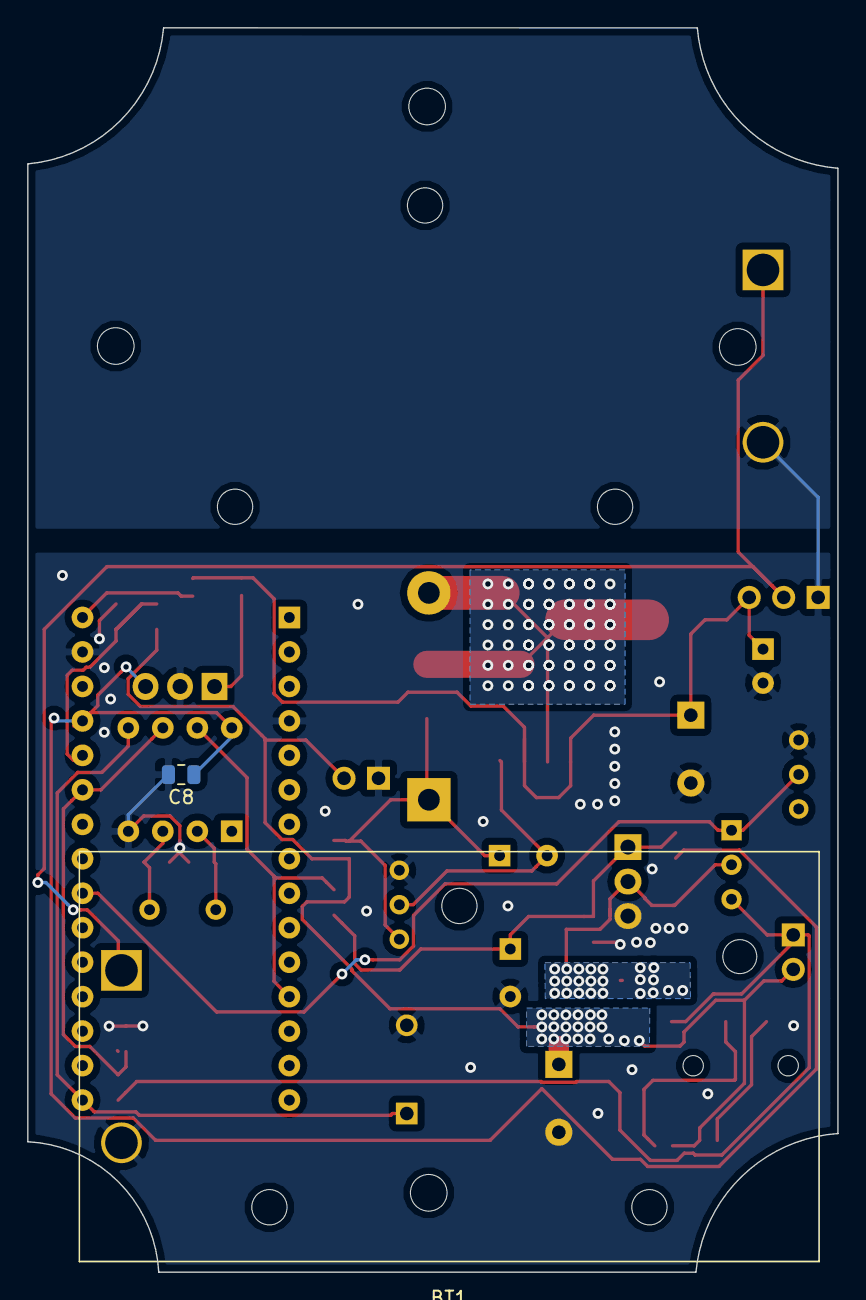
[picture p119: board _saved__saved_tDCS.kicad_pcb from below]

Board: 2 copper layers, 59.7 x 91.7 mm, 41 parts (2 on the bottom side), 22 nets.

Parts:
A1: Arduino_Nano_v3.x; Arduino_Nano
BT1, BT2: Battery_Cell; BatteryHolder_Eagle_12BH611-GR
BZ1: Buzzer; MagneticBuzzer_ProSignal_ABT-410-RC
C1: 47uF; CP_Radial_D5.0mm_P2.50mm
C2, C4: 220uF; CP_Radial_D10.0mm_P5.00mm
C3: 10uF; CP_Radial_D8.0mm_P3.50mm
C5: 100uF; CP_Radial_D8.0mm_P3.50mm
C6, C7: 22pf; C_0805_2012Metric
C8: .1uf; C_0805_2012Metric
D1: DIODE; D_0805_2012Metric
D2: MBR560; D_DO-201AD_P15.24mm_Horizontal
D3: SS16; D_SMA
J1: AudioJack4; Jack_3.5mm_PJ320D_Horizontal
J2, J3: Conn_01x02_Male; PinHeader_1x02_P2.54mm_Vertical
JP1, JP2, JP3, JP4, JP5: SolderJumper_2_Open; SolderJumper-2_P1.3mm_Open_RoundedPad1.0x1.5mm
L1: 33uh; L_Bourns_SRN6045TA
Q1: 2N3904; TO-92_Inline_Wide
Q2: IRL2203; TO-220-3_Vertical
Q3: BSS138; SOT-23
R1: 20k; R_1206_3216Metric_Pad1.42x1.75mm_HandSolder
R4, R7: 800K; R_0805_2012Metric
R5, R8: 80K; R_0805_2012Metric
R6: 10k; R_0805_2012Metric
R10: 10 kOhm; R_0805_2012Metric
RV1: 2k pot; Potentiometer_Bourns_3386C_Horizontal
RV2: R_POT; Potentiometer_Bourns_3386C_Horizontal
SW1: SW_SPDT; PinSocket_1x03_P2.54mm_Vertical
U1: XL6009; TO-263-5_TabPin3
U2: L7805; TO-220-3_Vertical
U3: ATtiny85-20PU; DIP-8_W7.62mm
Y1: Crystal; Crystal_HC49-4H_Vertical

Connections:
+5V: A1.27, C8.1, R10.1, U2.3, U3.8
+9V: C1.1, C2.1, JP1.2, JP2.2, L1.1, SW1.3, U1.2, U1.4
/A3: A1.22, Q1.1, RV1.2
/A6: A1.25, R7.2, R8.1, U3.6
/A7: A1.26, R4.2, R5.1
/XTAL1: C6.2, U3.2, Y1.1
/XTAL2: C7.1, U3.3, Y1.2
/buzzer: A1.16, BZ1.1, U3.5
GND: A1.4, A1.29, BT1.2, BT2.2, BZ1.2, C1.2, C2.2, C4.2, C5.2, C6.1, C7.2, C8.2, D1.2, J2.1, Q2.3, Q3.2, R5.2, R8.2, RV1.1, RV2.3, SW1.1, U1.1, U2.2, U3.4
unnamed: A1.30, JP2.1
unnamed: BT1.1, BT2.1, SW1.2
unnamed: C3.1, D2.1, D3.1, JP3.1, RV2.1
unnamed: C3.2, RV2.2, U1.5
unnamed: C5.1, Q2.1, Q3.1, R6.1, R10.2
unnamed: D1.1, Q1.2, Q2.2, Q3.3, R1.1
unnamed: D2.2, D3.2, L1.2, U1.3
unnamed: J1.R1, JP4.1
unnamed: J1.S, JP5.1
unnamed: J1.T, J3.1, Q1.3, R7.1
unnamed: JP1.1, U2.1
boostout+: C4.1, J2.2, J3.2, JP3.2, JP4.2, JP5.2, R1.2, R4.1
gate_control: A1.12, R6.2, U3.7
