angryseptagon/tDCSDisposable/circuit/tDCS/_saved_tDCS.kicad_pcb

## KiCad design circuit/tDCS/_saved_tDCS.kicad_pcb (2021-02-18)

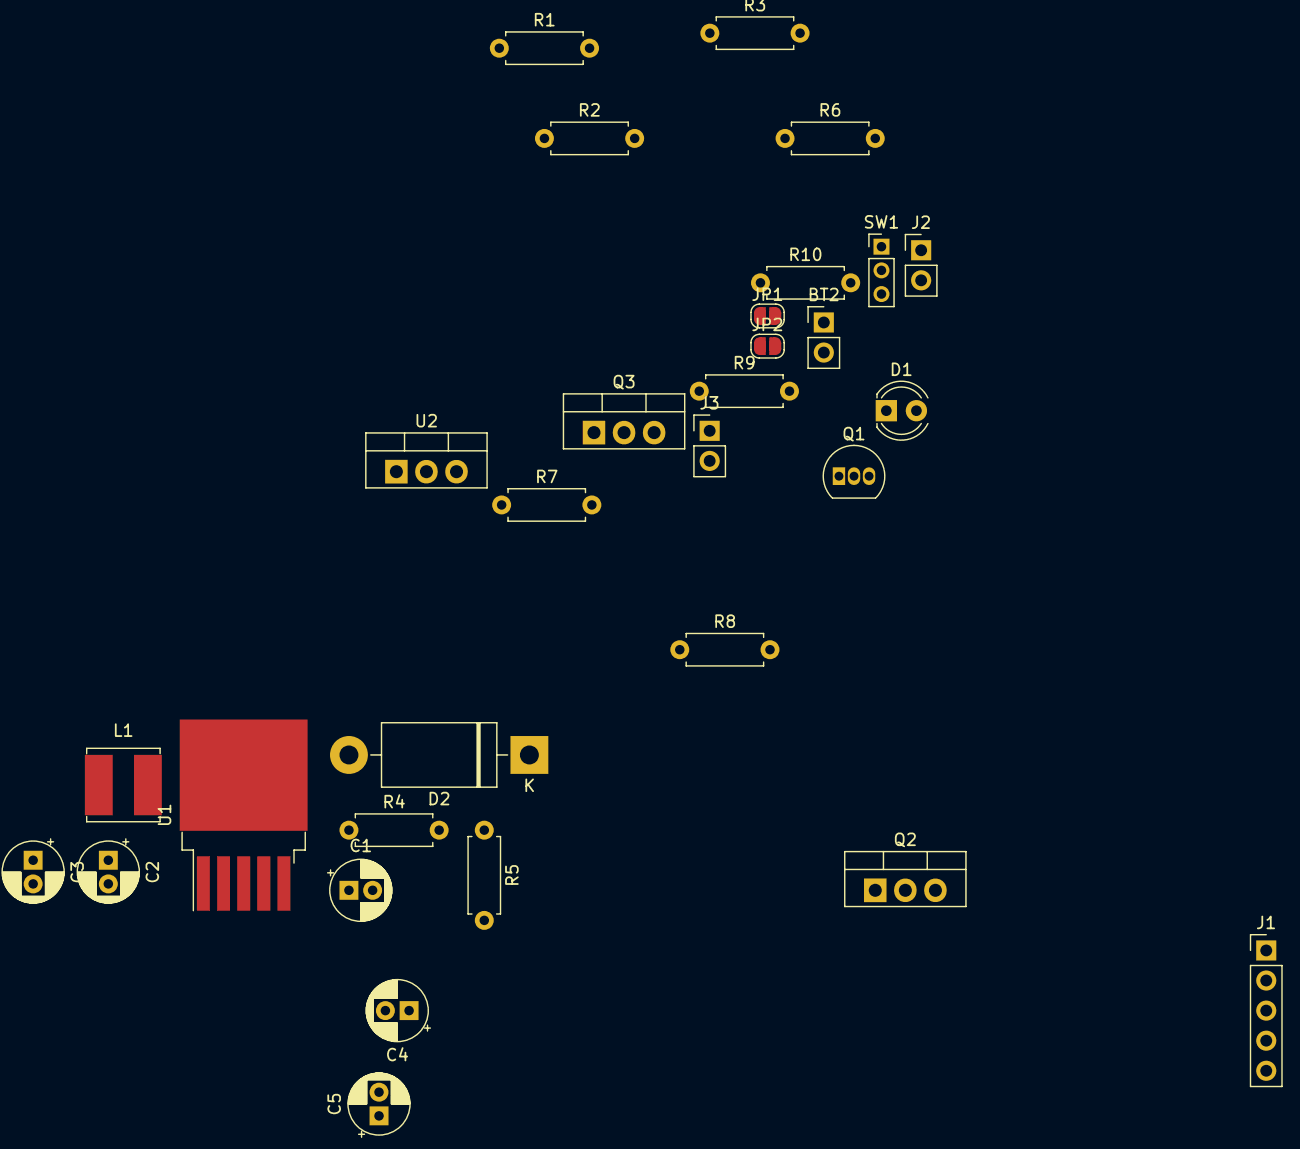
[picture p120: board _saved_tDCS.kicad_pcb from above]

Board: 2 copper layers, 30 parts (0 on the bottom side), 18 nets, no tracks yet.

Parts:
BT2: Battery_Cell; PinHeader_1x02_P2.54mm_Vertical
C1: 10uf; CP_Radial_D5.0mm_P2.00mm
C2, C4: 220uF; CP_Radial_D5.0mm_P2.00mm
C3: 47uF; CP_Radial_D5.0mm_P2.00mm
C5: 100uF; CP_Radial_D5.0mm_P2.00mm
D1: DIODE; LED_D4.0mm
D2: 1N5821; D_DO-201AD_P15.24mm_Horizontal
J1: Conn_01x05_Male; PinHeader_1x05_P2.54mm_Vertical
J2, J3: Conn_01x02_Male; PinHeader_1x02_P2.54mm_Vertical
JP1, JP2: SolderJumper_2_Open; SolderJumper-2_P1.3mm_Open_RoundedPad1.0x1.5mm
L1: 33uh; L_Bourns_SRN6045TA
Q1: 2N3904; TO-92_Inline
Q2, Q3: IRL2203; TO-220-3_Vertical
R1, R9: 20k; R_Axial_DIN0207_L6.3mm_D2.5mm_P7.62mm_Horizontal
R2: 1.351 kOhm; R_Axial_DIN0207_L6.3mm_D2.5mm_P7.62mm_Horizontal
R3: 680; R_Axial_DIN0207_L6.3mm_D2.5mm_P7.62mm_Horizontal
R4: 31K; R_Axial_DIN0207_L6.3mm_D2.5mm_P7.62mm_Horizontal
R5: 1K; R_Axial_DIN0207_L6.3mm_D2.5mm_P7.62mm_Horizontal
R6: 10k; R_Axial_DIN0207_L6.3mm_D2.5mm_P7.62mm_Horizontal
R7: 1 Ohm; R_Axial_DIN0207_L6.3mm_D2.5mm_P7.62mm_Horizontal
R8, R10: 10 kOhm; R_Axial_DIN0207_L6.3mm_D2.5mm_P7.62mm_Horizontal
SW1: SW_SPDT; PinHeader_1x03_P2.00mm_Vertical
U1: XL6009; TO-263-5_TabPin3
U2: L7805; TO-220-3_Vertical

Connections:
+5V: J1.2, U2.3
+9V: BT2.1, JP1.1, U1.2, U2.1
unnamed: C1.1, D2.1, JP2.1, R4.1
unnamed: C1.2, R4.2, R5.1, U1.5
unnamed: C2.1, C3.1, L1.1, SW1.3, U1.4
unnamed: C5.1, Q2.1, R6.1, R10.1
unnamed: D1.1, Q1.2, Q2.2, R1.1
unnamed: D2.2, L1.2, U1.3
unnamed: J1.1, Q3.3, R7.1
unnamed: J1.4, Q3.1, R8.1
unnamed: J1.5, R6.2
unnamed: J3.1, Q1.3
unnamed: J3.2, R3.1, R9.2
unnamed: JP1.2, SW1.2
unnamed: Q1.1, R2.1
unnamed: Q3.2, R9.1
boostout+: C4.1, J2.2, JP2.2, R1.2, R3.2
boostout-: BT2.2, C2.2, C3.2, C4.2, C5.2, D1.2, J1.3, J2.1, Q2.3, R2.2, R5.2, R7.2, R8.2, R10.2, U1.1, U2.2
