angryseptagon/tDCSDisposable/Coding related /Arduino Code/EqtofindCurr/EqtofindCurr.ino

void setup() {
  // put your setup code here, to run once:

}

void loop() {
  // put your main code here, to run repeatedly:

}
float mout = 59210.9957064942*pow(curr,9)+  -13169.5007497324*pow(curr,8)+ 120531.361747551*pow(curr,7)+  -530395.030431162**pow(curr,6)+ 1278069.41053836*pow(curr,5)+  -1812117.26955128**pow(curr,4)+ 1550518.46759775*pow(curr,3)+ -786439.231748774*pow(curr,2) + 217601.061216504*curr + -25301.0215722490;
