angryseptagon/tDCSDisposable/(notices)

Notices in the files:
Coding related /Arduino Code/serial debug/TinyDebugSerial.h:
under the terms of the GNU Lesser General Public License as published by
the Free Software Foundation, either version 3 of the License, or (at your
