angryseptagon/tDCSDisposable/circuit/20190315_172530.jpg

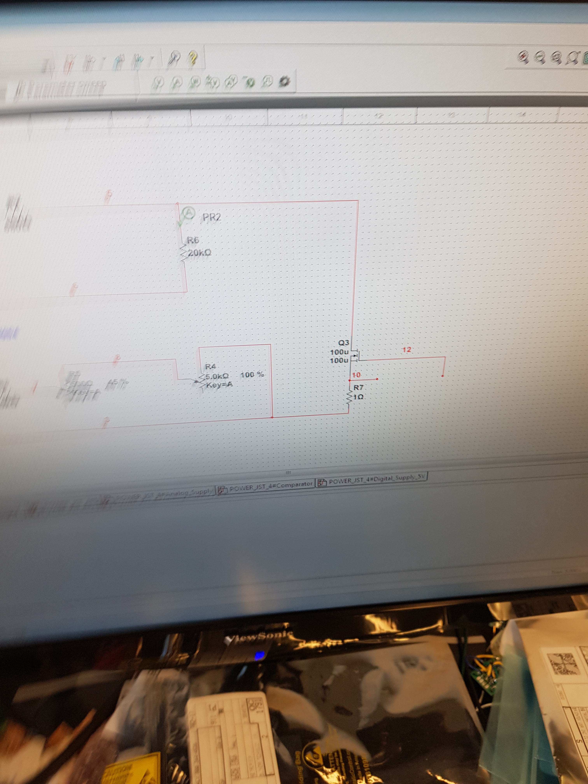
circuit/20190315_172530.jpg
